dffgvhbbjk/2026-NUEDC/analysis_plots/summary_stats.png

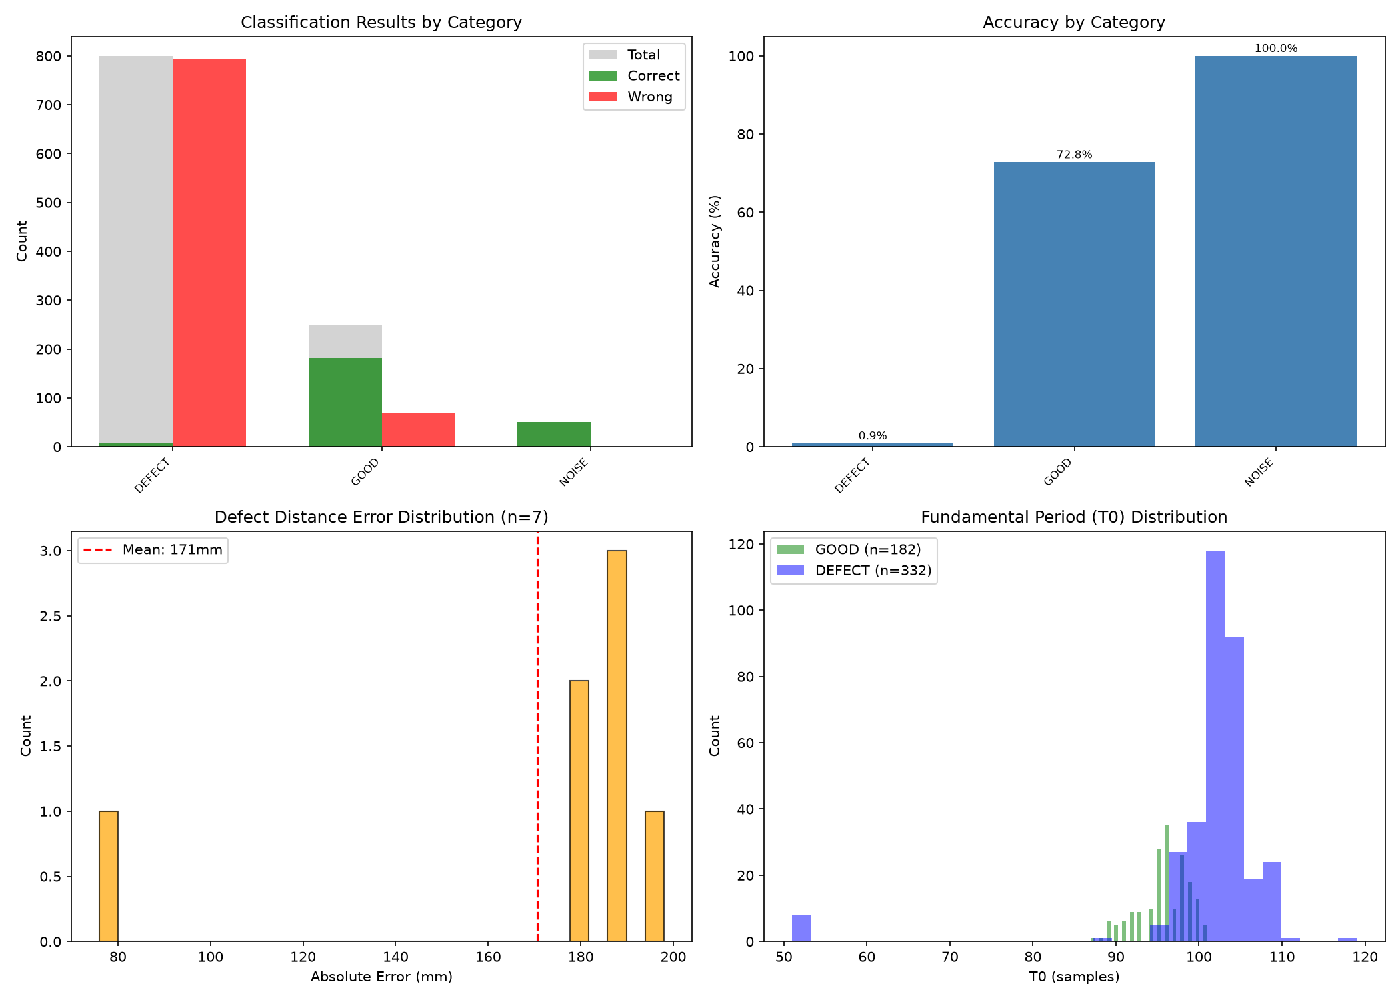
analysis_plots/summary_stats.png
