dffgvhbbjk/2026-NUEDC/analysis_plots/waveform_examples.png

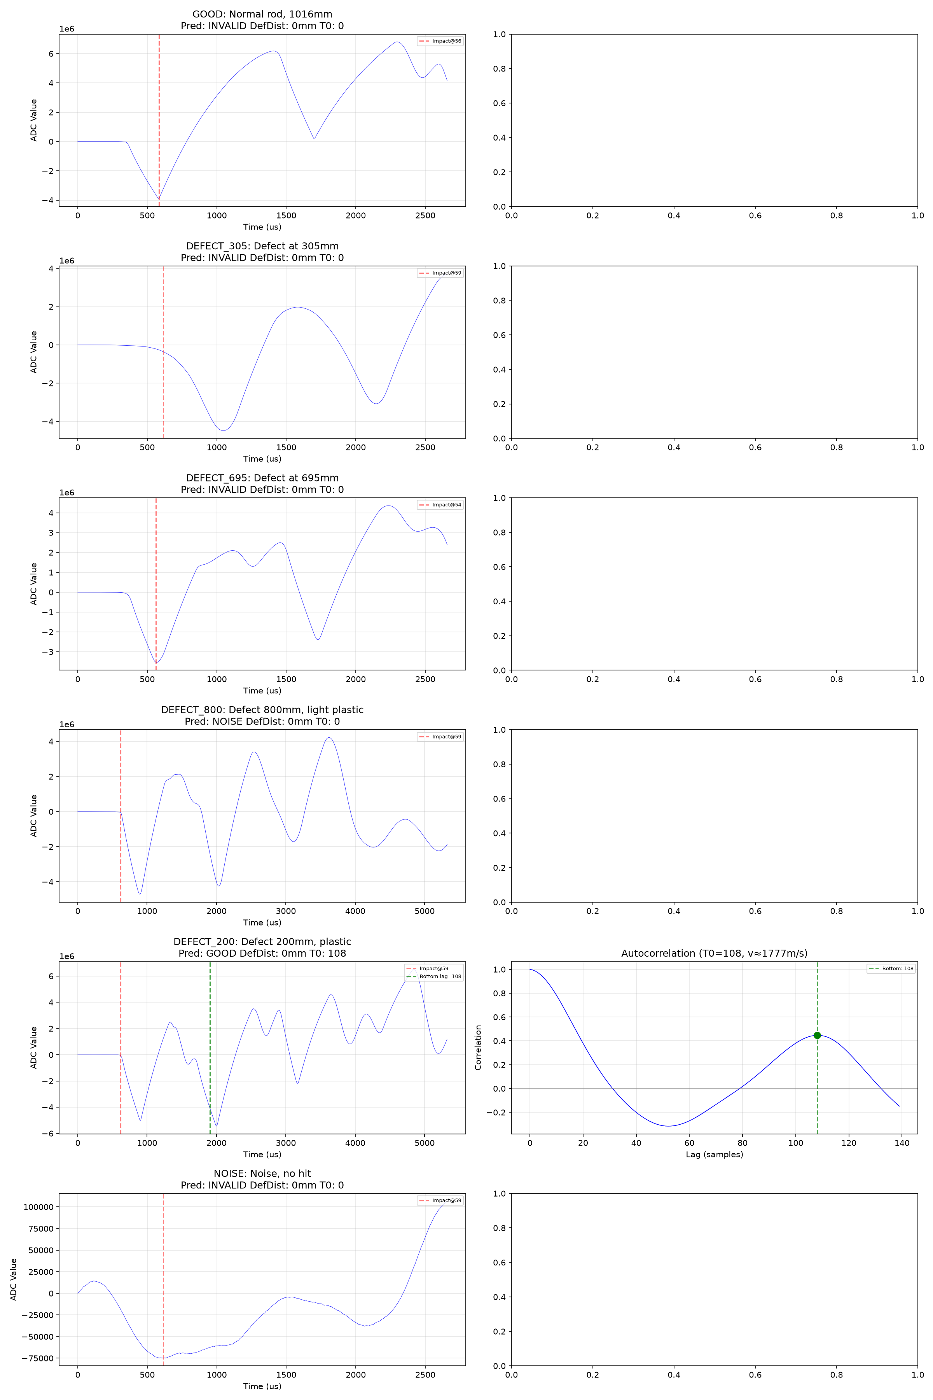
analysis_plots/waveform_examples.png
