dffgvhbbjk/2026-NUEDC/God1.0/ov5640_manual.txt

                           datasheet                         OV5640

                                 PRODUCT SPECIFICATION

1/4" color CMOS QSXGA (5 megapixel) image sensor
                                  with OmniBSITM technology

OV5640  color CMOS QSXGA (5 megapixel) image sensor with OmniBSITM technology

        00Copyright © 2011 OmniVision Technologies, Inc. All rights reserved.

                This document is provided "as is" with no warranties whatsoever, including any warranty of merchantability,
                non-infringement, fitness for any particular purpose, or any warranty otherwise arising out of any proposal, specification,
                or sample.
                OmniVision Technologies, Inc. and all its affiliates disclaim all liability, including liability for infringement of any proprietary
                rights, relating to the use of information in this document. No license, expressed or implied, by estoppel or otherwise, to
                any intellectual property rights is granted herein.
                The information contained in this document is considered proprietary to OmniVision Technologies, Inc. and all its
                affiliates. This information may be distributed to individuals or organizations authorized by OmniVision Technologies, Inc.
                to receive said information. Individuals and/or organizations are not allowed to re-distribute said information.

               Trademark Information

                OmniVision and the OmniVision logo are registered trademarks of OmniVision Technologies, Inc. OmniBSI is a
                trademark of OmniVision Technologies, Inc.
                All other trademarks used herein are the property of their respective owners.

        color CMOS QSXGA (5 megapixel) image sensor with OmniBSITM technology

        datasheet (CSP3)
        PRODUCT SPECIFICATION
        version 2.1
        july 2011

        To learn more about OmniVision Technologies, visit www.ovt.com.
        OmniVision Technologies is publicly traded on NASDAQ under the symbol OVTI.

                                                                                                                                   i

00applications                                                     ordering information

           cellular phones                                                 OV05640-A71A (color, lead-free)
           toys                                                            71-pin CSP3
           PC multimedia
           digital still cameras                                           support for LED and flash strobe mode
                                                                           support for horizontal and vertical sub-sampling,
00features                                                                 binning
                                                                           support for minimizing artifacts on binned image
           1.4 µm x 1.4 µm pixel with OmniBSI technology for               support for data compression output
           high performance (high sensitivity, low crosstalk, low          support for anti-shake
           noise, improved quantum efficiency)                             standard serial SCCB interface
           optical size of 1/4"                                            digital video port (DVP) parallel output interface and
           automatic image control functions: automatic                    dual lane MIPI output interface
           exposure control (AEC), automatic white balance                 embedded 1.5V regulator for core power
           (AWB), automatic band filter (ABF), automatic                   programmable I/O drive capability, I/O tri-state
           50/60 Hz luminance detection, and automatic black               configurability
           level calibration (ABLC)                                        support for black sun cancellation
           programmable controls for frame rate, AEC/AGC                   support for images sizes: 5 megapixel, and any
           16-zone size/position/weight control, mirror and flip,          arbitrary size scaling down from 5 megapixel
           cropping, windowing, and panning                                support for auto focus control (AFC) with embedded
           image quality controls: color saturation, hue, gamma,           AF VCM driver
           sharpness (edge enhancement), lens correction,                  embedded microcontroller
           defective pixel canceling, and noise canceling                  suitable for module size of 8.5 x 8.5 x <6mm with
           support for output formats: RAW RGB,                            both CSP and RW packaging
           RGB565/555/444, CCIR656, YUV422/420,
           YCbCr422, and compression
           support for video or snapshot operations
           support for internal and external frame
           synchronization for frame exposure mode

00key specifications (typical)                                     max S/N ratio: 36 dB (maximum)
                                                                   dynamic range: 68 dB @ 8x gain
           active array size: 2592 x 1944                          maximum image transfer rate:
           power supply:
                                                                      QSXGA (2592x1944): 15 fps
              core: 1.5V ± 5% (with embedded 1.5V regulator)          1080p: 30 fps
              analog: 2.6 ~ 3.0V (2.8V typical)                       1280x960: 45 fps
              I/O: 1.8V / 2.8V                                        720p: 60 fps
           power requirements:                                        VGA (640x480): 90 fps
              active: 140 mA                                          QVGA (320x240): 120 fps
              standby: 20 µA                                       sensitivity: 600 mV/Lux-sec
           temperature range:                                      shutter: rolling shutter / frame exposure
              operating: -30°C to 70°C junction temperature        maximum exposure interval: 1964 x tROW
              (see table 8-1)                                      pixel size: 1.4 µm x 1.4 µm
              stable image: 0°C to 50°C junction temperature       dark current: 8 mV/s @ 60°C junction temperature
              (see table 8-1)                                      image area: 3673.6 µm x 2738.4 µm
           output formats: 8-/10-bit RGB RAW output                package dimensions: 5985 µm x 5835 µm
           lens size: 1/4"
           lens chief ray angle: 24° (see figure 10-2)                            proprietary to OmniVision Technologies
           input clock frequency: 6~27 MHz

07.29.2011  PRODUCT SPECIFICATION

OV5640  color CMOS QSXGA (5 megapixel) image sensor with OmniBSITM technology

        proprietary to OmniVision Technologies  PRODUCT SPECIFICATION          version 2.1

                                                                                                        iii

00table of contents                                              1-1
                                                                 2-1
            1 signal descriptions                                2-1
            2 system level description                           2-1
                                                                 2-4
                2.1 overview                                     2-4
                2.2 architecture                                 2-6
                2.3 format and frame rate                        2-7
                2.4 I/O control                                  2-9
                2.5 system clock control                         2-9
                2.6 SCCB interface                              2-10
                2.7 power up sequence                           2-12
                                                                2-12
                      2.7.1 power up with internal DVDD          3-1
                      2.7.2 power up with external DVDD source   3-1
                2.8 reset                                        3-2
                2.9 hardware and software standby                3-3
            3 block level description                            3-3
                3.1 pixel array structure                        4-1
                3.2 binning                                      4-1
                3.3 VCM driver                                   4-2
                      3.3.1 output current control mode          4-4
            4 image sensor core digital functions                4-5
                4.1 mirror and flip                              4-5
                4.2 image windowing                              4-5
                4.3 test pattern                                 4-5
                4.4 50/60Hz detection                            4-6
                      4.4.1 overview                            4-10
                4.5 AEC/AGC algorithms                          4-10
                      4.5.1 overview                            4-10
                      4.5.2 average-based algorithm             4-11
                4.6 AEC/AGC steps                               4-11
                      4.6.1 auto exposure control (AEC)         4-12
                      4.6.2 manual exposure control
                      4.6.3 auto gain control (AGC)
                      4.6.4 manual gain control
                4.7 black level calibration (BLC)

07.29.2011  PRODUCT SPECIFICATION                               proprietary to OmniVision Technologies

OV5640  color CMOS QSXGA (5 megapixel) image sensor with OmniBSITM technology

            4.8 light frequency selection                                             4-13
            4.9 digital gain                                                          4-13
            4.10 strobe flash and frame exposure                                      4-14
                                                                                      4-14
                  4.10.1 strobe flash control                                         4-16
                  4.10.2 frame exposure (FREX) mode                                   4-17
                  4.10.3 FREX strobe flash control                                    4-18
            4.11 one time programmable (OTP) memory
        5 image sensor processor digital functions                                     5-1
            5.1 ISP general controls                                                   5-1
            5.2 lens correction (LENC)                                                 5-4
            5.3 auto white balance (AWB)                                               5-6
            5.4 raw gamma                                                              5-8
            5.5 defect pixel cancellation (DPC)                                        5-9
            5.6 color interpolation (CIP)                                             5-10
            5.7 color matrix (CMX)                                                    5-11
            5.8 UV average                                                            5-12
            5.9 scaling                                                               5-12
            5.10 UV adjust                                                            5-13
                  5.10.1 manual mode                                                  5-13
                  5.10.2 auto mode                                                    5-13
            5.11 special digital effects (SDE)                                        5-14
            5.12 ISP format                                                           5-15
            5.13 draw window                                                          5-15
        6 image sensor output interface digital functions                              6-1
            6.1 compression engine                                                     6-1
                  6.1.1 compression mode 1 timing                                      6-1
                  6.1.2 compression mode 2 timing                                      6-1
                  6.1.3 compression mode 3 timing                                      6-2
                  6.1.4 compression mode 4 timing                                      6-2
                  6.1.5 compression mode 5 timing                                      6-3
                  6.1.6 compression mode 6 timing                                      6-3
                  6.1.7 compression mode control                                       6-4
            6.2 system control                                                         6-5
            6.3 microcontroller unit (MCU)                                             6-8
            6.4 frame control (FC)                                                     6-9
            6.5 format description                                                    6-10

        proprietary to OmniVision Technologies  PRODUCT SPECIFICATION          version 2.1

                                                                           v

    6.6 digital video port (DVP)                             6-15
          6.6.1 overview                                     6-15
          6.6.2 DVP timing                                   6-18
                                                             6-20
    6.7 mobile industry processor interface (MIPI)
7 register tables                                             7-1
                                                              7-1
    7.1 system and IO pad control [0x3000 ~ 0x3052]           7-7
    7.2 SCCB control [0x3100 ~ 0x3108]                        7-8
    7.3 SRB control [0x3200 ~ 0x3211]                         7-9
    7.4 AWB gain control [0x3400 ~ 0x3406]                   7-10
    7.5 AEC/AGC control [0x3500 ~ 0x350D]                    7-11
    7.6 VCM control [0x3600 ~ 0x3606]                        7-11
    7.7 timing control [0x3800 ~ 0x3821]                     7-13
    7.8 AEC/AGC power down domain control [0x3A00 ~ 0x3A25]  7-16
    7.9 strobe control [0x3B00 ~ 0x3B0C]                     7-18
    7.10 50/60Hz detector control [0x3C00 ~ 0x3C1E]          7-19
    7.11 OTP control [0x3D00 ~ 0x3D21]                       7-21
    7.12 MC control [0x3F00 ~ 0x3F0D]                        7-23
    7.13 BLC control [0x4000 ~ 0x4033]                       7-25
    7.14 frame control [0x4201 ~ 0x4202]                     7-26
    7.15 format control [0x4300 ~ 0x430D]                    7-31
    7.16 JPEG control [0x4400 ~ 0x4431]                      7-33
    7.17 VFIFO control [0x4600 ~ 0x460D]                     7-34
    7.18 DVP control [0x4709 ~ 0x4745]                       7-38
    7.19 MIPI control [0x4800 ~ 0x4837]                      7-41
    7.20 ISP frame control [0x4901 ~ 0x4902]                 7-41
    7.21 ISP top control [0x5000 ~ 0x5063]                   7-46
    7.22 AWB control [0x5180 ~ 0x51D0]                       7-48
    7.23 CIP control [0x5300 ~ 0x530F]                       7-49
    7.24 CMX control [0x5380 ~ 0x538B]                       7-50
    7.25 gamma control [0x5480 ~ 0x5490]                     7-51
    7.26 SDE control [0x5580 ~ 0x558C]                       7-53
    7.27 scale control [0x5600 ~ 0x5606]                     7-54
    7.28 AVG control [0x5680 ~ 0x56A2]                       7-56
    7.29 LENC control [0x5800 ~ 0x5849]                      7-61
    7.30 AFC control [0x6000 ~ 0x603F]

07.29.2011  PRODUCT SPECIFICATION  proprietary to OmniVision Technologies

OV5640  color CMOS QSXGA (5 megapixel) image sensor with OmniBSITM technology

        8 operating specifications                                              8-1
            8.1 absolute maximum ratings                                        8-1
            8.2 functional temperature                                          8-1
            8.3 DC characteristics                                              8-2
            8.4 AC characteristics                                              8-4
                                                                                9-1
        9 mechanical specifications                                             9-1
            9.1 physical specifications                                         9-2
            9.2 IR reflow specifications                                       10-1
                                                                               10-1
        10 optical specifications                                              10-2
            10.1 sensor array center
            10.2 lens chief ray angle (CRA)

        proprietary to OmniVision Technologies  PRODUCT SPECIFICATION          version 2.1

                                                                                                   vii

00list of figures

figure 1-1   pin diagram                                                                      1-4
figure 2-1   OV5640 block diagram                                                             2-2
figure 2-2   reference design schematic                                                       2-3
figure 2-3   PLL diagram                                                                      2-6
figure 2-4   power up timing with internal DVDD                                              2-10
figure 2-5   power up timing with external DVDD source                                       2-11
figure 3-1   sensor array region color filter layout                                          3-1
figure 3-2   example of 2x2 binning                                                           3-2
figure 3-3   VCM block diagram                                                                3-3
figure 3-4   1/4 to 3/4 scale settling time (directly jump mode, VDD = 3.0V)                  3-6
figure 3-5   sink current vs. code (VDD = 3.0V, reg 0x30A5 = 0x05, VCM resistance = 23ohms)   3-6
figure 4-1   mirror and flip samples                                                          4-1
figure 4-2   image windowing                                                                  4-2
figure 4-3   image windowing configuration                                                    4-3
figure 4-4   test pattern                                                                     4-4
figure 4-5   desired convergence                                                              4-6
figure 4-6   average-based window definition                                                  4-8
figure 4-7   xenon flash mode                                                                4-14
figure 4-8   LED 1 & 2 mode - one pulse output                                               4-15
figure 4-9   LED 1 & 2 mode - multiple pulse output                                          4-15
figure 4-10  LED 3 mode                                                                      4-16
figure 4-11  FREX modes                                                                      4-16
figure 5-1   UV adjust graph                                                                 5-13
figure 6-1   compression mode 1 timing                                                        6-1
figure 6-2   compression mode 2 timing                                                        6-1
figure 6-3   compression mode 3 timing                                                        6-2
figure 6-4   compression mode 4 timing                                                        6-2
figure 6-5   compression mode 5 timing                                                        6-3
figure 6-6   compression mode 6 timing                                                        6-3
figure 6-7   DVP timing diagram                                                              6-18
figure 8-1   SCCB interface timing                                                            8-5
figure 9-1   package specifications                                                           9-1

07.29.2011         PRODUCT SPECIFICATION  proprietary to OmniVision Technologies

OV5640  color CMOS QSXGA (5 megapixel) image sensor with OmniBSITM technology

        figure 9-2   IR reflow ramp rate requirements                           9-2
        figure 10-1  sensor array center                                       10-1
        figure 10-2  chief ray angle (CRA)                                     10-2

        proprietary to OmniVision Technologies         PRODUCT SPECIFICATION   version 2.1

00list of tables                                                                                                         ix

         table 1-1 signal descriptions                                     1-1
         table 2-1 format and frame rate                                   2-4
         table 2-2 driving capability and direction control for I/O pads   2-4
         table 2-3 PLL configurations                                      2-6
         table 2-4 group sharing registers                                 2-7
         table 2-5 group write registers                                   2-7
         table 3-1 binning-related registers                               3-2
         table 3-2 VCM driver control                                      3-4
         table 3-3 VCM control registers                                   3-4
         table 3-4 single step mode                                        3-5
         table 3-5 multi-code step mode                                    3-5
         table 4-1 mirror and flip registers                               4-1
         table 4-2 image windowing registers                               4-3
         table 4-3 test pattern selection control                          4-4
         table 4-4 AEC/AGC algorithm functions                             4-5
         table 4-5 AEC functions                                           4-7
         table 4-6 timing control functions                                4-8
         table 4-7 BLC control functions                                  4-12
         table 4-8 light frequency registers                              4-13
         table 4-9 flashlight modes                                       4-14
         table 4-10 FREX strobe control functions                         4-17
         table 4-11 OTP control functions                                 4-18
         table 5-1 ISP general control registers                           5-1
         table 5-2 LENC control registers                                  5-4
         table 5-3 AWB control registers                                   5-6
         table 5-4 raw gamma control registers                             5-8
         table 5-5 DPC control registers                                   5-9
         table 5-6 CIP control registers                                  5-10
         table 5-7 CMX control registers                                  5-11
         table 5-8 UV average register                                    5-12
         table 5-9 UV average register                                    5-12
         table 5-10 SDE control registers                                 5-14

07.29.2011  PRODUCT SPECIFICATION                                         proprietary to OmniVision Technologies

OV5640  color CMOS QSXGA (5 megapixel) image sensor with OmniBSITM technology

        table 5-11 ISP format control registers                                5-15
        table 5-12 draw window registers                                       5-15
        table 6-1 compression control registers
        table 6-2 system control registers                                      6-4
        table 6-3 MCU control registers                                         6-5
        table 6-4 FC control registers                                          6-8
        table 6-5 format control registers                                      6-9
        table 6-6 DVP control registers                                        6-10
        table 6-7 DVP timing specifications                                    6-15
        table 6-8 MIPI transmitter registers                                   6-18
        table 7-1 system and IO pad control registers                          6-20
        table 7-2 SCCB control registers                                        7-1
        table 7-3 SRB control registers                                         7-7
        table 7-4 AWB gain control registers                                    7-8
        table 7-5 AEC/AGC control registers                                     7-9
        table 7-6 VCM control registers                                        7-10
        table 7-7 timing control registers                                     7-11
        table 7-8 AEC/AGC power down domain control registers                  7-11
        table 7-9 strobe registers                                             7-13
        table 7-10 5060Hz detector registers                                   7-16
        table 7-11 OTP control functions                                       7-18
        table 7-12 MC registers                                                7-19
        table 7-13 BLC registers                                               7-21
        table 7-14 frame control registers                                     7-23
        table 7-15 format control registers                                    7-25
        table 7-16 JPEG control registers                                      7-26
        table 7-17 VFIFO registers                                             7-31
        table 7-18 DVP control registers                                       7-33
        table 7-19 MIPI transmitter registers                                  7-34
        table 7-20 ISP frame control registers                                 7-38
        table 7-21 ISP top control registers                                   7-41
        table 7-22 AWB registers                                               7-41
        table 7-23 CIP control registers                                       7-46
        table 7-24 CMX control registers                                       7-48
        table 7-25 gamma control registers                                     7-49
                                                                               7-50

        proprietary to OmniVision Technologies  PRODUCT SPECIFICATION          version 2.1

table 7-26 SDE control registers                                                                       xi
table 7-27 scale registers
table 7-28 AVG registers                                7-51
table 7-29 LENC control registers                       7-53
table 7-30 AFC control registers                        7-54
table 8-1 absolute maximum ratings                      7-56
table 8-2 functional temperature                        7-61
table 8-3 DC characteristics (-30°C < TJ < 70°C)
table 8-4 AC characteristics (TA = 25°C, VDD-A = 2.8V)   8-1
table 8-5 timing characteristics                         8-1
table 8-6 SCCB interface timing specifications           8-2
table 9-1 package dimensions                             8-4
table 9-2 reflow conditions                              8-4
table 10-1 CRA versus image height plot                  8-5
                                                         9-1
                                                         9-2
                                                        10-2

07.29.2011  PRODUCT SPECIFICATION                       proprietary to OmniVision Technologies

OV5640  color CMOS QSXGA (5 megapixel) image sensor with OmniBSITM technology

        proprietary to OmniVision Technologies  PRODUCT SPECIFICATION          version 2.1

                                                                                                                          1-1

1 signal descriptions

    table 1-1 lists the signal descriptions and their corresponding pin numbers for the OV5640 image sensor. The package
    information is shown in section 9.

table 1-1   signal descriptions (sheet 1 of 3)

  pin       signal name  pin        description
  number                 type
            VCMSINK                 analog I/O
   A2       AVDD         I/O        power for analog circuit
   A3       AGND         power      ground for analog circuit
   A4       DGND         ground     ground for digital circuit
   A5       NC           ground     no connect
   A6       NC           -          no connect
   A7       NC           -          no connect
   A8       DVDD         -          power for digital circuit
   A9       AGND         power      ground for analog circuit
   A10      NC           ground     no connect
   A11      DGND         -          ground for digital circuit
   B1       VCMSINK      ground     analog I/O
   B2       VCMGND       I/O        analog I/O
   B3       VCMGND       I/O        analog I/O
   B4       DVDD         I/O        power for digital circuit
   B5       NC           power      no connect
   B6       NC           -          no connect
   B7       NC           -          no connect
   B8       DGND         -          ground for digital circuit
   B9       AVDD         ground     power for analog circuit
   B10      VN           power      internal analog reference
   B11      DVDD         reference  power for digital circuit
   C1       DGND         power      ground for digital circuit
   C2       NC           ground     no connect
   C3       VH           -          internal analog reference
   C10                   reference

07.29.2011  PRODUCT SPECIFICATION               proprietary to OmniVision Technologies

OV5640  color CMOS QSXGA (5 megapixel) image sensor with OmniBSITM technology

        table 1-1  signal descriptions (sheet 2 of 3)

          pin      signal name  pin             description
          number                type
                   AVDD                         power for analog circuit
           C11     PWDN         power           power down (active high with internal pull-down resistor)
           D1      DVDD         input           power for digital circuit
           D2      NC           power           no connect
           D10     AGND         -               ground for analog circuit
           D11     STROBE       ground          strobe output
           E1      RESETB       I/O             reset (active low with internal pull-up resistor)
           E2      NC           input           no connect
           E10     NC           -               no connect
           E11     GPIO0        -               GPIO port 0
           F1      FREX         I/O             frame exposure / mechanical shutter
           F2      NC           I/O             no connect
           F10     SGND         -               ground for sensor circuit
           F11     GPIO1        ground          GPIO port 1
           G1      DOGND        I/O             ground for I/O circuit
           G2      SIOC         ground          SCCB input clock
           G10     SIOD         input           SCCB data
           G11     VSYNC        I/O             DVP VSYNC output
           H1      HREF         I/O             DVP HREF output
           H2      D3           I/O             DVP data output port 3
           H10     XVCLK        I/O             system input clock
           H11     PCLK         input           DVP PCLK output
           I1      DGND         I/O             ground for digital circuit
           I2      D6/MCN       ground          DVP data output port 6/ MIPI TX clock lane negative output
           I8      D7/MCP       I/O             DVP data output port 7/ MIPI TX clock lane positive output
           I9      PVDD         I/O             power for PLL circuit
           I10     DVDD         power           power for digital circuit
           I11     DVDD         power           power for digital circuit
           J1      DOVDD        power           power for I/O circuit
           J2      DOVDD        power           power for I/O circuit
           J3                   power

        proprietary to OmniVision Technologies  PRODUCT SPECIFICATION          version 2.1

                                                                                                     1-3

table 1-1   signal descriptions (sheet 3 of 3)
  pin
  number    signal name  pin        description
                         type
   J4       DOGND                   ground for I/O circuit
   J5       D2           ground     DVP data output port 2
   J6       NC           I/O        no connect
   J7       EVDD         -          power for MIPI TX circuit
                         reference  DVP data output port 8/ MIPI TX second data lane negative
   J9       D8/MDN1                 output
                         I/O        DVP data output port 9/ MIPI TX second data lane positive
   J10      D9/MDP1                 output
                         I/O        ground for I/O circuit
   J11      DOGND                   power for digital circuit
   K1       DVDD         ground     power for I/O circuit
   K2       DOVDD        power      power for I/O circuit
   K3       DOVDD        power      DVP data output port 1/ GPIO port 3
   K4       D1/GPIO3     power      DVP data output port 0/ GPIO port 2
   K5       D0/GPIO2     I/O        DVP data output port 4/ MIPI TX first data lane negative output
   K6       D4/MDN0      I/O        DVP data output port 5/ MIPI TX first data lane positive output
   K7       D5/MDP0      I/O        ground for MIPI TX circuit
   K8       EGND         I/O        ground for MIPI TX circuit
   K11      EGND         ground
                         ground

07.29.2011  PRODUCT SPECIFICATION               proprietary to OmniVision Technologies

OV5640  color CMOS QSXGA (5 megapixel) image sensor with OmniBSITM technology

        figure 1-1 pin diagram

                                A2 A3 A4 A5 A6 A7 A8 A9 A10 A11

                                VCMSINK AVDD AGND DGND NC  NC                            NC DVDD AGND NC

        B1 B2 B3 B4 B5 B6 B7 B8 B9 B10 B11

        DGND VCMSINK VCMGND VCMGND DVDD NC                 NC                            NC DGND AVDD VN

         C1 C2 C3                                                                                  C10 C11
        DVDD DGND NC                                                                               VH AVDD

         D1                      D2                                                                D10 D11
        PWDN                    DVDD                                                               NC AGND

          E1 E2                                                                                    E10 E11
        STROBE RESETB
                                                                                                   NC        NC

         F1                      F2             OV5640                                             F10 F11
        GPIO0                   FREX                                                               NC SGND

         G1 G2                                                                                     G10       G11
        GPIO1 DOGND                                                                                SIOC      SIOD

          H1                     H2                                                                H10 H11
        VSYNC                   HREF                                                               D3 XVCLK

         I1                       I2                                                     I8    I9  I10        I11
        PCLK                    DGND                                                                         DVDD
                                                                                         D6/MCN D7/MCP PVDD

         J1 J2 J3 J4 J5                         J6 J7                                            J9 J10 J11
        DVDD DOVDD DOVDD DOGND D2               NC EVDD                                        D8/MDN1 D9/MDP1 DOGND

         K1                       K2              K3 K4 K5 K6 K7                          K8                  K11
        DVDD                    DOVDD           DOVDD D1/GPIO3 D0/GPIO4 D4/MDN0 D5/MDP0  EGND                EGND

                                                                                                             5640 CSP DS 1 1

        proprietary to OmniVision Technologies  PRODUCT SPECIFICATION                                                         version 2.1

                                                                                                                                                                                                      2-1

2 system level description

2.1 overview

    The OV5640 (color) image sensor is a low voltage, high-performance, 1/4-inch 5 megapixel CMOS image sensor that
    provides the full functionality of a single chip 5 megapixel (2592x1944) camera using OmniBSITM technology in a small
    footprint package. It provides full-frame, sub-sampled, windowed or arbitrarily scaled 8-bit/10-bit images in various
    formats via the control of the Serial Camera Control Bus (SCCB) interface.
    The OV5640 has an image array capable of operating at up to 15 frames per second (fps) in 5 megapixel resolution with
    complete user control over image quality, formatting and output data transfer. All required image processing functions,
    including exposure control, gamma, white balance, color saturation, hue control, defective pixel canceling, noise
    canceling, etc., are programmable through the SCCB interface or embedded microcontroller. The OV5640 also includes
    a compression engine for increased processing power. In addition, OmniVision image sensors use proprietary sensor
    technology to improve image quality by reducing or eliminating common lighting/electrical sources of image
    contamination, such as fixed pattern noise, smearing, etc., to produce a clean, fully stable, color image.
    The OV5640 has an embedded microcontroller, which can be combined with an internal autofocus engine and
    programmable general purpose I/O modules (GPIO) for external autofocus control. It also provides an anti-shake
    function with an internal anti-shake engine. For identification and storage purposes, the OV5640 also includes a one-time
    programmable (OTP) memory.
    The OV5640 supports both a digital video parallel port and a serial MIPI port.

2.2 architecture

    The OV5640 sensor core generates streaming pixel data at a constant frame rate, indicated by HREF and VSYNC.
    figure 2-1 shows the functional block diagram of the OV5640 image sensor.
    The timing generator outputs signals to access the rows of the image array, precharging and sampling the rows of the
    array in series. In the time between pre-charging and sampling a row, the charge in the pixels decreases with the time
    exposed to the incident light. This is known as exposure time.
    The exposure time is controlled by adjusting the time interval between precharging and sampling. After the data of the
    pixels in the row has been sampled, it is processed through analog circuitry to correct the offset and multiply the data
    with corresponding gain. Following analog processing is the ADC which outputs 10-bit data for each pixel in the array.

07.29.2011  PRODUCT SPECIFICATION  proprietary to OmniVision Technologies

OV5640  color CMOS QSXGA (5 megapixel) image sensor with OmniBSITM technology

        figure 2-1 OV5640 block diagram

              image sensor core                 OV5640                                            image output
                                                                                                    interface
           column                                                    image sensor
        sample/hold                                                    processor

        row selectimage AMP                     10-bit                                                                      D[9:0]
                                                                         ISParrayADC
                                                                                                                            MCP/N
                                                                               compression                                  MDP/N[1:0]
                                                                                  engine

                                                                                        formatter
                                                                                                       FIFO

                                                                                                                  MIPI DVP

           50/60 Hz      gain
        auto detection  control

                                                                                         control register bank
        PLL timing generator MIPI SCCB micro and system control logic interface interface controller VCM

        XVCLK                                                                                                               5640_DS_2_1
                PWDN
                       RESETB
                             FREX
                                   GPIO[3:0]
                                          PCLK
                                                HREF
                                                       VSYNC
                                                             STROBE

                                                                                      SIOC
                                                                                            SIOD

        proprietary to OmniVision Technologies          PRODUCT SPECIFICATION                                               version 2.1

                                                                                                                                                                                                                                                                                                                2-3

figure 2-2 reference design schematic

                                               DOVDD                 EVDD                                                                          DVDD

                                               C1 1F-0603                                                                                                       C2 1F-0603
                                                                                                                 C9 0.1F-0603

                                                           D1                                                                                                                                           10-0603 RESETB                                                                            10-0603 PWDN
                                                                     D0
                                                                          D2
                                                                               D4/MDN0
                                                                                    D5/MDP0
                                                                                         EVDD
                                                                                                    D6/MCN
                                                                                                         D7/MCP

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
                                                                                                                               NC C3                                                                                 GPIO1 25                                                        24 D0
                                                                                                                                    NC J6                                                                                                                                            26 GPIO0
                                    A6 NC                                                                                               NC F10                                                                                     27                                                28 VCMSINK
                                    K1 DVDD                                                                                             NC E10                                                                       STROBE 29R2                                                     30 FREX      R1
                                    J1 DVDD                                                                                         DGND B9
R4                                   I2 DGND                                                                                   D8/MDN1 J9          D8/MDN1                                                                         31  J1CON32A                                      32
                                     I1 PCLK                                                                                   D9/MDP1 J10         D9/MDP1
                            HREF    H2 HREF                      U1                                                                 EGND K11                                                      PVDD     PGND                                                                                   0-0603
                            VSYNC   H1 VSYNC                                                                                        PVDD I10            PVDD                 C8 0.1F-0603
                                    G2 DOGND               OV5640                                                                 DOGND J11
                            GPIO1   G1 GPIO1               CSP BSI                                                                  DVDD I11                D3               0-0603
                            GPIO0   F1 GPIO0                                                                                            D3 H10           XCLK
                            FREX    F2 FREX                                                                                        XVCLK H11             SIOC                                                                                                                                     XCLK R3
                            STROBE  E1 STROBE                                                                                        SIOC G10            SIOD
                            RESETB  E2 RESETB                                                                                        SIOD G11
                            PWDN    D1 PWDN                                                                                         SGND F11                R5
                                    D2 DVDD                                                                                         AGND D11
                                    C1 DVDD                                                                                         AVDD C11                                                                                      Do not assemble R1 and R2.
                                    B8 NC                                                                                               NC E11
                                    B7 NC
                                         B6 NC                                                                                                                                                                                                                                              EVDD
                                              C2 DGND                                                                                                                                                                                                                                0-0603
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
          AVDD                                                                                                                                                                                                              AGND

                                                                                                                                                                                                        PGND is system ground (power ground - GND).
                                                                                                                                                                                                        AGND and DGND are sensor analog and digital grnd.
                                                                                                                                                                                                        Connect different ground plants to a single point.

                                               VDD 2.8V                     DVDD 1.5V  DOVDD
                                                                 3.3H-1206
                            L2               3.3H-1206 L1
                                                           FB-0805
                            L3               3.3H-1206

             C10 0.1F-0603                     U2                                                                                          D9 R6   0-0603                    D9/MDP1 6                                  AGND      1
                       AGND C11 10F/6V-EIA-AXC6206P152PR 1.5V                                                                              D8 R7   0-0603                    D8/MDN1 5
                                                                                                                                           D7 R8   0-0603                    D7/MCP 4
                                 C14 1F-06032 VINOUT 3 L4                                                                                  D6 R9   0-0603                    D6/MCN 3                                   VCMGND 2
                                                                                                  C15 0.1F-06031 GND                       D5 R10  0-0603                    D5/MDP0 2
                                                                                                             DGND C16 10F/6V-EIA-A         D4 R11  0-0603                    D4/MDN0 1                                  DGND      3
                                                                                                                       C12 0.1F-0603
                                                                                                                                 DGND C13 10F/6V-EIA-A

                                                                                                                                                                                                                J2 HEADER6X1
                                                                                                                                                                                                                                                                       J3 HEADER3X1

                                                                                                                                                                                                                                                                                     5640_CSP_DS_2_2

07.29.2011                                               PRODUCT SPECIFICATION                                                                                               proprietary to OmniVision Technologies

OV5640  color CMOS QSXGA (5 megapixel) image sensor with OmniBSITM technology

        2.3 format and frame rate

        table 2-1  format and frame rate

        format     resolution    frame  scaling           DVP (PCLK, MHz)          MIPI (total bit rate, Mbps)
                                 rate   method           Raw YUV222              Raw10 Raw8 YUV422
        5 Mp       2592x1944     (fps)
        SXGA       1280x960             no scaling       84       84 (7.5 fps)   840        672  1344
        1080p      1920x1080     15
        720p                            2x2 binning      84       84 (22.5 fps)  840        672  1344
                                 45
        VGA                             cropping         84       84 (15 fps     840        672  1344
                                 30
        QVGA                            cropping +
                   1280x720 60          2x2 binning      84       84 (30 fps)    840        672  1344

                   640x480       90     2x2 binning +    42       84             420        336  672
                                        2x2 skip
                   320x240       120                     21       42             210        168  336
                                        2x2 binning +
                                        4x4 skip

        2.4 I/O control

            The OV5640 I/O pad direction and driving capability can be easily adjusted. table 2-2 lists the driving capability and
            direction control registers of the I/O pads.

        table 2-2  driving capability and direction control for I/O pads (sheet 1 of 2)

        function                     register      default value  R/W          description

        output drive capability      0x302C        0x02           RW             Bit[7:6]:  output drive capability
        control                                                                             00: 1x
                                                                                            01: 2x
                                                                                            10: 3x
                                                                                            11: 4x

                                                                               input/output control for the D[9:0] pins
                                                                                  0: input
                                                                                  1: output

        D[9:0] I/O control           0x3017[3:0],  0x00           RW D9 share with MD2P pin for MIPI
                                     0x3018[7:2]                               D8 share with MD2N pin for MIPI
                                                                               D7 share with MCP pin for MIPI
                                                                               D6 share with MCN pin for MIPI
                                                                               D5 share with MD1P pin for MIPI
                                                                               D4 share with MD1N pin for MIPI

        proprietary to OmniVision Technologies           PRODUCT SPECIFICATION                   version 2.1

                                                                                                2-5

table 2-2   driving capability and direction control for I/O pads (sheet 2 of 2)

function              register      default value  R/W  description

D[9:0] output select  0x301D[3:0],  0x00           RW   output selection for the D[9:0] pins
D[9:0] output value   0x301E[7:2]   0x00           RW      0: normal data path
D[9:0] input value    0x301A[3:0],  -              R       1: register-controlled value
VSYNC I/O control     0x301B[7:2]   0x00           RW
                      0x3051[3:0],                      D[9:0] output value
VSYNC output select   0x3052[7:2]   0x00           RW
VSYNC output value    0x3017        0x00           RW   D[9:0] input value
VSYNC input value                   -              R
HREF I/O control      0x301D        0x00           RW   Bit[6]:  input/output control for
                                                                 the VSYNC pin
HREF output select    0x301A        0x00           RW   Bit[6]:  0: input
HREF output value     0x3051        0x00           RW            1: output
HREF input value      0x3017        -              R    Bit[6]:
PCLK I/O control                    0x00           RW   Bit[6]:  output selection for the
                      0x301D                            Bit[5]:  VSYNC pin
PCLK output select                  0x00           RW            0: normal data path
PCLK output value     0x301A        0x00           RW   Bit[5]:  1: register-controlled
PCLK input value      0x3051        -              R
                      0x3017                            Bit[5]:         value
                                                        Bit[5]:
                      0x301D                            Bit[4]:  VSYNC output value

                      0x301A                            Bit[4]:  VSYNC input value
                      0x3051
                                                        Bit[4]:  input/output control for
                                                        Bit[4]:  the HREF pin
                                                                 0: input
                                                                 1: output

                                                                 output selection for the
                                                                 HREF pin
                                                                 0: normal data path
                                                                 1: register-controlled

                                                                        value

                                                                 HREF output value

                                                                 HREF input value

                                                                 input/output control for
                                                                 the PCLK pin
                                                                 0: input
                                                                 1: output

                                                                 output selection for the
                                                                 PCLK pin
                                                                 0: normal data path
                                                                 1: register-controlled

                                                                        value

                                                                 PCLK output value

                                                                 PCLK input value

07.29.2011            PRODUCT SPECIFICATION             proprietary to OmniVision Technologies

OV5640  color CMOS QSXGA (5 megapixel) image sensor with OmniBSITM technology

        2.5 system clock control

        The OV5640 PLL allows for an input clock frequency ranging from 6~27 MHz and has a maximum VCO frequency of
        1000 MHz.

        figure 2-3 PLL diagram

                                                                                                       PLL1

                                                        CLK_PAD                         pre-divider    (4~27 MHz)    multiplier (4~252)   (500~1000 MHz)  SYS divider0              MIPI divider
                                                        XVCLK                            PRE_DIV0                        DIV_CNT7B                            SDIV0                   MIPI_DIV
                                                                                        (3037[3:0])                       (3036[7:0])                                               (3035[3:0])
                                                                    (6~27 MHz)      1/1/2/3/4/1.5/6/                                                       (3035[7:4])               (0:16; 1~F)
                                                                                  2.5/8/1/1/1/1/1/1/1              3037[7] ? 3036[7:1]*2                   (0:16; 1~F)               3035[3:0]
                                                                                                                          : 3036[6:0]                       3035[7:4]
                                                                                                                                                                                             MIPISCLK

                                                                                                                                                           PLL R divider            MIPI_PHY               MIPI_CLK
                                                                                                                                                              PLL_RDIV                   /2
                                                                                                                                                              (3037[4])
                                                                                                                                                                  1/2               SCLK divider           SCLK
                                                                                                                                                                                      SCLK_DIV
                                                                                                                                                             BIT divider             (3108[1:0])
                                                                                                                                                               BIT_DIV                 1/2/4/8

                                                                                                                                                             (3034[3:0])
                                                                                                                                                          (0x8: 2; 0xA: 2.5,

                                                                                                                                                              others: 1)

                                                                                                                                                          PCLK divider              SCLK2x divider         SCLK2x
                                                                                                                                                            PCLK_DIV                  SCLK2x_DIV
                                                                                                                                                           (3108[5:4])                 (3108[3:2])
                                                                                                                                                             1/2/4/8                    1/2/4/8

                                                                                                                                                            P divider         PCLK        scale divider    DIV_PCLK
                                                                                                                                                              P_DIV                        SCALE_DIV
                                                                                                       PLL2                                                                                (3824[4:0])
                                                                                                                                                          mipi2lane ?                   (460c[1] | JPG)?
                                                                                                       (6~27 MHz)                                          r3035[3:0]:              INT(3824[4:0]/2):Auto
                                                                                                                                                          2*r3035[3:0]

                                                        (6~27 MHz)                pre-divider                      multiplier                             R_SELD5 divider                              PLLADCLK
                                                                                  PRE_DIV_SP                        R_DIV_SP                                  DIV12_SP                            (190~230 MHz)
                                                                                  (303d[5:4])                       (303d[2])                                (303d[1:0])
                                                                                  1/1.5/2//3                                                                  1/1/2/2.5
                                                                                                                       x 1/2
        note 1 input clock (XVCLK) range is 6~27 MHz
                                                                                                                   multiplier
        note 2 clock after predivider for PLL1 is 4~27 MHz, for PLL2 is 6~27 MHz                                   DIV_CNT5B
                                                                                                                   (303b[4:0])
        note 3 PLL1 output clock range 500~1000 MHz                                                                 303b[4:0]                             SP divider
                                                                                                                                                           SDIV_SP
        note 4 PLLADCLK output clock range 190~230 MHz                                                                                                    (303c[3:0])
                                                                                                                                                           (0:1; 1~F)
        note 5 PCLK >=1*SCLK if Raw or JPEG, PCLK >=2*SCLK if YUV                                                                         (160~320 MHz)   303c[3:0]

        note 6 MIPSCLK = (4 or 5)*PCLK if 2lane; = (8 or 10) *PCLK if 1lane

        note 7 changing register 0x3108 (gray blks) is not recommended without OmniVision approval

        note 8 to run full size and full speed, adclk~200 MHz, sclk~84 MHz

        note 9 exposure unit line_period = HTS/(sclk), where HTS=380C/380D

        note 10 frame time is line_period * VTS, where VTS=380E/380F

        note 11 MIPI global timing unit (0x4837) should be set based on PCLK                                                                                                                               5640_DS_2_3

        table 2-3      PLL configurations

        configuration  register                         register                  register             register                 register register                             register            register
                       0x3034                           0x3035                    0x3036               0x3037                   0x3108a 0x303B                                0x303C              0x303D

        default        0x1A                             0x11                      0x69                 0x13                     0x16                      0x19                0x11                0x30
        DVP sampleb    0x1A                             0x11                      0x69                 0x13                     0x01                      0x19                0x11                0x30

        MIPI 8-bit     0x18                             0x11                      0x54                 0x13                     0x01                      0x19                0x11                0x30

        a. register 0x3108 shall be kept at 0x01 for all settings due to the relation constraints of the different internal clocks
        b. sample settings are for 24MHz MCLK, sensor output of 5 Mpixel at 15 fps, DVP sample is for 10-bit/8-bit, MIPI sam-

              ple is for 8-bit setting

        proprietary to OmniVision Technologies                                                         PRODUCT SPECIFICATION                                                                  version 2.1

                                                                                                                           2-7

2.6 SCCB interface

    The Serial Camera Control Bus (SCCB) interface controls the image sensor operation. Refer to the OmniVision
    Technologies Serial Camera Control Bus (SCCB) Specification for detailed usage of the serial control port.
    Group write is supported in order to update a group of registers in the same frame. These registers are guaranteed to
    be written prior to the internal latch at the frame boundary.
    The OV5640 supports up to four groups. These groups share 1 KB RAM and the size of each group is programmable by
    adjusting the start address. The group hold start addresses range from 0x40 to 0x7F, where the unit is 16 bytes.

table 2-4   group sharing registers
  address
            register name            default                R/W  description
   0x3200                            value
   0x3201                                                   RW   Start Address for Group0
   0x3202   GROUP ADDR0              0x40                   RW   {group_addr0[7:0], 4'h0}
   0x3203                                                   RW
            GROUP ADDR1              0x4A                   RW   Start Address for Group1
                                                                 {group_addr1[7:0], 4'h0}
            GROUP ADDR2              0x54
                                                                 Start Address for Group2
            GROUP ADDR3              0x5E                        {group_addr2[7:0], 4'h0}

                                                                 Start Address for Group3
                                                                 {group_addr3[7:0], 4'h0}

The group write function is controlled by register 0x3212.

table 2-5   group write registers    default                R/W  description
  address   register name            value
                                                            W    SRM Group Access
0x3212      SRM GROUP ACCESS         -                      R       Bit[7]: Group launch enable
                                                                    Bit[6]: Test mode access group
0x3213      SRM GROUP STATUS         -                              Bit[5]: Group launch
                                                                    Bit[4]: Group hold end
                                                                    Bit[3:0]: Group ID
                                                                                 00xx: Group ID
                                                                                 01xx: Reserved
                                                                                 1xxx: Reserved

                                                                 SRM Group Status
                                                                    Bit[7]: Store default
                                                                    Bit[6]: Restore
                                                                    Bit[5]: Group hold
                                                                    Bit[4]: Group launch
                                                                    Bit[3]: Group write
                                                                    Bit[2:0]: Group select

07.29.2011  PRODUCT SPECIFICATION                                proprietary to OmniVision Technologies

OV5640  color CMOS QSXGA (5 megapixel) image sensor with OmniBSITM technology

        The SCCB will enter group write mode after writing to register 0x3212 with a valid group ID. The subsequent registers
        will be held to the buffer specified by the group_id instead of writing to the registers. Make sure the number of registers
        does not exceed the capacity of the group. Setting group_hold_end to 1 will exit the group write mode. After that, setting
        both group_launch and group_launch_en to 1 will write the buffered values to the real registers. Multiple groups of
        registers can be prepared before writing to the real registers but be sure the correct group_id is specified when the group
        write is launched.

        The following is an example demonstrating the group write operation:

        78 3212 00  Enable group0
        78 3600 00  Write registers to be held in group0
        78 3601 01
        78 3212 10  End group0
        78 3212 01  Enable group1
        78 3602 02  Write registers to be held in group1
        78 3603 03
        78 3212 11  End group1

        ......................... Other direct register access

        78 3212 02  Enable group2
        78 3604 04  Write registers to be held in group2
        78 3605 05
        78 3212 12  End group2

        78 3212 A0 Launch group0

        ......................... Other direct register access

        78 3212 03  Enable group3
        78 3606 06  Write registers to be held in group3
        78 3607 07
        78 3212 13  End group3

        78 3212 A1  Launch group1
        78 3212 A2  Launch group2
        78 3212 A3  Launch group3

        proprietary to OmniVision Technologies                  PRODUCT SPECIFICATION  version 2.1

                                                                                                                                                                                                      2-9

2.7 power up sequence

    Based on the system power configuration (1.8V or 2.8V for I/O power, using external DVDD or internal DVDD, requiring
    access to the I2C during power up period or not), the power up sequence will differ. If 1.8V is used for I/O power, using
    the internal DVDD is preferred. If 2.8V is used for I/O power, due to a high voltage drop at the internal DVDD regulator,
    there is a potential heat issue. Hence, for a 2.8V power system, OmniVision recommends using an external DVDD
    source. Due to the higher power down current when using an external DVDD source, OmniVision strongly recommends
    cutting off all powers, including the external DVDD, when the sensor is not in use in the case of 2.8V I/O and external
    DVDD.

   2.7.1 power up with internal DVDD

    For powering up with the internal DVDD and I2C access during the power ON period, the following conditions must occur:
          1. when DOVDD and AVDD are turned ON, make sure DOVDD becomes stable before AVDD becomes stable
          2. PWDN is active high with an asynchronized design (does not need clock)
          3. PWDN pin tied to digital ground if it is not controlled.
          4. if PWDN pin is controlled as below, for PWDN to go low, power must first become stable
                 (AVDD to PWDN  5 ms)
          5. RESETB is active low with an asynchronized design
          6. master clock XVCLK should provide at least 1 ms before host accesses the sensor's registers
          7. host can access I2C bus (if shared) during entire period. 20ms after RESETB goes high, host can access the
                 sensor's registers to initialize sensor

07.29.2011  PRODUCT SPECIFICATION  proprietary to OmniVision Technologies

OV5640  color CMOS QSXGA (5 megapixel) image sensor with OmniBSITM technology

        figure 2-4 power up timing with internal DVDD                              power off

                                                                         power on          t5
                                                      t0                           t6

                   DOVDD

        AVDD  t2                                                                                >=0ms
        PWDN          t3                                                                       t1

        RESETB t4

         XVCLK
           SCCB

        note  t0  0ms, delay from DOVDD stable to AVDD stable, it is recommended to power up AVDD shortly
              after DOVDD has been powered up

              t1  0ms, delay from XVCLK off to AVDD off
              t2  5ms, delay from AVDD stable to sensor power up stable, PWDN can be pulled low after this point,
              XVCLK can be turned on after power on

              t3  1ms, delay from sensor power up stable to RESETB pull up                             5640_DS_2_4
              t4  20ms, delay from RESETB pull high to SCCB initialization
              t5  0ms, delay from AVDD off to DOVDD off
              t6  0ms, delay from RESETB pull low to AVDD off

        2.7.2 power up with external DVDD source

        For powering up with an external DVDD source and I2C access during the power ON period, the following conditions
        must occur:

              1. when DOVDD and AVDD are turned ON, make sure DOVDD becomes stable before AVDD becomes stable
              2. when AVDD and DVDD are turned ON, make sure AVDD becomes stable before DVDD becomes stable
              3. PWDN is active high with an asynchronized design (does not need clock), PWDN pin tied to digital ground if it

                     is not controlled
              4. if PWDN pin is controlled as below, for PWDN to go low, power must first become stable

                     (DVDD to PWDN  5 ms)
              5. all powers are cut off when the camera is not in use (power down mode is not recommended)
              6. RESETB is active low with an asynchronized design
              7. master clock XVCLK should provide at least 1 ms before host accesses the sensor's registers
              8. host can access I2C bus (if shared) during entire period. 20ms after RESETB goes high, host can access the

                     sensor's registers to initialize sensor

        proprietary to OmniVision Technologies  PRODUCT SPECIFICATION                                      version 2.1

                                                                                                                       2-11

figure 2-5 power up timing with external DVDD source                                                    cut off power
                                                                                             t6
                DOVDD first, then AVDD, followed by DVDD, and rising time is less than 5 ms
                                      t0                                                      t7

    DOVDD                                                                                              t5
                                            t1

       AVDD
                                                    t2

       DVDD t3
                        power on period

      PWDN

    RESETB t4

     XVCLK
       SCCB

note t0  0 ms: delay from DOVDD stable to AVDD stable, it is recommended to power up AVDD shortly after DOVDD
       has been powered up

t1  0 ms: delay from AVDD stable to DVDD stable                                              5640_DS_2_5
t2  5 ms: delay from DVDD stable to sensor power up stable
t3  1ms, delay from sensor power up stable to RESETB pull up
t4  20ms, delay from RESETB pull high to SCCB initialization
t5  0ms, delay from AVDD off to DOVDD off
t6  0ms, delay from RESETB pull low to DVDD off
t7  0ms, delay from XVCLK off to DVDD off

07.29.2011  PRODUCT SPECIFICATION                             proprietary to OmniVision Technologies

OV5640  color CMOS QSXGA (5 megapixel) image sensor with OmniBSITM technology

        2.8 reset

            The OV5640 sensor includes a RESETB pin that forces a complete hardware reset when it is pulled low (GND). The
            OV5640 clears all registers and resets them to their default values when a hardware reset occurs. A reset can also be
            initiated through the SCCB interface by setting register 0x3008[7] to high.

            Manually applying a hard reset upon power up is required even though on-chip reset is included. The hard reset is active
            low with an asynchronized design. The reset pulse width should be greater than or equal to 1 ms.

        2.9 hardware and software standby

            Two suspend modes are available for the OV5640:

            · hardware standby
            · SCCB software standby
            To initiate hardware standby mode, the PWDN pin must be tied to high (while in MIPI mode, set register 0x300E[4:3] to
            2'b11 before the PWDN pin is set to high). When this occurs, the OV5640 internal device clock is halted and all internal
            counters are reset and registers are maintained.

            Executing a software standby through the SCCB interface suspends internal circuit activity but does not halt the device
            clock. All register content is maintained in standby mode.

        proprietary to OmniVision Technologies  PRODUCT SPECIFICATION          version 2.1

                                                                                                                             3-1

3 block level description

3.1 pixel array structure

The OV5640 sensor has an image array of 2624 columns by 1964 rows (5,153,536 pixels). figure 3-1 shows a
cross-section of the image sensor array.

The color filters are arranged in a Bayer pattern. The primary color BG/GR array is arranged in line-alternating fashion.
Of the 5,153,536 pixels, 5,038,848 (2592x1944) are active pixels and can be output. The other pixels are used for black
level calibration and interpolation.

The sensor array design is based on a field integration readout system with line-by-line transfer and an electronic shutter
with a synchronous pixel readout scheme.

figure 3-1  sensor array region color filter layout

                                                        columns

                            0
                               1
                                  2
                                     3
                                       ...
                                            15
                                                  16
                                                     17
                                                        18
                                                            19
                                                              ...
                                                                  2607
                                                                         2608
                                                                            2609
                                                                               2610
                                                                                  2611
                                                                                     ...
                                                                                         2623

                  0                                                                             black
                  1                                                                              line
                  2                                                                            dummy
                  3                                                                              line
                  ...                                                                          active
                                                                                                 line
                  7                                                                            dummy
                                                                                                 line
            rows   8 B Gb B Gb B Gb         B Gb B Gb B Gb       B Gb B Gb B Gb
                   9 Gr R Gr R Gr R         Gr R Gr R Gr R       Gr R Gr R Gr R
                  10 B Gb B Gb B Gb         B Gb B Gb B Gb       B Gb B Gb B Gb
                  11 Gr R Gr R Gr R         Gr R Gr R Gr R       Gr R Gr R Gr R
                  12 B Gb B Gb B Gb         B Gb B Gb B Gb       B Gb B Gb B Gb
                  13 Gr R Gr R Gr R         Gr R Gr R Gr R       Gr R Gr R Gr R

                     14     B Gb B Gb B Gb  B Gb B Gb B Gb       B Gb B Gb B Gb
                     15     Gr R Gr R Gr R  Gr R Gr R Gr R       Gr R Gr R Gr R
                     16     B Gb B Gb B Gb  B Gb B Gb B Gb       B Gb B Gb B Gb
                     17     Gr R Gr R Gr R  Gr R Gr R Gr R       Gr R Gr R Gr R
                            B Gb B Gb B Gb  B Gb B Gb B Gb       B Gb B Gb B Gb
                       ...  Gr R Gr R Gr R  Gr R Gr R Gr R       Gr R Gr R Gr R

                  1957                      B Gb B Gb B Gb       B Gb B Gb B Gb
                                            Gr R Gr R Gr R       Gr R Gr R Gr R
                  1958      B Gb B Gb B Gb  B Gb B Gb B Gb       B Gb B Gb B Gb
                  1959      Gr R Gr R Gr R  Gr R Gr R Gr R       Gr R Gr R Gr R
                  1960      B Gb B Gb B Gb  B Gb B Gb B Gb       B Gb B Gb B Gb
                  1961      Gr R Gr R Gr R  Gr R Gr R Gr R       Gr R Gr R Gr R
                  1962      B Gb B Gb B Gb
                  1963      Gr R Gr R Gr R

                            dummy           active               dummy
                            column          column               column

                                                                                               5640_DS_3_1

07.29.2011        PRODUCT SPECIFICATION                          proprietary to OmniVision Technologies

OV5640  color CMOS QSXGA (5 megapixel) image sensor with OmniBSITM technology

        3.2 binning

        Binning mode is usually used for subsampling. During subsampling, information is periodically dropped when data is
        output. When the binning function is ON, voltage levels of adjacent pixels are averaged before being sent to the ADC. If
        the binning function is OFF, the pixels, which are not output, are merely skipped. The OV5640 supports 2x2, 1x2, and
        2x1 binning.

        figure 3-2 illustrates 2x2 binning, where the voltage levels of four (2x2) adjacent same-color pixels are averaged before
        entering the ADC.

        In OV5640, vertical binning will automatically turn on when in vertical-subsampled formats.

        figure 3-2   example of 2x2 binning

                                       2x2 blue pixels are 2x2 green pixels are
                                      binned to 1 blue pixel binned to 1 green pixel

                                      BGBG               BGBG

                                      GRGR BG GRGR BG

                                      BGBG GR BGBG GR

                                      GRGR               GRGR

                                      BGBG               BGBG

                                      GRGR BG GRGR BG

                                      BGBG GR BGBG GR

                                      GRGR               GRGR

                      2x2 green pixels are                2x2 red pixels are
                     binned to 1 green pixel             binned to 1 red pixel

                                                                                             5640_DS_3_2

        table 3-1    binning-related registers

        address      register name              default  R/W   description
                                                value
        0x3821       TIMING TC REG21                     RW       Bit[0]: Horizontal binning enable
                                                0x00

        proprietary to OmniVision Technologies           PRODUCT SPECIFICATION                            version 2.1

                                                                                                                                  3-3

3.3 VCM driver

   figure 3-3 VCM block diagram

                                                                                    Vvcm

                                                         voice coil motor
                                                         RVCM

                                               current
                                               sinking
                                               pad
                                               RP1

                                                                   Vds

                             resistor
                           Rs = 3.3 

                                               VCM GND                                    5640_DS_3_3
                                               PAD
                                               RP2

The maximum SINK current can be estimated as:

· ISINK = (Vvcm - Vds) / (Rs + Rvcm + Rp1 + Rp2)
· Vds is the transistor headroom
· Rp1 and Rp2 are the resistance in the current path
· RVCM is the resistance of the voice coil motor.

The OV5640 VCM driver is a single 10-bit DAC with 100 mA output current sink capability. It is designed for linear control
of the VCM. The DAC is controlled via the SCCB interface with clock rates up to 400 Hz. The OV5640 VCM driver
provides three types of output current control modes that allow users to adjust transient response of the sinking current.

3.3.1 output current control mode

The OV5640 VCM driver uses 4 bits (S3, S2, S1, and S0) to control the output current response.

1. S[3:0] = X000:          Directly jump mode: code directly jumps to target code. Output current transient
2. S[3:0] = 0001 to 0111:  response time (see table 3-2.)
3. S[3:0] = 1001 to 1111:
                           Single step mode: code increases/decreases by a single step. Single step time
                           durations are 50µs, 100µs, 200µs, 400µs, 800µs, 1600µs, and 3200µs, which are
                           controlled by S2, S1, and S0 (see table 3-4.)

                           Multi-code steps mode: Code increases/decreases in multi-code steps. If the
                           target code and the current code have a difference larger than 128, the 64-code
                           step is applied first. When the difference in between target and current codes is no
                           more than 128 but larger than 16, the 16-code step is used. When the difference
                           is less than 16, it will directly jump to the target code. Single step time options are
                           50µs, 100µs, 200µs, 400µs, 800µs, 1600µs, and 3200µs, which are controlled by
                           S2, S1, and S0, (see table 3-5.)

07.29.2011  PRODUCT SPECIFICATION                                                         proprietary to OmniVision Technologies

OV5640  color CMOS QSXGA (5 megapixel) image sensor with OmniBSITM technology

        table 3-2    VCM driver control                       description
           function                         register

                                                              Bit[3:0]:    Current transient response control

        current transient response  0x3602                                 x000:   mode 0
        control
                                                                           0001~0111: mode 1

                                                                           1001~1111: mode 2

        10-bit DAC code             0x3603[5:0],              0x3603[5:0]: D[9:4]
        clock divider               0x3602[7:4]               0x3602[7:4]: D[3:0]

                                    0x3605[3:0],              divide external clock to obtain a 20 KHz clock for
                                    0x3606[7:0]               VCM control block
                                                              VCM control clock = external clock / Rdiv[11:0]

        table 3-3    VCM control registers
          address
                     register name              default  R/W  description
           0x3603                               value
                                                         RW
                     VCM[15:8]                  0x01     RW   Bit[7]: PD
                                                         RW   Bit[5:0]: D[9:4]
                                                         RW
        0x3602       VCM[7:0]                   0x50          Bit[7:4]:    D[3:0]
                                                         RW   Bit[3]:      S3
        0x3605       SLEW[11:8]                 0x46          Bit[2:0]:    S[2:0]
        0x3604       SLEW[7:0]                  0x05
                                                              Bit[3:0]: Rdiv[11:8]

                                                              Bit[7:0]: Rdiv[7:0]

                                                              Bit[2:0]:    VCM output current control
                                                                           000: 0.71 * Id
        0x3606       VCM CURRENT                0x00                       001: 0.77 * Id
                                                                           010: 0.83 * Id
                                                                           011: 0.91 * Id
                                                                           100: 1.00 * Id
                                                                           101: 1.11 * Id
                                                                           110: 1.25 * Id
                                                                           111: 1.43 * Id

        proprietary to OmniVision Technologies           PRODUCT SPECIFICATION                version 2.1

                                                                                                             3-5

table 3-4   single step mode

                                           single step      full scale transition

mode        S3  S2            S1       S0  transition time  time (1023 steps)

            0   0             0        1   50µs             51.15ms

            0   0             1        0   100µs            102.3ms

            0   0             1        1   200µs            204.6ms
                                                            409.2ms
single step 0 1 0 0 400µs                                   818.4ms
mode

            0   1             0        1   800µs

            0   1             1        0   1600µs           1.637s

            0   1             1        1   3200µs           3.274s

table 3-5   multi-code step mode

                                           single step      full scale transition

mode        S3  S2            S1       S0  transition time  time (22 steps)a

            1   0             0        1   50µs             1.1ms

            1   0             1        0   100µs            2.2ms

            1   0             1        1   200µs            4.4ms
                                                            8.8ms
single step 1 1 0 0 400µs                                   17.6ms
mode

            1   1             0        1   800µs

            1   1             1        0   1600µs           35.2ms

            1   1             1        1   3200µs           70.4ms

a. a full scale transition includes fourteen 64-code steps, seven 16-code steps and one directly jump step.

07.29.2011      PRODUCT SPECIFICATION            proprietary to OmniVision Technologies

OV5640  color CMOS QSXGA (5 megapixel) image sensor with OmniBSITM technology

        figure 3-4 1/4 to 3/4 scale settling time (directly jump mode, VDD = 3.0V)output current (mA)

                    1.00E-01
                    9.50E-02
                    9.00E-02
                    8.50E-02
                    8.00E-02
                    7.50E-02
                    7.00E-02
                    6.50E-02
                    6.00E-02
                    5.50E-02
                    5.00E-02

                             1.25E-03
                                                    1.27E-03
                                                                           1.29E-03
                                                                                                  1.31E-03
                                                                                                                         1.33E-03
                                                                                                                                                1.35E-03
                                                                                                                                                                       1.37E-03

                                                1/4 to 3/4 scale settling time (VDD = 3.0V)  5640_DS_3_4

        IOUT (mA)figure 3-5 sink current vs. code (VDD = 3.0V, reg 0x30A5 = 0x05, VCM resistance = 23ohms)

                         100
                           90
                           80
                           70
                           60
                           50
                           40
                           30
                           20
                           10
                             0

                             0
                                     64
                                              128
                                                      192
                                                               256
                                                                        320
                                                                                384
                                                                                         448
                                                                                                  512
                                                                                                          576
                                                                                                                   640
                                                                                                                            704
                                                                                                                                    768
                                                                                                                                             832
                                                                                                                                                      896
                                                                                                                                                              960
                                                                                                                                                                       1024

                                                CODE                                         5640_DS_3_5

        proprietary to OmniVision Technologies  PRODUCT SPECIFICATION                        version 2.1

                                                                                                                           4-1

4 image sensor core digital functions

4.1 mirror and flip

The OV5640 provides Mirror and Flip readout modes, which respectively reverse the sensor data readout order
horizontally and vertically (see figure 4-1). In flip, the OV5640 does not need additional settings because the ISP block
will auto-detect whether the pixel is in the red line or blue line and make the necessary adjustments.

figure 4-1 mirror and flip samples              F

F                            FF
                           mirrored image       flipped image  mirrored and flipped
original image                                                          image

                                                                               5640_DS_4_1

table 4-1   mirror and flip registers
  address
            register name              default  R/W  description
   0x3820                              value
   0x3821                                       RW   Timing control
            TIMING TC REG20            0x40     RW      Bit[2]: ISP vflip
                                                        Bit[1]: Sensor vflip
            TIMING TC REG21            0x00
                                                     Timing Control
                                                        Bit[2]: ISP mirror
                                                        Bit[1]: Sensor mirror

07.29.2011           PRODUCT SPECIFICATION           proprietary to OmniVision Technologies

OV5640  color CMOS QSXGA (5 megapixel) image sensor with OmniBSITM technology

        4.2 image windowing

            The OV5640 uses registers 0x3800 ~ 0x3814 for image windowing. figure 4-2 illustrates how the registers define the
            windowing size. Physical pixel size is the total pixel array size we have in the sensor. The ISP input size is the total pixel
            data read from pixel array. Typically, the larger ISP input size is, the less maximum frame rate can be reached. The data
            output size is the image output size of OV5640. This size is windowed from ISP input size and is defined by x_offset and
            y_offset as figure 4-2 shows.

        figure 4-2  image windowing

                     (0, 0)

                            Y_ADDR_ST
                            {0x3802, 0x3803}

                                      Y_OFFSET
                                      {0x3812, 0x3813}
                    X_ADDR_ST
                       {0x3800, 0x3801}
                              X_OFFSET
                                  {0x3810, 0x3811}
                                                                                                                Y_OUTPUT_SIZE
                                                                                                                   {0x380A 0x380B}
                                                                                                                             Y_ADDR_END
                                                                                                                                {0x3806, 0x3807}

                                                        data output size

                                                X_OUTPUT_SIZE     ISP input size
                                                {0x3808, 0x3809}

                                                  X_ADDR_END              physical pixel size
                                                {0x3804, 0x3805}

                                                                  (X_ADDR_MAX, Y_ADDR_MAX)

                                                                                  5640_DS_4_2

        proprietary to OmniVision Technologies          PRODUCT SPECIFICATION                                                                     version 2.1

                                                                                                                                                                                                 4-3

figure 4-3 shows the windowing configuration when scaling function is enabled. The pre-scaling image size is the ISP
input size subtracted by two times of offsets for both horizontal and vertical.

figure 4-3 image windowing configuration

          (0, 0)
                 Y_ADDR_ST
                 {0x3802, 0x3803}
                           Y_OFFSET
                           {0x3812, 0x3813}
X_ADDR_ST
   {0x3800, 0x3801}
          X_OFFSET
              {0x3810, 0x3811}
                                                                                          X_OFFSET
                                                                                             {0x3810, 0x3811}
                                                                                                       Y_ADDR_END
                                                                                                          {0x3806, 0x3807}
                                                                                                                                                                                    Y_OUTPUT_SIZE
                                                                                                                                                                                       {0x380A, 0x380B}
                                                                            data output size
            Y_OFFSET          pre-scaling size                                (after scaling)
            {0x3812, 0x3813}               ISP input size
                                                            X_OUTPUT_SIZE
              X_ADDR_END               physical pixel size  {0x3808, 0x3809}
            {0x3804, 0x3805}
                                                                                                                          5640 DS 4 3
                              (X_ADDR_MAX, Y_ADDR_MAX)

table 4-2   image windowing registers (sheet 1 of 2)

  address   register name     default  R/W  description
                              value
  0x3800    TIMING HS                  RW      Bit[3:0]: X address start high byte[11:8] high byte
  0x3801    TIMING HS         0x00     RW      Bit[7:0]: X address start low byte[7:0] low byte
  0x3802    TIMING VS         0x00     RW      Bit[2:0]: Y address start high byte[10:8] high byte
  0x3803    TIMING VS         0x00     RW      Bit[7:0]: Y address start low byte[7:0] low byte
  0x3804    TIMING HW         0x00     RW      Bit[3:0]: X address end high byte[11:8] high byte
  0x3805    TIMING HW         0x0A     RW      Bit[7:0]: X address end low byte[7:0] low byte
  0x3806    TIMING VH         0x3F     RW      Bit[2:0]: Y address end high byte[10:8] high byte
  0x3807    TIMING VH         0x07     RW      Bit[7:0]: Y address end low byte[7:0] low byte
  0x3808    TIMING DVPHO      0x9F     RW      Bit[3:0]: DVP output horizontal width[11:8] high byte
  0x3809    TIMING DVPHO      0x0A     RW      Bit[7:0]: DVP output horizontal width[7:0] low byte
  0x380A    TIMING DVPVO      0x20     RW      Bit[2:0]: DVP output vertical height[10:8] high byte
  0x380B    TIMING DVPVO      0x07     RW      Bit[7:0]: DVP output vertical height[7:0] low byte
                              0x98

07.29.2011  PRODUCT SPECIFICATION                           proprietary to OmniVision Technologies

OV5640  color CMOS QSXGA (5 megapixel) image sensor with OmniBSITM technology

        table 4-2  image windowing registers (sheet 2 of 2)

          address  register name                default  R/W  description
                                                value
          0x380C   TIMING HTS                            RW      Bit[3:0]: Total horizontal size[11:8] high byte
          0x380D   TIMING HTS                   0x0B     RW      Bit[7:0]: Total horizontal size[7:0] low byte
          0x380E   TIMING VTS                   0x1C     RW      Bit[7:0]: Total vertical size[15:8] high byte
          0x380F   TIMING VTS                   0x07     RW      Bit[7:0]: Total vertical size[7:0] low byte
          0x3810   TIMING HOFFSET               0xB0     RW      Bit[3:0]: ISP horizontal offset[11:8] high byte
          0x3811   TIMING_HOFFSET               0x00     RW      Bit[7:0]: ISP horizontal offset[7:0] low byte
          0x3812   TIMING VOFFSET               0x10     RW      Bit[2:0]: ISP vertical offset[10:8] high byte
          0x3813   TIMING VOFFSET               0x00     RW      Bit[7:0]: ISP vertical offset[7:0] low byte
                                                0x04

        4.3 test pattern

            For testing purposes, the OV5640 offers one type of test pattern, color bar.

           figure 4-4 test pattern

                                                         color bar

        table 4-3  test pattern selection control
          address
                                                default

                   register name                value    R/W  description

        0x503D PRE ISP TEST 0x00 RW                           Bit[7]:                     Color bar enable
                          SETTING 1                           Bit[3:2]:                   0: Test disable
                                                                                          1: Color bar enable
                                                                                          Color bar style
                                                                                          00: Standard eight color bar
                                                                                          01: Gradual change at vertical mode 1
                                                                                          10: Gradual change at horizontal
                                                                                          11: Gradual change at vertical mode 2

        proprietary to OmniVision Technologies                PRODUCT SPECIFICATION       version 2.1

                                                                                                                                    4-5

4.4 50/60Hz detection

   4.4.1 overview

    When the integration time is not an integer multiple of the period of light intensity, the image will flicker. The function of
    the detector is to detect whether the sensor is under a 50 Hz or 60 Hz light source so that the basic step of integration
    time can be determined. Contact your local OmniVision FAE for auto detection settings.

4.5 AEC/AGC algorithms

   4.5.1 overview

    The Auto Exposure Control (AEC) and Auto Gain Control (AGC) allows the image sensor to adjust the image brightness
    to a desired range by setting the proper exposure time and gain applied to the image. Besides automatic control,
    exposure time and gain can be set manually from external control. The related registers are listed in table 4-4.

table 4-4   AEC/AGC algorithm functions
  address
            register name     default    R/W  description
  0x3500                      value
                                         RW   Exposure Output
            AEC PK EXPOSURE   0x00       RW      Bit[3:0]: Exposure [19:16]

0x3501      AEC PK EXPOSURE   0x02       RW   Exposure Output
                                                 Bit[7:0]: Exposure [15:8]
0x3502      AEC PK EXPOSURE   0x00       RW
                                              Exposure Output
0x3503      AEC PK MANUAL     0x00       RW      Bit[7:0]: Exposure [7:0]
                                         RW                   Lower four bits are a fraction of a
0x350A      AEC PK REAL GAIN  0x00       RW                   line; they should be 0 since
0x350B      AEC PK REAL GAIN  0x10       RW                   OV5640 does not support
0x350C      AEC PK VTS        0x00                            fraction line exposure
0x350D      AEC PK VTS        0x00
                                              AEC Manual Mode Control
                                                 Bit[1]: AGC manual
                                                              0: Auto enable
                                                              1: Manual enable
                                                 Bit[0]: AEC manual
                                                              0: Auto enable
                                                              1: Manual enable

                                              Real Gain
                                                 Bit[1:0]: Real gain[9:8]

                                              Real Gain
                                                 Bit[7:0]: Real gain[7:0]

                                              AEC VTS Output
                                                 Bit[7:0]: VTS[15:8] high bits

                                              AEC VTS Output
                                                 Bit[7:0]: VTS[7:0] low bits

07.29.2011  PRODUCT SPECIFICATION             proprietary to OmniVision Technologies

OV5640  color CMOS QSXGA (5 megapixel) image sensor with OmniBSITM technology

        4.5.2 average-based algorithm

        The average-based AEC controls image luminance using registers (0x3A0F), (0x3A10), (0x3A1B), and (0x3A1E). In
        average-based mode, the value of register (0x3A0F) indicates the high threshold value, and the value of register
        (0x3A10) indicates the low threshold value. The value of register (0x3A1B) indicates the high threshold value for image
        change from stable state to unstable state and the value of register (0x3A1E) indicates the low threshold value for image
        change from stable state to unstable state. When the target image luminance average value AVG READOUT (0x56A1)
        is within the range specified by registers (0x3A1B) and (0x3A1E), the AEC keeps the image exposure and gain. When
        register AVG READOUT (0x56A1) is greater than the value in register (0x3A1B), the AEC will decrease the image
        exposure and gain until it falls into the range of {0x3A10, 0x3A0F}. When register AVG READOUT (0x56A1) is less than
        the value in register (0x3A1E), the AEC will increase the image exposure and gain until it falls into the range of {0x3A10,
        0x3A0F}. Accordingly, the value in register (0x3A0F) should be greater than the value in register (0x3A10). The gap
        between the values of registers (0x3A1B) and (0x3A1E) controls the image stability.

        The AEC function supports both manual and auto speed selections in order to bring the image exposure into the range
        set by the values in registers (0x3A0F) and (0x3A10). For manual mode, the speed supports both normal and fast speed
        selection. AEC set to normal mode will allow for the slowest step increment or decrement in the image exposure to
        maintain the specified range. AEC set to fast mode will provide for an approximate ten-step increment or decrement in
        the image exposure to maintain the specified range. For auto mode, the speed step will automatically be adjusted
        according to the difference between the target and present values. The auto ratio of steps can be set by register bits AVG
        READOUT (0x56A1); thus, the AEC speed can be adjusted automatically by the image average value or controlled
        manually.

        Register (0x3A11) and register (0x3A1F) controls the fast AEC range in manual speed selection made. If the target image
        AVG READOUT (0x56A1) is greater than (0x3A11), AEC will decrease by half. If register AVG READOUT (0x56A1) is
        less than (0x3A1F), AEC will double.

        As shown in desired convergence, the AEC/AGC convergence uses two regions, the inner stable operating region and
        the outer control zone, which defines the convergence step size of fast and slow conditions.

        figure 4-5 desired convergence

                                                                         desired convergence

        control zone                            stable operating region

                                                                                              5640_DS_4_5

        proprietary to OmniVision Technologies  PRODUCT SPECIFICATION                         version 2.1

                                                                                                                            4-7

As for auto mode, the AEC will automatically calculate the steps needed based on the difference between target and
current values. So, the outer control zone is meaningless for this mode.

table 4-5   AEC functions

address     register name  default  R/W  description
                           value
0x3A0F      AEC CTRL0F              RW   Stable Range High Limit (enter)
                           0x78     RW      Bit[7:0]: WPT
0x3A10      AEC CTRL10     0x68     RW
                           0xD0     RW   Stable Range Low Limit (enter)
0x3A11      AEC CTRL11     0x78     RW      Bit[7:0]: BPT
                           0x68     RW
0x3A1B AEC CTRL1B          0x40          Step Manual Mode, Fast Zone High Limit
                                            Bit[7:0]: vpt_high
0x3A1E AEC CTRL1E
                                         Stable Range High Limit (go out)
0x3A1F      AEC CTRL1F                      Bit[7:0]: WPT2

                                         Stable Range Low Limit (go out)
                                            Bit[7:0]: BPT2

                                         Step Manual Mode, Fast Zone Low Limit
                                            Bit[7:0]: vpt_low

For the average-based AEC/AGC algorithm, the measured window is horizontally and vertically adjustable and divided
by sixteen (4x4) zones (see figure 4-6). Each zone (or block) is 1/16th of the image and has a 4-bit weight in calculating
the average luminance (YAVG). The 4-bit weight could be n/16 where n is from 0 to 15. The final YAVG is the weighted
average of the sixteen zones.

     4.5.2.1 average luminance (YAVG)
     Auto exposure time calculation is based on a frame brightness average value. By properly setting x_start, x_end,
     y_start, and y_end as shown in figure 4-6, a 4x4 grid average window is defined. It will automatically divide each
     zone into 4x4 zones. The average value is the weighted average of the 16 sections. table 4-6 lists the corresponding
     registers.

07.29.2011  PRODUCT SPECIFICATION        proprietary to OmniVision Technologies

OV5640  color CMOS QSXGA (5 megapixel) image sensor with OmniBSITM technology

        figure 4-6  average-based window definition

                                                         sensor array size X

                    start                                HW                                        X
                                                                                             Y

                                          VH    1234          average
                                                5678          window
                    sensor array                9 10 11 12    size
                            size Y              13 14 15 16

                                                                                             end

                                                                                5640_DS_4_6

        table 4-6   timing control functions (sheet 1 of 2)

          address   register name               default  R/W  description
                                                value
          0x3810    TIMING HOFFSET                       RW   Bit[3:0]: ISP horizontal offset[11:8] high byte
          0x3811    TIMING_HOFFSET              0x00     RW
          0x3812    TIMING VOFFSET              0x04     RW   Bit[7:0]: ISP Horizontal offset[7:0] low byte
          0x3813    TIMING VOFFSET              0x11     RW
          0x3808    TIMING DVPHO                0x11     RW   Bit[3:0]: ISP vertical offset[11:8] high byte
          0x3809    TIMING DVPHO                0x07     RW
          0x380A    TIMING DVPVO                         RW   Bit[7:0]: ISP vertical offset[7:0] low byte
          0x380B    TIMING DVPVO                0x98     RW
          0x501D    ISP MISC                             RW   Bit[3:0]: DVP output horizontal width[11:8] high
                                                0x0B                      byte
          0x5680    X START                     0x1C     RW
                                                0x00          Bit[7:0]: DVP output horizontal width[7:0] low
          0x5681    X START                              RW               byte
                                                0x00
                                                              Bit[3:0]: DVP output vertical height[11:8] high
                                                0x00                      byte

                                                              Bit[7:0]: DVP output vertical height[7:0] low byte

                                                              Bit[4]: Average size manual enable

                                                              Bit[3:0]:       x start[11:8]
                                                                              Horizontal start position for average
                                                                              window high byte, valid when
                                                                              0x501D[4]=1

                                                              Bit[7:0]:       x start[7:0]
                                                                              Horizontal start position for average
                                                                              window low byte, valid when
                                                                              0x501D[4]=1

        proprietary to OmniVision Technologies           PRODUCT SPECIFICATION                        version 2.1

                                                                                                        4-9

table 4-6   timing control functions (sheet 2 of 2)
  address
            register name  default  R/W  description
  0x5682                   value
            Y START                 RW               Bit[2:0]:  y start[10:8]
  0x5683                   0x00                                 Vertical start position for average
            Y START                 RW                          window low byte, valid when
  0x5684                   0x00                                 0x501D[4]=1
            X WINDOW                RW
  0x5685                   0x10                      Bit[7:0]:  y start[7:0]
            X WINDOW                RW                          Vertical start position for average
  0x5686                   0xA0                                 window low byte, valid when
            Y WINDOW                RW                          0x501D[4]=1
  0x5687                   0x0C
  0x5688    Y WINDOW                RW               Bit[3:0]:  Window X [11:8]
  0x5689    WEIGHT00       0x78     RW                          Horizontal end position for average
  0x568A    WEIGHT01       0x11     RW                          window high byte, valid when
  0x568B    WEIGHT02       0x11     RW                          0x501D[4]=1
  0x568C    WEIGHT03       0x11     RW
  0x568D    WEIGHT04       0x11     RW               Bit[7:0]:  Window X [7:0]
  0x568E    WEIGHT05       0x11     RW                          Horizontal end position for average
  0x568F    WEIGHT06       0x11     RW                          window low byte, valid when
            WEIGHT07       0x11     RW                          0x501D[4]=1.
                           0x11
                                                     Bit[2:0]:  Window Y [10:8]
                                                                Vertical end position for average
                                                                window high byte, valid when
                                                                0x501D[4]=1

                                                     Bit[7:0]:  Window Y [7:0]
                                                                Vertical end position for average
                                                                window low byte, valid when
                                                                0x501D[4]=1

                                                     Bit[7:4]: Window 01 weight
                                                     Bit[3:0]: Window 00 weight

                                                     Bit[7:4]: Window 03 weight
                                                     Bit[3:0]: Window 02 weight

                                                     Bit[7:4]: Window 11 weight
                                                     Bit[3:0]: Window 10 weight

                                                     Bit[7:4]: Window 13 weight
                                                     Bit[3:0]: Window 12 weight

                                                     Bit[7:4]: Window 21 weight
                                                     Bit[3:0]: Window 20 weight

                                                     Bit[7:4]: Window 23 weight
                                                     Bit[3:0]: Window 22 weight

                                                     Bit[7:4]: Window 31 weight
                                                     Bit[3:0]: Window 30 weight

                                                     Bit[7:4]: Window 33 weight
                                                     Bit[3:0]: Window 32 weight

07.29.2011  PRODUCT SPECIFICATION                               proprietary to OmniVision Technologies

OV5640  color CMOS QSXGA (5 megapixel) image sensor with OmniBSITM technology

        4.6 AEC/AGC steps

            The AEC and AGC work together to obtain adequate exposure/gain based on the current environmental illumination. In
            order to achieve the best SNR, extending the exposure time is always preferred rather than raising the gain when the
            current illumination is getting brighter. Vice versa, under dark conditions, the action to decrease the gain is always taken
            prior to shortening the exposure time.

           4.6.1 auto exposure control (AEC)

            The function of the AEC is to calculate the integration time of the next frame and send the information to the timing control
            block. Based on the statistics of previous frames, the AEC is able to determine whether the integration time should
            increase, decrease, fast increase, fast decrease, or remain the same.

            To avoid image flickering under a periodic light source, the integration time can be adjusted in steps of integer multiples
            of the period of the light source. This new AEC step system is called the banding filter, suggesting that the exposure time
            is not continuous but falls in some steps.

                  4.6.1.1 banding mode ON with AEC
                  In Banding ON mode, the exposure time will fall in steps of integer multiples of the period of light intensity. This
                  design is to reject image flickering when the light source is not steady but periodical.

                  For a given light flickering frequency, the band step can be expressed in units of row period.

                  Band Step = 'period of light intensity' × 'frame rate' × 'rows per frame'.

                  The band steps for 50Hz and 60Hz light sources can be set in registers {0x3A08[1:0], 0x3A09[7:0]} and
                  {0x3A0A[1:0], 0x3A0B[7:0]}, respectively.

                  When auto-banding is ON, if the next integration time is less than the minimum band step, banding will automatically
                  turn OFF. It will turn ON again when the next integration time becomes larger than the minimum band. If auto banding
                  is disabled, the minimum integration time is one band step. Auto banding can be set in register bit 0x3A00[5].

                  4.6.1.2 banding mode OFF with AEC
                  When banding mode is OFF, integration time increases/decreases as normal. It is not necessarily multiples of band
                  steps.

                  4.6.1.3 night mode
                  The OV5640 supports long integration time such as 1 frame, 2 frames, 3 frames, 4 frames, 5 frames, 6 frames,
                  7 frames, and 8 frames in dark conditions.This is achieved by slowing down the original frame rate and waiting for
                  exposure. Night mode ceiling can be set in register bits {0x3A02[7:0], 0x3A03[7:0], 0x3A14[7:0], 0x3A15[7:0]}. Night
                  mode can be disabled by setting register bit 0x3A00[2] to 0. Also, when in night mode, the increase and decrease
                  step can be based on band or frames, depending on register 0x3A05[6]. The minimum increase/decrease step can
                  be one band. The step can be based both on bands and frames.

           4.6.2 manual exposure control

            To manually change exposure value, you must first set both 0x3503[0], where 0x3503[0] enables manual exposure
            control. In auto exposure mode, the extra exposure values (larger than 1 frame) in registers 0x350C/0x350D
            automatically change. In manual exposure mode, these registers will not automatically change. The manually set

        proprietary to OmniVision Technologies  PRODUCT SPECIFICATION          version 2.1

                                                                                                                             4-11

exposure in registers 0x3500~0x3502 must be less than the maximum exposure value in {0x380E, 0x380F} +
{0x350C,0x350D}. The exposure value in registers 0x3500~0x3502 is in units of line*16 - the low 4 bits (0x3502[3:0]) is
the fraction of line, the maximum value in {0x380E + 0x380F} + {0x350C, 0x350D} is in unit of line. If the manually set
exposure value is less than one pre-defined frame period (e.g., 1/15 second in 15fps), there is no need to change
0x380E/0x380F. If the exposure value needs to be set beyond the pre-defined frame period; in other words, if the frame
period needs to be extended to extend exposure time, then the maximum frame value in 0x380E/0x380F needs to be
set first, then the exposure can be set in registers 0x3500~0x3502 accordingly.

4.6.3 auto gain control (AGC)

Unlike prolonging integration time, increasing gain will amplify both signal and noise. Thus, AGC usually starts after AEC
is full. However, in cases where adjacent AEC step changes are too large (>1/16), AGC steps should be inserted in
between; otherwise, the integration time will keep switching between two adjacent steps and the image flickers.

      4.6.3.1 integration time between 1~16 rows
      When integration time is less than 16 rows, the changes between adjacent AEC steps are larger than 1/16, which
      may possibly make the image oscillate between two AEC levels; thus, some AGC steps are added in between.

      4.6.3.2 gain insertion between AEC banding steps
      When banding mode is ON, the integration time changes in step of the period of light intensity. For the first 16 band
      steps, since the exposure time change between adjacent steps is larger than 1/16, AGC steps are inserted to ensure
      image stability.

      4.6.3.3 gain insertion between night mode steps
      Between night mode steps (e.g., integration time = 1 frame and 2 frames), AGC steps are inserted to ensure no
      adjacent step change is larger than 1/16.

      4.6.3.4 when AEC reaches maximum
      When AEC reaches its maximum while the image is still too dark, the gain starts to increase until the new frame
      average falls into the stable range or AGC reaches its maximum. The AGC ceiling can be set in {0x3A18[9:8],
      0x3A19[7:0]}.

4.6.4 manual gain control

To manually change gain, first set register bit 0x3503[1] to enable manual control, then change the values in
0x350A/0x350B for the manual gain. The OV5640 has a maximum of 64x gain.

07.29.2011  PRODUCT SPECIFICATION  proprietary to OmniVision Technologies

OV5640  color CMOS QSXGA (5 megapixel) image sensor with OmniBSITM technology

        4.7 black level calibration (BLC)

            The pixel array contains several optically shielded (black) lines. These lines are used as reference for black level
            calibration. There are three main functions of the BLC:

            · Combining two ADC data paths into one data path
            · Adjusting all normal pixel values based on the values of the black levels
            · Applying multiplication to all pixel values based on digital gain
            Black level adjustments can be made with registers 0x4000 through 0x4013.

        table 4-7  BLC control functions
          address
                   register name                default  R/W  description
          0x4000                                value
                                                         RW
                   BLC CTRL00                   0x89     RW   BLC Control 00
                                                                 Bit[0]: BLC enable
                                                         RW
                                                              Bit[7]:      Format change enable
                                                         RW                BLC update when format
        0x4002     BLC CTRL02                   0x45     RW                changes

        0x4003     BLC CTRL03                   0x08          Bit[7]:      BLC redo enable
                                                                           Write 1 into it will trigger a BLC
                                                              Bit[6]:      redo N frames begin, N is
                                                              Bit[5:0]:    0x4003[5:0]
                                                                           BLC freeze
                                                                           Manual frame number

                                                              Bit[1]:      BLC always update
                                                                           0: Normal freeze
        0x4005     BLC CTRL05                   0x18                       1: BLC always update
                                                0x10
        0x4009     BLACK LEVEL                                Bit[7:0]: BLC black level target at 10-bit
                                                                          range

        proprietary to OmniVision Technologies           PRODUCT SPECIFICATION       version 2.1

                                                                                                                            4-13

4.8 light frequency selection

    The OV5640 can detect the light flickering frequency. When this function is enabled, the sensor can detect the light
    frequency and select the corresponding banding filter value. To remove banding, the banding filter should be turned on
    and the banding filter value should be set to the appropriate value.

table 4-8   light frequency registers
  address
            register name  default     R/W  description
  0x3C01                   value
  0x3C00                               RW
  0x3C0C                               RW   Bit[7]:      Band manual enable
                                       R                 0: Auto
            5060HZ_CTRL1   0x00                          1: Manual

                                            Bit[2]:      Band value manual setting
                                                         0: 60 Hz light
            5060HZ_CTRL2   0x00                          1: 50 Hz light

                                            Bit[0]:      Band50/60
                                                         0: 60 Hz light
            5060HZ_CTRLC   -                             1: 50 Hz light

4.9 digital gain

    The OV5640 supports 1/2/4 digital gain. Normally, the gain is controlled automatically by the automatic gain control
    (AGC) block.

07.29.2011  PRODUCT SPECIFICATION           proprietary to OmniVision Technologies

OV5640  color CMOS QSXGA (5 megapixel) image sensor with OmniBSITM technology

        4.10 strobe flash and frame exposure

           4.10.1 strobe flash control

            The strobe signal is programmable. It supports both LED and Xenon modes. The polarity of the pulse can be changed.
            The strobe signal is enabled (turned high/low depending on the pulse's polarity) by requesting the signal via the SCCB
            interface. Flash modules are triggered by the rising edge by default or by the falling edge if the signal polarity is changed.
            It supports the following flashlight modes (see table 4-9).

        table 4-9   flashlight modes                       AEC / AGC              AWB
           mode                     output
                                                           no                     no
            xenon                     one-pulse            no                     no
            LED 1                     pulse                no                     yes
            LED 2                     pulse                yes                    yes
            LED 3                     continuous

        4.10.1.1 xenon flash control
        After a strobe request is submitted, the strobe pulse will be activated at the beginning of the third frame (see
        figure 4-7). The third frame will be correctly exposed. The pulse width can be changed in Xenon mode between 1H
        and 4H, depending on register 0x3B00[3:2], where H is one row period.

        figure 4-7  xenon flash mode

                      vertical
                     blanking

                    exposure
                          time

                    data
                     out

                     strobe
                    request

                    strobe           request here          zoomed
                     pulse
                                                   strobe
                          correctly                 pulse
                          exposed
                          frame                                       1H          5640_DS_4_7

        proprietary to OmniVision Technologies             PRODUCT SPECIFICATION               version 2.1

                                                                                                                             4-15

4.10.1.2 LED 1 & 2 mode
Two frames after the strobe request is submitted, the third frame is correctly exposed. The strobe pulse will be
activated only one time if the strobe end request is set correctly (see figure 4-8). If end request is not sent, the strobe
signal is activated intermittently until the strobe end request is set (see figure 4-9). The number of skipped frames
is programmable using registers {0x3A1C, 0x3A1D}.

figure 4-8 LED 1 & 2 mode - one pulse output

                                            frame in  is skipped

             vertical
            blanking

            exposure
                  time

            data
             out

             strobe           start end               the number of skipped frames
            request           request here            is programmable

             strobe                                                                 5640_DS_4_8
               pulse

                   correctly
                   exposed
                   frame

figure 4-9 LED 1 & 2 mode - multiple pulse output

                                            frame in  is skipped

             vertical
            blanking

            exposure
                  time

            data
             out

             strobe           start
            request           request here

             strobe                                   the number of skipped frames  5640_DS_4_9
               pulse                                  is programmable

                   correctly
                   exposed
                   frame

07.29.2011              PRODUCT SPECIFICATION                     proprietary to OmniVision Technologies

OV5640  color CMOS QSXGA (5 megapixel) image sensor with OmniBSITM technology

             4.10.1.3 LED 3 mode
             In LED 3 mode, the strobe signal stays active until the strobe end request is sent (see figure 4-10).

        figure 4-10 LED 3 mode

                                    vertical
                                   blanking

        exposure
              time

        data
         out

         strobe                 start                                   end
        request                 request here                 request here

         strobe                                                                5640_DS_4_10
          signal

             correctly
             exposed
             frame

        4.10.2 frame exposure (FREX) mode

        In FREX mode, whole frame pixels start integration at the same time, rather than integrating row by row. After the
        user-defined exposure time (registers {0x3B04, 0x3B05}), the shutter closes, preventing further integration and the
        image begins to read out. After the readout finishes, the shutter opens again and the sensor resumes normal mode,
        waiting for the next FREX request.

        The OV5640 supports two modes of FREX (see figure 4-11):

        · mode 1 - frame exposure and shutter control requests come from the external system via the FREX pin. The sensor
              will send a strobe output signal to control the flash light.

        · mode 2 - frame exposure request comes from the external system via the I2C register 0x3B08[0]. The sensor will
              output two signals, shutter control signal through the FREX pin and strobe signal through the STROBE pin.

        figure 4-11 FREX modes

                                                     mode 1  FREX
                                                     sensor  STROBE

                                                     mode 2

                                                             FREX

                                                I2C  sensor

                                                             STROBE

                                                             5640_DS_4_11

        proprietary to OmniVision Technologies       PRODUCT SPECIFICATION                                          version 2.1

                                                                                                                            4-17

In mode 1, the FREX pin is configured as an input while it is configured as an output in mode 2. In both mode 1 and mode
2, the strobe output is irrelevant with the rolling strobe function. When in rolling shutter mode, the strobe function and
this FREX/shutter control function do not work at the same time.

4.10.3 FREX strobe flash control

See table 4-10 for FREX strobe control functions.

table 4-10 FREX strobe control functions (sheet 1 of 2)

address register name              default  R/W  description
                                   value
                                            RW
0x3B00      STROBE CTRL            0x00          Strobe Control
                                            RW      Bit[7]: Strobe request ON/OFF
                                            RW                   0: OFF/BLC
                                            RW                   1: ON
                                            RW      Bit[6]: Strobe pulse reverse
                                            RW      Bit[3:2]: width_in_xenon
                                            RW      Bit[1:0]: Strobe mode
                                            RW                   00: Xenon
                                            RW                   01: LED 1
                                            RW                   10: LED 2
                                                                 11: LED 3

0x3B01      FREX EXPOSURE 02       0x00          Bit[7:0]: FREX exposure time[23:16]
0x3B02      FREX SHUTTER DELAY 01  0x08
0x3B03      FREX SHUTTER DELAY 00  0x00          Bit[4:0]: Shutter delay time[12:8]
0x3B04      FREX EXPOSURE 01       0x04
0x3B05      FREX EXPOSURE 00       0x00          Bit[7:0]: Shutter delay time[7:0]
                                                             Unit: 64x sclk cycle
0x3B06
                                                 Bit[7:0]: FREX exposure time [15:8]

                                                 Bit[7:0]: FREX exposure time [7:0]
                                                             Unit: Tline

            FREX CTRL 07           0x04          Bit[7:4]: FREX frame delay
                                                 Bit[3:0]: Strobe width[3:0]

                                                 Bit[1:0]:    FREX mode selection
                                                              00: FREX strobe mode0
0x3B07      FREX MODE              0x08                       01: FREX strobe mode1
                                                              1x: Rolling strobe
                                   0x00
0x3B08      FREX REQUEST           0x02          FREX Request
0x3B09      FREX HREF DELAY
                                                 FREX HREF Delay

07.29.2011  PRODUCT SPECIFICATION                        proprietary to OmniVision Technologies

OV5640  color CMOS QSXGA (5 megapixel) image sensor with OmniBSITM technology

        table 4-10 FREX strobe control functions (sheet 2 of 2)

        address register name                   default  R/W  description
                                                value
                                                         RW   Bit[2:0]:    FREX precharge length
                                                0x04                       000: 1/16 Tline
        0x3B0A FREX RST LENGTH                           RW                001: 1/8 Tline
                                                0x00     RW                010: 1/4 Tline
                                                0x3D                       011: 1/2 Tline
                                                                           100: 1 Tline
                                                                           101: 2 Tline
                                                                           110: 4 Tline
                                                                           111: 8 Tline

        0x3B0B  STROBE WIDTH                                  Bit[7:0]: Strobe width[19:12]
        0x3B0C  STROBE WIDTH
                                                              Bit[7:0]: Strobe width[11:4]

        4.11 one time programmable (OTP) memory

            The OV5640 supports a maximum of 256 bits of one-time programmable (OTP) memory to store chip identification and
            manufacturing information.

        table 4-11 OTP control functions (sheet 1 of 2)

        address register name                   default       description
                                                value R/W

        0x3D20  OTP PROGRAM CTRLa               0x00     RW   Bit[7]:      OTP program busy
                                                              Bit[1]:      OTP program speed
                                                                           0: Fast
                                                              Bit[0]:      1: Slow
                                                                           OTP program enable

        0x3D21  OTP READ CTRLa                  0x00     RW   Bit[7]:      OTP read busy
                                                              Bit[1]:      OTP read speed
                                                                           0: Fast
                                                              Bit[0]:      1: Slow
                                                                           OTP read enable

        0x3D00  OTP DATA00b                     0x00     RW   OTP Dump/Load Data00
        0x3D01  OTP DATA01b
        0x3D02  OTP DATA02b                     0x00     RW   OTP Dump/Load Data01
        0x3D03  OTP DATA03b
        0x3D04  OTP DATA04b                     0x00     RW   OTP Dump/Load Data02
        0x3D05  OTP DATA05
        0x3D06  OTP DATA06                      0x00     RW   OTP Dump/Load Data03

                                                0x00     RW   OTP Dump/Load Data04

                                                0x00     RW   OTP Dump/Load Data05

                                                0x00     RW   OTP Dump/Load Data06

        proprietary to OmniVision Technologies           PRODUCT SPECIFICATION                 version 2.1

                                                                                                                 4-19

table 4-11 OTP control functions (sheet 2 of 2)

address register name   default
                        value R/W description

0x3D07      OTP DATA07  0x00       RW            OTP Dump/Load Data07

0x3D08      OTP DATA08  0x00       RW            OTP Dump/Load Data08

0x3D09      OTP DATA09  0x00       RW            OTP Dump/Load Data09

0x3D0A OTP DATA0A       0x00       RW            OTP Dump/Load Data0a

0x3D0B OTP DATA0B       0x00       RW            OTP Dump/Load Data0b

0x3D0C OTP DATA0C       0x00       RW            OTP Dump/Load Data0c

0x3D0D OTP DATA0D       0x00       RW            OTP Dump/Load Data0d

0x3D0E OTP DATA0E       0x00       RW            OTP Dump/Load Data0e

0x3D0F OTP DATA0F       0x00       RW            OTP Dump/Load Data0f

0x3D10      OTP DATA10  0x00       RW            OTP Dump/Load Data10

0x3D11      OTP DATA11  0x00       RW            OTP Dump/Load Data11

0x3D12      OTP DATA12  0x00       RW            OTP Dump/Load Data12

0x3D13      OTP DATA13  0x00       RW            OTP Dump/Load Data13

0x3D14      OTP DATA14  0x00       RW            OTP Dump/Load Data14

0x3D15      OTP DATA15  0x00       RW            OTP Dump/Load Data15

0x3D16      OTP DATA16  0x00       RW            OTP Dump/Load Data16

0x3D17      OTP DATA17  0x00       RW            OTP Dump/Load Data17

0x3D18      OTP DATA18  0x00       RW            OTP Dump/Load Data18

0x3D19      OTP DATA19  0x00       RW            OTP Dump/Load Data19

0x3D1A OTP DATA1A       0x00       RW            OTP Dump/Load Data1a

0x3D1B OTP DATA1B       0x00       RW            OTP Dump/Load Data1b

0x3D1C OTP DATA1C       0x00       RW            OTP Dump/Load Data1c

0x3D1F OTP DATA1D       0x00       RW            OTP Dump/Load Data1d

0x3D1E OTP DATA1E       0x00       RW            OTP Dump/Load Data1e

0x3D1F OTP DATA1F       0x00       RW            OTP Dump/Load Data1f

a. AVDD must be 2.1V ± 5% when writing/programming OTP, otherwise there will be reliability issues. There is no
      such limitation when reading OTP under normal operating conditions.

b. 0x3D00~0x3D04 are reserved for omnivision internal use only

07.29.2011  PRODUCT SPECIFICATION                proprietary to OmniVision Technologies

OV5640  color CMOS QSXGA (5 megapixel) image sensor with OmniBSITM technology

        proprietary to OmniVision Technologies  PRODUCT SPECIFICATION          version 2.1

                                                                                                                        5-1

5 image sensor processor digital functions

5.1 ISP general controls

    The ISP module provides lens correction, gamma, de-noise, sharpen, auto focus, etc. These functions are enabled by
    registers 0x5000 ~ 0x5005.

table 5-1   ISP general control registers (sheet 1 of 3)
  address
            register name   default  R/W  description
   0x5000                   value
            ISP CONTROL 00           RW   ISP Control 00
   0x5001                   0x06             Bit[7]: LENC correction enable
            ISP CONTROL 01           RW                   0: Disable
                            0x01                          1: Enable
                                             Bit[5]: RAW gamma enable
                                                          0: Disable
                                                          1: Enable
                                             Bit[2]: Black pixel cancellation enable
                                                          0: Disable
                                                          1: Enable
                                             Bit[1]: White pixel cancellation enable
                                                          0: Disable
                                                          1: Enable
                                             Bit[0]: Color interpolation (CIP) enable
                                                          0: Disable
                                                          1: Enable

                                          ISP Control 01
                                             Bit[7]: Special Digital Effects (SDE)
                                                          enable
                                                          0: Disable
                                                          1: Enable
                                             Bit[5]: Scaling enable
                                                          0: Disable
                                                          1: Enable
                                             Bit[2]: UV average enable
                                                          0: Disable
                                                          1: Enable
                                             Bit[1]: Color matrix enable
                                                          0: Disable
                                                          1: Enable
                                             Bit[0]: Auto white balance (AWB)
                                                          enable
                                                          0: Disable
                                                          1: Enable

07.29.2011  PRODUCT SPECIFICATION                         proprietary to OmniVision Technologies

OV5640  color CMOS QSXGA (5 megapixel) image sensor with OmniBSITM technology

        table 5-1  ISP general control registers (sheet 2 of 3)
          address
                   register name                default  R/W  description
           0x5003                               value
                   ISP CONTROL 03                        RW   ISP Control 03
           0x5005                               0x08             Bit[2]: Bin enable
           0x501E  ISP CONTROL 05                        RW                   0: Disable
                   ISP MISC                     0x36     RW                   1: Enable
                                                                 Bit[1]: Draw window for AFC enable
                                                0x00                          0: Disable
                                                                              1: Enable
                                                                 Bit[0]: Solarize enable
                                                                              0: Disable
                                                                              1: Enable

                                                              ISP Control 05
                                                                 Bit[6]: AWB bias manual enable
                                                                              0: Disable
                                                                              1: Enable
                                                                 Bit[5]: AWB bias on enable
                                                                              0: Disable
                                                                              1: Enable
                                                                 Bit[4]: AWB bias plus enable
                                                                              0: Disable
                                                                              1: Enable
                                                                 Bit[2]: LENC bias on enable
                                                                              0: Disable
                                                                              1: Enable
                                                                 Bit[1]: GMA bias on enable
                                                                              0: Disable
                                                                              1: Enable
                                                                 Bit[0]: LENC bias manual enable
                                                                              0: Disable
                                                                              1: Enable

                                                                 Bit[6]: Scale ratio manual enable

        proprietary to OmniVision Technologies           PRODUCT SPECIFICATION  version 2.1

                                                                                                  5-3

table 5-1   ISP general control registers (sheet 3 of 3)
  address
            register name  default  R/W  description
   0x5020                  value
            DITHER CTRL 0           RW   RGB Dither Control
                           0x00             Bit[6]: Dither register control selection
                                                         enable
                                                         0: From register control
                                                         1: From system control
                                            Bit[5:4]: R channel register control when
                                                         0x501E[6] = 0
                                                         00: Not allowed
                                                         01: RGB444
                                                         10: RGB565/555
                                                         11: Not allowed
                                            Bit[3:2]: G channel register control when
                                                         0x501E[6] = 0
                                                         00: Not allowed
                                                         01: RGB444
                                                         10: RGB565/555
                                                         11: Not allowed
                                            Bit[1:0]: B channel register control when
                                                         0x501E[6] = 0
                                                         00: Not allowed
                                                         01: RGB444
                                                         10: RGB565/555
                                                         11: Not allowed

07.29.2011  PRODUCT SPECIFICATION                         proprietary to OmniVision Technologies

OV5640  color CMOS QSXGA (5 megapixel) image sensor with OmniBSITM technology

        5.2 lens correction (LENC)

            The main purpose of the LENC is to compensate for lens imperfection. According to the area where each pixel is located,
            the module calculates a gain for the pixel, correcting each pixel with its gain calculated to compensate for the light
            distribution due to lens curvature. The LENC correcting curve automatic calculation according sensor gain is also added
            so that the LENC can adapt with the sensor gain. Also, the LENC supports the subsample function in both horizontal and
            vertical directions. Contact your local OmniVision FAE for lens correction settings (registers 0x5800~0x5849).

        table 5-2  LENC control registers (sheet 1 of 2)
          address
                   register name                default  R/W  description
           0x5000                               value
           0x583E  ISP CONTROL 00                        RW   Bit[7]:      LENC correction enable
           0x583F  MAX GAIN                     0x06     R/W               0: Disable
           0x5840  MIN GAIN                     0x40     R/W               1: Enable
                   MIN Q                        0x20     R/W
           0x5841                               0x18          Bit[7:0]: Maximum gain
                   LENC CTRL59                           R/W
           0x5842                               0x0D          Bit[7:0]: Minimum gain
                   BR HSCALE                             RW
           0x5843                               0x01          Bit[6:0]: Minimum Q
                   BR HSCAL                              RW
           0x5844                               0x2B          Bit[3]:      Add BLC enable
                   BR VSCALE                             RW                0: Disable BLC add back function
                                                0x01          Bit[2]:      1: Enable BLC add back function
                                                                           BLC enable
                                                              Bit[1]:      0: Disable BLC function
                                                              Bit[0]:      1: Enable BLC function
                                                                           Gain manual enable
                                                                           Auto Q enable
                                                                           0: Used constant Q (0x40)
                                                                           1: Used calculated Q

                                                              Bit[2:0]:    br h scale[10:8]
                                                                           Reciprocal of horizontal step for BR
                                                                           channel. BR channel in whole image
                                                                           is divided into 5x5 blocks. The step
                                                                           is used to point to the border of the
                                                                           adjacent block

                                                              Bit[7:0]:    br h scale[7:0]
                                                                           Reciprocal of horizontal step for BR
                                                                           channel. BR channel in whole image
                                                                           is divided into 5x5 blocks. The step
                                                                           is used to point to the border of the
                                                                           adjacent block

                                                              Bit[2:0]:    br v scale[10:8]
                                                                           Reciprocal of vertical step for BR
                                                                           channel. BR channel in whole image
                                                                           is divided into 5x5 blocks. The step
                                                                           is used to point to the border of the
                                                                           adjacent block

        proprietary to OmniVision Technologies           PRODUCT SPECIFICATION                     version 2.1

                                                                                                       5-5

table 5-2   LENC control registers (sheet 2 of 2)
  address
            register name  default  R/W            description
   0x5845                  value
   0x5846   BR VSCALE               RW             Bit[7:0]:    br v scale[7:0]
   0x5847   G HSCALE       0x8D     RW                          Reciprocal of vertical step for BR
   0x5848   G HSCAL                 RW                          channel. BR channel in whole image
   0x5849   G VSCALE       0x01     RW                          is divided into 5x5 blocks. The step
            G VSCALE                RW                          is used to point to the border of the
                           0x8F                                 adjacent block

                           0x01                    Bit[2:0]:    g h scale[10:8]
                                                                Reciprocal of horizontal step for G
                           0x09                                 channel. G channel in whole image
                                                                is divided into 6x6 blocks. The step
                                                                is used to point to the border of the
                                                                adjacent block

                                                   Bit[7:0]:    g h scale[7:0]
                                                                Reciprocal of horizontal step for G
                                                                channel. G channel in whole image
                                                                is divided into 6x6 blocks. The step
                                                                is used to point to the border of the
                                                                adjacent block

                                                   Bit[2:0]:    g v scale[10:8]
                                                                Reciprocal of vertical step for G
                                                                channel. G channel in whole image
                                                                is divided into 6x6 blocks. The step
                                                                is used to point to the border of the
                                                                adjacent block

                                                   Bit[7:0]:    g v scale[7:0]
                                                                Reciprocal of vertical step for G
                                                                channel. G channel in whole image
                                                                is divided into 6x6 blocks. The step
                                                                is used to point to the border of the
                                                                adjacent block

07.29.2011  PRODUCT SPECIFICATION                  proprietary to OmniVision Technologies

OV5640  color CMOS QSXGA (5 megapixel) image sensor with OmniBSITM technology

        5.3 auto white balance (AWB)

            The main function of Auto White Balance (AWB) is the process of removing unrealistic color casts so that objects which
            appear white in person are rendered white in the image or video. Thus, the AWB makes sure that the white color is
            always a white color in different color temperatures. It supports manual white balance and auto white balance. For auto
            white balance, simple AWB and advanced AWB methods are supplied. Advance AWB takes into account the color
            temperature of a light source. For advanced AWB settings, contact your local OmniVision FAE.

        table 5-3  AWB control registers (sheet 1 of 2)
          address
                   register name                default  R/W  description
          0x5001                                value
                   ISP CONTROL 01                        RW   Bit[0]:      Auto white balance enable
          0x5181   AWB CONTROL 01               0x01     RW                0: Disable
                   AWB CONTROL 02               0x58     RW                1: Enable
          0x5182   AWB CONTROL 03               0x11     RW
                                                              Bit[7:6]:    Step local
          0x5183   AWB CONTROL 04               0x90     RW   Bit[5:4]:    Step fast
                   AWB CONTROL 05                        RW   Bit[3]:      Slop 8x
          0x5184                                0x25          Bit[2]:      Slop 4x
                                                0x24          Bit[1]:      One zone
          0x5185                                              Bit[0]:      AVG all
          0x5186~
          0x5190                                              Bit[7:4]: Maximum local counter
          0x5191                                              Bit[3:0]: Maximum fast counter
          0x5192
          0x5193                                              Bit[7]:      AWB simple enable
                                                                           0: AWB advance
                                                              Bit[6]:      1: AWB simple
                                                                           YUV enable
                                                              Bit[5]:      1: Simple YUV enable
                                                              Bit[4]:      AWB preset
                                                              Bit[3:2]:    AWB simf
                                                                           AWB win

                                                              Bit[7:6]:    Counter area selection
                                                              Bit[5]:      G enable
                                                              Bit[4:2]:    Counter limit control
                                                              Bit[1:0]:    Counter threshold

                                                              Bit[7:4]:    Stable range unstable
                                                              Bit[3:0]:    Threshold for unstable to stable change
                                                                           Stable range stable
                                                                           Threshold for stable to un-stable change

                   AWB CONTROL                  -        -    Advanced AWB Control Registers

                   AWB CONTROL 17 0xFF                   RW   Bit[7:0]: AWB top limit
                                                              Bit[7:0]: AWB bottom limit
                   AWB CONTROL 18 0x00                   RW   Bit[7:0]: Red limit

                   AWB CONTROL 19 0xF0                   RW

        proprietary to OmniVision Technologies                PRODUCT SPECIFICATION                   version 2.1

                                                                                                     5-7

table 5-3   AWB control registers (sheet 2 of 2)
  address
            register name   default  R/W  description
  0x5194                    value
  0x5195    AWB CONTROL 20           RW           Bit[7:0]: Green limit
            AWB CONTROL 21  0xF0     RW
  0x5196                    0xF0                  Bit[7:0]: Blue limit
            AWB CONTROL 22           RW
  0x5197                    0x03                  Bit[5]:    AWB freeze
  0x519E    AWB CONTROL 23           RW           Bit[3:2]:  AWB simple selection
  0x519F    AWB CONTROL 30  0x02     RW                      00: AWB simple from after AWB gain
  0x51A0    AWB CURRENT     0x00                  Bit[1]:    01: AWB simple from after RAW GMA
  0x51A1    R GAIN                                Bit[0]:    10: AWB simple from after AWB gain
  0x51A2    AWB CURRENT                                      11: AWB simple from after RAW GMA
  0x51A3    R GAIN                                           Fast enable
  0x51A4    AWB CURRENT                                      AWB bias stat
  0x51A5    G GAIN
  0x51A6    AWB CURRENT                           Bit[7:0]: Local limit
  0x51A7    G GAIN
  0x51D0    AWB CURRENT                           Bit[3]:    Local limit select
            B GAIN                                Bit[2]:    Simple stable select
            AWB CURRENT
            B GAIN          -        R            Bit[3:0]: Current R setting[11:8]
            AWB AVERAGE B
            AWB AVERAGE B   -        R            Bit[7:0]: Current R setting[7:0]
            AWB AVERAGE B
                            -        R            Bit[3:0]: Current G setting[11:8]
            AWB CONTROL74
                            -        R            Bit[7:0]: Current G setting[7:0]

                            -        R            Bit[3:0]: Current B setting[11:8]

                            -        R            Bit[7:0]: Current B setting[7:0]

                            -        R            Bit[7:0]: Average r[9:2]

                            -        R            Bit[7:0]: Average g[9:2]

                            -        R            Bit[7:0]: Average b[9:2]

                                                          Bit[5]: R large
                            - R Bit[4]: G large

                                                          Bit[3]: B large
                                                          Bit[2:1]: Current type

07.29.2011  PRODUCT SPECIFICATION                            proprietary to OmniVision Technologies

OV5640  color CMOS QSXGA (5 megapixel) image sensor with OmniBSITM technology

        5.4 raw gamma

            The main purpose of the Gamma (GMA) function is to compensate for the non-linear characteristics of the sensor. GMA
            converts the pixel values according to the Gamma curve to compensate the sensor output under different light strengths.
            The non-linear gamma curve is approximately constructed with different linear functions. Raw gamma compensates the
            image in the RAW domain.

        table 5-4  raw gamma control registers

          address  register name                default  R/W  description
                                                value
           0x5000                                        RW
                                                              Bit[5]:      Raw gamma enable
           0x5001                                        RW                0: Disable GMA
                   ISP CONTROL 00               0x06                       1: Enable GMA
           0x5481                                        RW
           0x5482                                        RW   Bit[7]:      Special digital effect enable
           0x5483                                        RW                0: Disable
           0x5484  ISP CONTROL 01               0x01     RW                1: Enable
           0x5485                                        RW
           0x5486  GAMMA YST00                  0x26     RW   Bit[7:0]: Y yst 00
           0x5487  GAMMA YST01                  0x35     RW
           0x5488  GAMMA YST02                  0x48     RW   Bit[7:0]: Y yst 01
           0x5489  GAMMA YST03                  0x57     RW
           0x548A  GAMMA YST04                  0x63     RW   Bit[7:0]: Y yst 02
           0x548B  GAMMA YST05                  0x6E     RW
           0x548C  GAMMA YST06                  0x77     RW   Bit[7:0]: Y yst 03
           0x548D  GAMMA YST07                  0x80     RW
           0x548E  GAMMA YST08                  0x88     RW   Bit[7:0]: Y yst 04
           0x548F  GAMMA YST09                  0x96     RW
           0x5490  GAMMA YST0A                  0xA3     RW   Bit[7:0]: Y yst 05
                   GAMMA YST0B                  0xAF
                   GAMMA YST0C                  0xC5          Bit[7:0]: Y yst 06
                   GAMMA YST0D                  0xD7
                   GAMMA YST0E                  0xE8          Bit[7:0]: Y yst 07
                   GAMMA YST0F                  0x0F
                                                              Bit[7:0]: Y yst 08

                                                              Bit[7:0]: Y yst 09

                                                              Bit[7:0]: Y yst 0A

                                                              Bit[7:0]: Y yst 0B

                                                              Bit[7:0]: Y yst 0C

                                                              Bit[7:0]: Y yst 0D

                                                              Bit[7:0]: Y yst 0E

                                                              Bit[7:0]: Y yst 0F

        proprietary to OmniVision Technologies           PRODUCT SPECIFICATION               version 2.1

                                                                                                                              5-9

5.5 defect pixel cancellation (DPC)

    Due to processes and other reasons, pixel defects in the sensor array will occur. Thus, these bad or wounded pixels will
    generate wrong color values. The main purpose of Defect Pixel Cancellation (DPC) function is to remove the effect
    caused by these bad or wounded pixels. Also, some special functions are available for those pixels located at the image
    boundary. To remove the defect pixel effect correctly, the proper threshold should first be determined.

table 5-5   DPC control registers  default  R/W  description
   address  register name          value
                                            RW
0x5000      ISP CONTROL 00         0x06          Bit[2]:      Black pixel cancellation
                                                 Bit[1]:      enable
                                                              0: Disable
                                                              1: Enable
                                                              White pixel cancellation
                                                              enable
                                                              0: Disable
                                                              1: Enable

07.29.2011  PRODUCT SPECIFICATION                proprietary to OmniVision Technologies

OV5640  color CMOS QSXGA (5 megapixel) image sensor with OmniBSITM technology

        5.6 color interpolation (CIP)

            The CIP functions include de-noising of raw images, RAW to RGB interpolation, and edge enhancement. In sensor RAW
            format, each pixel will be either R, G or B. CIP will calculate the other two color values using the neighboring pixel of the
            same color. Thus, we can get the full RGB information for each pixel. For edge enhancement, the OV5640 provides both
            manual and auto modes.

        table 5-6    CIP control registers      default  R/W  description
                                                value
          address  register name                         RW   Bit[0]:      Color interpolation enable
                                                0x06                       0: Disable
           0x5000  ISP CONTROL 00                        RW                1: Enable
                                                0x48
           0x5301  CIP SHARPENMT                         RW   Color Interpolation Sharpen MT
                   THRESHOLD 2                  0x18     RW   Threshold 2
           0x5302                               0x0E     RW
           0x5303  CIP SHARPENMT OFFSET1        0x08     RW   CIP Sharpen MT Offset1
           0x5304                               0x48     RW   (Y edge mt manual setting when
           0x5305  CIP SHARPENMT OFFSET2        0x09     RW   0x5308[6]=1)
           0x5306  CIP DNS THRESHOLD 1          0x16     RW
           0x5307  CIP DNS THRESHOLD 2          0x25          CIP Sharpen MT Offset2
           0x5308                                        RW
                   CIP DNS OFFSET1              0x08     RW   CIP DNS Threshold 1
           0x5309                               0x48
           0x530A  CIP DNS OFFSET2                       RW   CIP DNS Threshold 2
                                                0x04     RW
           0x530B  CIP CTRL                     0x06     R    CIP DNS Offset1
           0x530C                               -        R    (DNS threshold manual setting when
           0x530D  CIP SHARPENTH                -        R    0x5308[4]=1)
           0x530E  THRESHOLD 1                  -
           0x530F  CIP SHARPENTH                              CIP DNS Offset2
                   THRESHOLD 2
                                                              Bit[6]:      CIP edge MT manual enable
                   CIP SHARPENTH OFFSET1                      Bit[4]:      CIP DNS manual enable
                                                              Bit[2:0]:    CIP threshold for BR sharpen
                   CIP SHARPENTH OFFSET2
                   CIP EDGE MT AUTO                           CIP Sharpen TH Threshold 1
                   CIP DNS THRESHOLD
                   AUTO                                       CIP Sharpen TH Threshold 2
                   CIP SHARPEN THRESHOLD
                   AUTO                                       CIP Sharpen TH Offset1
                                                              (Sharpen threshold manual setting when
                                                              0x5308[6]=1)
                                                              CIP Sharpen TH Offset2
                                                              CIP Edge MT Auto Read

                                                              CIP DNS Threshold Auto Read

                                                              CIP Sharpen Threshold Auto Read

        proprietary to OmniVision Technologies  PRODUCT SPECIFICATION                         version 2.1

                                                                                                                         5-11

5.7 color matrix (CMX)

The main purpose of the Color Matrix (CMX) function is to cancel out crosstalk and convert color space. Given the color
correction matrix, CCM, and RGB to YUV conversion matrix, RGB2YUV, the combined matrix is:

CMX =       cmx00  cmx01        cmx02  = RGB2YUV × CCM ×  1 -0.25 0.75
            cmx10  cmx11        cmx12                     1 -0.25 -0.25
            cmx20  cmx21        cmx22                     1 0.75 -0.25

            R               R0
where G        = CCM G0

            B               B0

The CMX is then normalized by 20x5394[3:0].

table 5-7          CMX control registers

  address      register name           default  R/W       description
                                       value
   0x5001                                       RW
                                                          Bit[1]:      Color matrix enable
   0x5380                                       RW                     0: Disable
   0x5381      ISP CONTROL 01          0x01     RW                     1: Enable
   0x5382                                       RW
   0x5383                                       RW        Bit[1]:      CMX precision switch
   0x5384                                       RW                     0: 1.7 mode
   0x5385      CMX CTRL                0x00     RW                     1: 2.6 mode
   0x5386                                       RW
   0x5387      CMX1                    0x20     RW        Bit[1]: CMX1 for Y
   0x5388      CMX2                    0x64     RW
   0x5389      CMX3                    0x08     RW        Bit[7:0]: CMX2 for Y
   0x538A      CMX4                    0x30     RW
               CMX5                    0x90               Bit[7:0]: CMX3 for Y
   0x538B      CMX6                    0xC0     RW
               CMX7                    0xA0               Bit[7:0]: CMX4 for U
               CMX8                    0x98
               CMX9                    0x08               Bit[7:0]: CMX5 for U

               CMXSIGN                 0x01               Bit[7:0]: CMX6 for U

                                                          Bit[7:0]: CMX7 for V

                                                          Bit[7:0]: CMX8 for V

                                                          Bit[7:0]: CMX9 for V

                                                          Cmxsign      CMX9 sign
                                                             Bit[0]:

               CMXSIGN                 0x98               Cmxsign      CMX8 sign
                                                             Bit[7]:   CMX7 sign
                                                             Bit[6]:   CMX6 sign
                                                             Bit[5]:   CMX5 sign
                                                             Bit[4]:   CMX4 sign
                                                             Bit[3]:   CMX3 sign
                                                             Bit[2]:   CMX2 sign
                                                             Bit[1]:   CMX1 sign
                                                             Bit[0]:

07.29.2011                      PRODUCT SPECIFICATION                 proprietary to OmniVision Technologies

OV5640  color CMOS QSXGA (5 megapixel) image sensor with OmniBSITM technology

        5.8 UV average

        The main function of the UV average is to average the U/V channel value using special filters.

        table 5-8    UV average register

        address      register name              default  R/W  description
                                                value
        0x5001       ISP CONTROL 01                      RW   Bit[2]:           UV average enable
                                                0x4F                            0: Disable
                                                                                1: Enable

        5.9 scaling

        The main purpose of the scaling function is to zoom out the image. According to the new width and new height of the
        new image, the module uses the values of several pixels to generate the values of one pixel. The values of some pixels
        are divided and used in two or more adjacent pixels. The scaling function supports up to 32x scale.

        table 5-9    UV average register

        address      register name              default  R/W  description
                                                value
        0x5001       ISP CONTROL 01                      RW   Bit[5]:           Scale enable
                                                0x01                            0: Disable
                                                         RW                     1: Enable
                                                0x00
        0x5601       SCALE CTRL 1                        RW   Bit[6:4]:         HDIV RW
                                                0x02     RW   Bit[2:0]:         DCW scale times
                                                0x00     RW                     000: DCW 1 time
                                                0x02     RW                     001: DCW 2 time
                                                0x00     RW                     010: DCW 4 time
                                                0x00                            100: DCW 8 time
                                                                                101: DCW 16 time
                                                                                Others: DCW 16 time
                                                                                VDIV RW
                                                                                DCW scale times
                                                                                000: DCW 1 time
                                                                                001: DCW 2 time
                                                                                010: DCW 4 time
                                                                                100: DCW 8 time
                                                                                101: DCW 16 time
                                                                                Others: DCW 16 time

        0x5602       SCALE CTRL 2                             XSC High Bits
        0x5603       SCALE CTRL 3
        0x5604       SCALE CTRL 4                             XSC Low Bits
        0x5605       SCALE CTRL 5
        0x5606       SCALE CTRL 6                             YSC High Bits

                                                              YSC Low Bits

                                                              Bit[3:0]: Voffset

        proprietary to OmniVision Technologies           PRODUCT SPECIFICATION                          version 2.1

                                                                                                                                    5-13

5.10 UV adjustUV adjust in

    The main function of the UV adjust is to adjust the U/V channel value according to sensor gain. It supports both manual
    and auto modes.
    The UV adjust function is integrated in SDE. The main function of the UV adjust is to adjust the U/V channel value
    according to sensor gain. It supports both manual and auto modes

   5.10.1 manual mode

    By setting SDE CTRL 0 [1] (0x5580) to 1 and SDE CTRL 8 0x5588[6] to 1, UV adjust is controlled only by register SAT
    U (0X5583[7:0] and SAT V (0x5584[7:0]] for U and V gains.

   5.10.2 auto mode

    When the UV adjust is set for auto mode(0x5580[1]=1 and 0x5588[6]=0), the UV adjust curve parameters (see
    figure 5-1) should be entered into the corresponding registers. The UV adjust parameters, UV adj th1, UV adj th2, and
    offset low, offset high should be entered into the registers to set the curve. To get these values, first set the values of UV
    adj th1, UV adj th2, offset low and offset high. Then, calculate the values of a and k as follows:
    k = (offset high - offset low) / (UV adj th2 - UV adj th1)
    a = offset high + (offset high - offset low)/(UV adj th2 - UV adj th1)
    Registers to be changed:
    · UV adj th1[8:0] = registers 0x5589[7:0]
    · UV adj th2[8:0] = registers {0x558A[0], 0x558B[7:0]}
    · offset high = register 0x5583[7:0] (when 0x5580[1]=1 and 0x5588[6]=0)
    · offset low = register 0x5584[7:0] (when 0x5580[1]=1 and 0x5588[6]=0)

   figure 5-1 UV adjust graph

                         offset_high

                                                                                                              y = a - kx

            offset_low

                          UV adj th1                       UV adj th2

                                                 AGC gain              5640_DS_5_1

07.29.2011                PRODUCT SPECIFICATION            proprietary to OmniVision Technologies

OV5640  color CMOS QSXGA (5 megapixel) image sensor with OmniBSITM technology

        5.11 special digital effects (SDE)

        The Special Digital Effects (SDE) functions include hue/saturation control, brightness, contrast, etc. SDE also supports
        negative, black/white, sepia, greenish, blueish, redish, solarize and other image effects.

        table 5-10 SDE control registers

        address  register name   default        R/W  description
                                 value
        0x5001   ISP CONTROL 01                 RW   Bit[7]:      Special digital effect enable
        0x5581   SDE CTRL1       0x01           RW                0: Disable
        0x5582   SDE CTRL2       0x80           RW                1: Enable
        0x5583   SDE CTRL3       0x00           RW
                                 0x40                Bit[7:0]: Hue cos coefficient
        0x5584   SDE CTRL4                      RW
        0x5585   SDE CTRL5       0x40           RW   Bit[7:0]: Hue sin coefficient
        0x5586   SDE CTRL6       0x00           RW
        0x5587   SDE CTRL7       0x20           RW   Bit[7:0]:    Saturation U when 0x5580[1]=1 and
                                 0x00                             0x5588[6]=1, max value for UV adjust when
        0x5588   SDE CTRL8                      RW                0x5580[1]=1 and 0x5588[6]=0; or fixed U
                                 0x01                             when 0x5580[3]=1
        0x5589   SDE CTRL9                      RW
        0x558A   SDE CTRL10      0x01           RW   Bit[7:0]:    Saturation V when 0x5580[1]=1 and
        0x558B   SDE CTRL11      0x01           RW                0x5588[6]=1, min value for UV adjust when
        0x558C   SDE CTRL12      0xFF           R                 0x5580[1]=1 and 0x5588[6]=0; or Vreg
                                 -                                when 0x5580[4]=1

                                                     Bit[7:0]: Yoffset for contrast when 0x5044[3]=1; or
                                                                 fixed Y when 0x5580[7]=1

                                                     Bit[7:0]: Y gain for contrast

                                                     Bit[7:0]: Y bright for contrast

                                                     Bit[6]:      UV adjust manual enable
                                                     Bit[5]:      Sign5 for hue V, cos
                                                     Bit[4]:      Sign4 for hue U, cos
                                                     Bit[3]:      Sign3 Y bright sign for contrast
                                                                  0: Keep Y bright sign
                                                     Bit[2]:      1: Negative Y bright sign
                                                                  Sign2
                                                     Bit[1]:      Y offset sign for contrast when 0x5044[3]=1
                                                     Bit[0]:      0: Keep Y offset sign
                                                                  1: Negative Y offset sign
                                                                  Sign1 for hue V, sin
                                                                  Sign0 for hue U, sin

                                                     Bit[7:0]: UV adjust threshold 1
                                                                 Valid when 0x5580[1]=1

                                                     Bit[0]:      UV adjust threshold 2[8]
                                                                  Valid when 0x5580[1]=1

                                                     Bit[7:0]: UV adjust threshold 2[7:0]
                                                                 Valid when 0x5580[1]=1

                                                     Bit[7:0]: UV adjust value read out

        proprietary to OmniVision Technologies       PRODUCT SPECIFICATION                       version 2.1

                                                                                                                           5-15

5.12 ISP format

table 5-11 ISP format control registers

address register name   default          description
                        value R/W
                                         Format MUX Control
0x501F      FORMAT MUX  0x00   RW           Bit[2:0]: Format selection
            CONTROL                                      000: ISP YUV422
                                                         001: ISP RGB
                                                         010: ISP dither
                                                         011: ISP RAW (DPC)
                                                         100: SNR RAW
                                                         101: ISP RAW (CIP)

5.13 draw window

    The draw window module is used to display a window on top of live video. It is usually used by autofocus to display a
    focus window.

table 5-12 draw window registers (sheet 1 of 2)

address register name          default           description
                               value R/W

                                                 Bit[1]:      Draw window for AFC enable
                                                              0: Disable
0x5003 ISP CONTROL 03          0x08      RW                   1: Enable

                                                 Bit[2:0]:    Format select
                                                              000: ISP YUV422
0x501F FORMAT MUX CONTROL      0x00      RW                   001: ISP RGB
                                                              010: ISP dither
                                                              011: ISP RAW (DPC)
                                                              100: SNR RAW
                                                              101: ISP RAW (CIP)

            DRAW WINDOW                          Bit[0]:      Draw window control
            CONTROL 00                                        0: No fixed Y
0x5027                         0x02      RW                   1: Fixed Y
0x5028      DRAW WINDOW LEFT
0x5029      POSITION CONTROL   0x04      RW      Bit[3:0]: Draw window left[11:8] high byte
0x502A
            DRAW WINDOW LEFT   0x90      RW      Bit[7:0]: Draw window left[7:0] low byte
            POSITION CONTROL
                               0x05      RW      Bit[3:0]: Draw window right[11:8] high byte
            DRAW WINDOW RIGHT
            POSITION CONTROL

07.29.2011       PRODUCT SPECIFICATION           proprietary to OmniVision Technologies

OV5640  color CMOS QSXGA (5 megapixel) image sensor with OmniBSITM technology

        table 5-12 draw window registers (sheet 2 of 2)

        address  register name                  default    description
                                                value R/W
        0x502B   DRAW WINDOW RIGHT                            Bit[7:0]: Draw window right[7:0] low byte
        0x502C   POSITION CONTROL               0x90  RW
        0x502D                                                Bit[2:0]: Draw window top[10:8] high byte
        0x502E   DRAW WINDOW TOP                0x03  RW
        0x502F   POSITION CONTROL                             Bit[7:0]: Draw window top[7:0] low byte
        0x5030                                  0x6C  RW      Bit[2:0]: Draw window bottom[10:8] high
                 DRAW WINDOW TOP
        0x5031   POSITION CONTROL               0x04  RW                   byte
                                                              Bit[7:0]: Draw window bottom[7:0] low byte
        0x5032   DRAW WINDOW BOTTOM             0x2C  RW
                 POSITION CONTROL                             Bit[3:0]: Draw window horizontal boundary
        0x5033                                  0x00  RW                   width[11:8] high byte
        0x5034   DRAW WINDOW BOTTOM
        0x5035   POSITION CONTROL               0x14  RW      Bit[7:0]: Draw window horizontal boundary
        0x5036                                                             width[7:0] low byte
                 DRAW WINDOW                    0x00  RW
                 HORIZONTAL BOUNDARY                          Bit[2:0]: Draw window vertical boundary
                 WIDTH CONTROL                  0x14  RW                   width[10:8] high byte

                 DRAW WINDOW                    0x80  RW      Bit[7:0]: Draw window vertical boundary
                 HORIZONTAL BOUNDARY                                       width[7:0] low byte
                 WIDTH CONTROL                  0x2A  RW
                                                              Bit[7:0]: Fixed Y for draw window
                 DRAW WINDOW VERTICAL           0x14  RW
                 BOUNDARY WIDTH                               Bit[7:0]: Fixed U for draw window
                 CONTROL
                                                              Bit[7:0]: Fixed V for draw window
                 DRAW WINDOW VERTICAL
                 BOUNDARY WIDTH
                 CONTROL

                 DRAW WINDOW Y
                 CONTROL

                 DRAW WINDOW U
                 CONTROL

                 DRAW WINDOW V
                 CONTROL

        proprietary to OmniVision Technologies        PRODUCT SPECIFICATION    version 2.1

                                                                                                                            6-1

6 image sensor output interface digital functions

6.1 compression engine

    The OV5640 compression is JPEG standard baseline compatible. It does not support EXIF, JIFF, or any extended JPEG
    feature. The OV5640 DVP output supports multiple compression modes, where each mode corresponds to different
    HREF timing. For the MIPI output, the data type is the generic type 0x30 and only supports compression mode 2 with no
    thumbnail and no fixed line number of each frame.

   6.1.1 compression mode 1 timing

    The whole frame has only one line. PCLK will be gated when there is no valid image data transmitted.

   figure 6-1 compression mode 1 timing

         HREF

PCLK

                                   5640_DS_6_1

6.1.2 compression mode 2 timing

Compression data is transmitted with programmable line width. PCLK is free running. The last line may contain dummy
data to match the width. By default, the line number varies from frame to frame. For DVP output, the user can set register
0x4600[5] (0x4600) to ensure every frame has a fixed line number (programmable). For MIPI, fixed line number is not
supported. In figure 6-2 below, each HREF corresponds to one long data packet. The rising edge of VSYNC
corresponds to the frame end short packet and the falling edge corresponds to the frame start short packet.

figure 6-2 compression mode 2 timing

      HREF

VSYNC

                                   5640_DS_6_2

07.29.2011  PRODUCT SPECIFICATION  proprietary to OmniVision Technologies

OV5640  color CMOS QSXGA (5 megapixel) image sensor with OmniBSITM technology

        6.1.3 compression mode 3 timing

        Compression data is transmitted with programmable width. The last line width maybe different from the other line (there
        is no dummy data). In each frame, the line number may be different.

        figure 6-3 compression mode 3 timing

              HREF

        VSYNC

                                                                                       5640_DS_6_3

        6.1.4 compression mode 4 timing

        The width and height are fixed in each frame. The first two bytes are valid data length in every line, followed by valid
        image data. Dummy data (0xFF) may be used as padding at each line end if the current valid image data is less than the
        line width.

        figure 6-4  compression mode 4 timing

           VSYNC                  VSYNC to HREF delay

        HREF

        PCLK        valid data                  valid data           dummy data
        D[9:2]        length

                    Len_h Len_l data data data              data FF  FF  FF        FF

                                                                                       5640_DS_6_4

        proprietary to OmniVision Technologies              PRODUCT SPECIFICATION      version 2.1

                                                                                                                                 6-3

6.1.5 compression mode 5 timing

The width and height are fixed in each frame. Every line begins with valid image data. Dummy data may be used as
padding at each line end if the current valid image data is less than the line width. The last two bytes of every line is valid
data length.

figure 6-5          compression mode 5 timing

   VSYNC                          VSYNC to HREF delay

HREF

PCLK                        valid data                       dummy data             valid data
D[9:2]                                                                                length
                    data data data data FF                   FF  FF
                                                                             FF Len_h Len_l

                                                                                                5640_DS_6_5

6.1.6 compression mode 6 timing

The width and height are fixed in each frame. Every line begins with valid image data. Dummy data may be used as
padding at each line end if the current valid image data less than the line width.

figure 6-6          compression mode 6 timing

            VSYNC                       VSYNC to HREF delay

            HREF

            PCLK             valid data                      FF  FF      FF  FF  FF
            D[9:2]
                    data data data data FF

                                                                 dummy data                     5640_DS_6_6

07.29.2011          PRODUCT SPECIFICATION                                    proprietary to OmniVision Technologies

OV5640  color CMOS QSXGA (5 megapixel) image sensor with OmniBSITM technology

        6.1.7 compression mode control

        table 6-1  compression control registers (sheet 1 of 2)
          address
                   register name                default  R/W  description
          0x3821                                value
                   COMPRESSION ENABLE                    RW      Bit[5]: JPEG enable
          0x4600                                0x00
                   VFIFO CTRL00                          RW      Bit[5]:    JPEG output fixed height enable
          0x4602                                0x80                        0: In JPEG mode2, JPEG
          0x4603   VFIFO HSIZE                           RW
          0x4604   VFIFO HSIZE                  0x04     RW                        height is different in each
          0x4605   VFIFO VSIZE                  0x00     RW                        frame
          0x460C   VFIFO HSIZE                  0x03     RW                 1: In JPEG mode2, JPEG
          0x460D   VFIFO CTRL0C                 0x00     RW                        height is fixed in each
                   VFIFO CTRL0D                 0x20     RW                        frame
          0x4713                                0x00
                   JPG MODE SELECT                       RW   JPEG Output Width High Byte
          0x471F                                0x02
          0x4723   DVP HREF CTRL                         RW   JPEG Output Width Low Byte
          0x4400   DVP CTRL23                   0x40     RW
                   JPEG CTRL00                  0x00     RW   JPEG Output Height High Byte
          0x4401                                0x81
                   JPEG CTRL01                           RW   JPEG Output Height Low Byte
                                                0x01
                                                                 Bit[7:4]: JPEG dummy data pad speed

                                                              JPEG PAD Dummy Data

                                                                 Bit[2:0]:  JPEG mode select
                                                                            001: JPEG mode 1
                                                                            010: JPEG mode 2
                                                                            011: JPEG mode 3
                                                                            100: JPEG mode 4
                                                                            101: JPEG mode 5
                                                                            110: JPEG mode 6

                                                              HREF Minimum Blanking in JPEG Mode23

                                                              DVP JPEG Mode456 Skip Line Number

                                                                 Bit[7]:    input_format
                                                                 Bit[6:0]:  0: YUV420
                                                                            1: YUV422
                                                                            JFIFO read speed control

                                                                 Bit[7:4]:  SFIFO output buffer speed
                                                                 Bit[3]:    control
                                                                            Read SRAM enable when
                                                                 Bit[2]:    blanking
                                                                 Bit[1:0]:  0: Disable
                                                                            1: Enable
                                                                            Read SRAM at first blanking
                                                                            0: Disable
                                                                            1: Enable
                                                                            SFIFO read speed control

        proprietary to OmniVision Technologies           PRODUCT SPECIFICATION                version 2.1

                                                                                                                              6-5

table 6-1   compression control registers (sheet 2 of 2)
  address
            register name   default  R/W             description
  0x4404                    value
  0x4417    JPEG CTRL04              RW                   Bit[7]:    jfifo_pwrdn
            JFIFO OVERFLOW  0x24     R                    Bit[6]:    SFIFO pwrdn
                                                          Bit[5]:    Header output enable
                            -                             Bit[4]:    Enable gated clock
                                                                     0: Disable gated clock
                                                          Bit[3]:    1: Enable gated clock
                                                          Bit[2:0]:  Substitute 0xFF to 0xFE in QT
                                                                     Quantization rounding
                                                                     Bias: set value = Bias/8

                                                          Bit[0]: JFIFO overflow indicator

6.2 system control

    System control registers include clock, reset control, and PLL configure. Individual modules can be reset or clock gated
    by setting the appropriate registers.

table 6-2   system control registers (sheet 1 of 3)
  address
                            default
   0x3000
            register name   value    R/W             description
   0x3001
            SYSTEM RESET00  0x30     RW              Reset for Individual Block
                                                     (0: enable block; 1: reset block)
            SYSTEM RESET01  0x08     RW
                                                        Bit[7]: Reset BIST
                                                        Bit[6]: Reset MCU program memory
                                                        Bit[5]: Reset MCU
                                                        Bit[4]: Reset OTP
                                                        Bit[3]: Reset STB
                                                        Bit[2]: Reset d5060
                                                        Bit[1]: Reset timing control
                                                        Bit[0]: Reset array control

                                                     Reset for Individual Block
                                                     (0: enable block; 1: reset block)

                                                        Bit[7]: Reset AWB registers
                                                        Bit[6]: Reset AFC
                                                        Bit[5]: Reset ISP
                                                        Bit[4]: Reset FC
                                                        Bit[3]: Reset S2P
                                                        Bit[2]: Reset BLC
                                                        Bit[1]: Reset AEC registers
                                                        Bit[0]: Reset AEC

07.29.2011  PRODUCT SPECIFICATION                         proprietary to OmniVision Technologies

OV5640  color CMOS QSXGA (5 megapixel) image sensor with OmniBSITM technology

        table 6-2  system control registers (sheet 2 of 3)
          address
                                                default
           0x3002
           0x3003  register name                value    R/W  description

           0x3004  SYSTEM RESET02               0x1C     RW   Reset for Individual Block
                                                              (0: enable block; 1: reset block)
           0x3005  SYSTEM RESET03               0x00     RW
           0x3006                                                Bit[7]: Reset VFIFO
                   CLOCK ENABLE00               0xCF     RW      Bit[5]: Reset format
                                                                 Bit[4]: Reset JFIFO
                   CLOCK ENABLE01               0xF7     RW      Bit[3]: Reset SFIFO
                                                                 Bit[2]: Reset JPG
                   CLOCK ENABLE02               0xE3     RW      Bit[1]: Reset format MUX
                                                                 Bit[0]: Reset average

                                                              Reset for Individual Block
                                                              (0: enable block; 1: reset block)

                                                                 Bit[5]: Reset digital gain compensation
                                                                 Bit[4]: Reset SYNC FIFO
                                                                 Bit[3]: Reset PSRAM
                                                                 Bit[2]: Reset ISP FC
                                                                 Bit[1]: Reset MIPI
                                                                 Bit[0]: Reset DVP

                                                              Clock Enable Control
                                                              (0: disable clock; 1: enable clock)

                                                                 Bit[7]: Enable BIST clock
                                                                 Bit[6]: Enable MCU program memory

                                                                              clock
                                                                 Bit[5]: Enable MCU clock
                                                                 Bit[4]: Enable OTP clock
                                                                 Bit[3]: Enable STROBE clock
                                                                 Bit[2]: Enable D5060 clock
                                                                 Bit[1]: Enable timing control clock
                                                                 Bit[0]: Enable array control clock

                                                              Clock Enable Control
                                                              (0: disable clock; 1: enable clock)

                                                                 Bit[7]: Enable AWB register clock
                                                                 Bit[6]: Enable AFC clock
                                                                 Bit[5]: Enable ISP clock
                                                                 Bit[4]: Enable FC clock
                                                                 Bit[3]: Enable S2P clock
                                                                 Bit[2]: Enable BLC clock
                                                                 Bit[1]: Enable AEC register clock
                                                                 Bit[0]: Enable AEC clock

                                                              Clock Enable Control
                                                              (0: disable clock; 1: enable clock)

                                                                 Bit[7]: Enable PSRAM clock
                                                                 Bit[6]: Enable FMT clock
                                                                 Bit[5]: Enable JPEG 2x clock
                                                                 Bit[3]: Enable JPEG clock
                                                                 Bit[1]: Enable format MUX clock
                                                                 Bit[0]: Enable average clock

        proprietary to OmniVision Technologies           PRODUCT SPECIFICATION  version 2.1

                                                                                                    6-7

table 6-2   system control registers (sheet 3 of 3)
  address
                             default
   0x3007
            register name    value    R/W            description
   0x3008
   0x3034   CLOCK ENABLE03   0xFF     RW             Clock Enable Control
   0x3035                                            (0: disable clock; 1: enable clock)
   0x3036
   0x3037                                               Bit[7]: Enable digital gain compensation
   0x3039                                                            clock

                                                        Bit[6]: Enable SYNC FIFO clock
                                                        Bit[5]: Enable ISPFC SCLK clock
                                                        Bit[4]: Enable MIPI PCLK clock
                                                        Bit[3]: Enable MIPI clock
                                                        Bit[2]: Enable DVP PCLK clock
                                                        Bit[1]: Enable VFIFO PCLK clock
                                                        Bit[0]: Enable VFIFO SCLK clock

            SYSTEM CTROL0    0x02     RW             System Control
            SC PLL CONTRL0                              Bit[7]: Software reset
                                                        Bit[6]: Software power down

                             0x1A     RW             Bit[6:4]:    PLL charge pump control
                                                     Bit[3:0]:    MIPI bit mode
                                                                  0x8: 8-bit mode
                                                                  0xA: 10-bit mode

            SC PLL CONTRL1   0x11     RW             Bit[7:4]:    System clock divider
                                                     Bit[3:0]:    Slow down all clocks
                                                                  Scale divider for MIPI
                                                                  MIPI PCLK/SERCLK can be
                                                                  slowed down

                                                     Bit[7:0]:    PLL multiplier (4~252)
                                                                  Can be any integer for 4~127 and
            SC PLL CONTRL2   0x69     RW                          only even integer for 128~252

            SC PLL CONTRL3   0x03     RW             Bit[4]:      PLL root divider
            SC PLL CONTRL 5                          Bit[3:0]:    0: Bypass
                                                                  1: Divided by 2
                                                                  PLL pre-divider
                                                                  1, 2, 3, 4, 6, 8

                             0x00     RW             Bit[7]: PLL bypass

07.29.2011  PRODUCT SPECIFICATION                    proprietary to OmniVision Technologies

OV5640  color CMOS QSXGA (5 megapixel) image sensor with OmniBSITM technology

        6.3 microcontroller unit (MCU)

            The MCU firmware can be downloaded by writing to registers starting from 0x8000. A total of 4 KB of program memory
            can be used for program storage. Before downloading the firmware, the user must enable the MCU clock by setting
            register 0x3000[5] to 1'b1. After downloading the firmware, set register 0x3000[5] to 1'b0 to enable the MCU. The MCU
            interrupts are triggered by several internal signals for firmware development.

        table 6-3  MCU control registers (sheet 1 of 2)
          address
                   register name                default    description
          0x3F00                                value R/W

          0x3F01   MC CTRL 00                   0x00  RW   Bit[0]:      MCU soft reset
                                                                        1: Reset MCU
          0x3F02
                   MC INTERRUPT                 0x00  RW   Mask0 for Interrupt
          0x3F03   MASK0                                   (0: disable interrupt bit; 1: enable interrupt bit)
          0x3F04
          0x3F05                                              Bit[7]: JFIFO over flow
          0x3F06                                              Bit[6]: JFIFO end of image
                                                              Bit[5]: ISP end of frame
                                                              Bit[4]: ISP start of frame
                                                              Bit[3]: AFC done
                                                              Bit[2]: AWB done
                                                              Bit[1]: VFIFO full
                                                              Bit[0]: VFIFO empty

                   MC INTERRUPT                 0x00  RW   Mask1 for Interrupt
                   MASK1                                   (0: disable interrupt bit; 1: enable interrupt bit)

                                                              Bit[7]: AEC done
                                                              Bit[6]: ISP average done
                                                              Bit[5]: AEC trigger
                                                              Bit[4]: JPG over size
                                                              Bit[3]: SRM operation start
                                                              Bit[2]: SRM operation done
                                                              Bit[1]: DVP frame counter change
                                                              Bit[0]: BLC start of frame

                   MC READ INTERRUPT 0x70 RW               Bit[7:0]: Set high byte for SCCB address that
                   ADDRESS                                             will trigger interrupt when read
                   MC READ INTERRUPT 0x00 RW
                   ADDRESS                                 Bit[7:0]: Set low byte for SCCB address that
                   MC WRITE INTERRUPT 0x70 RW                          will trigger interrupt when read
                   ADDRESS
                   MC WRITE INTERRUPT 0x04 RW              Bit[7:0]: Set high byte for SCCB address that
                   ADDRESS                                             will trigger interrupt when written

                                                           Bit[7:0]: Set low byte for SCCB address that
                                                                       will trigger interrupt when written

        proprietary to OmniVision Technologies        PRODUCT SPECIFICATION             version 2.1

                                                                                                   6-9

table 6-3   MCU control registers (sheet 2 of 2)
  address
            register name         default         description
  0x3F0C                          value R/W
                                                  Interrupt0 Status Indicator
  0x3F0D    MC INTERRUPT0         0x00     RW        Bit[5]: ISP EOF
            STATUS                                   Bit[4]: ISP SOF
                                                     Bit[2]: AWB done
            MC INTERRUPT1         0x00     RW        Bit[1]: VFIFO full
            STATUS                                   Bit[0]: VFIFO empty

                                                  Interrupt1 Status Indicator
                                                     Bit[7]: AEC done
                                                     Bit[6]: Average done
                                                     Bit[5]: AEC trigger
                                                     Bit[3]: MIPI turn around
                                                     Bit[2]: MIPI low power contention detect
                                                     Bit[0]: BLC SOF

6.4 frame control (FC)

    Frame control (FC) is used to mask some specified frame by setting the appropriate registers.

table 6-4   FC control registers

address register name             default  R/W    description
                                  value
0x4201      FRAME CONTROL 00               RW     Control Passed Frame Number
                                  0x00     RW     When both ON and OFF numbers are set to
0x4202      FRAME CONTROL 01                      0x00, frame control is in bypass mode
                                  0x00
                                                     Bit[3:0]: Frame ON number

                                                  Control Masked Frame Number
                                                  When both ON and OFF numbers are set to
                                                  0x00, frame control is in bypass mode

                                                     Bit[3:0]: Frame OFF number

07.29.2011  PRODUCT SPECIFICATION                 proprietary to OmniVision Technologies

OV5640  color CMOS QSXGA (5 megapixel) image sensor with OmniBSITM technology

        6.5 format description

        Format control converts the internal data format into the desired output format including YUV, RGB, or RAW.

        table 6-5  format control registers (sheet 1 of 5)

        address register name                   default  R/W  description
                                                value
                                                         RW   Format Control 00
                                                0xF8             Bit[7:4]: Output format of formatter module

                                                                           0x0: RAW          Output sequence
                                                                                  Bit[3:0]:  0x0: BGBG... / GRGR...
                                                                                             0x1: GBGB... / RGRG...
                                                                                             0x2: GRGR... / BGBG...
                                                                                             0x3: RGRG... / GBGB...
                                                                                             0x4~0xF: Not allowed

                                                                           0x1: Y8
                                                                                  Bit[3:0]: Does not matter

        0x4300     FORMAT CONTROL                                          0x2: YUV444/RGB888 (not available for
                   00                                                             full resolution)
                                                                                  Bit[3:0]: Output sequence
                                                                                              0x0: YUVYUV..., or
                                                                                                      GBRGBR...
                                                                                              0x1: YVUYVU..., or
                                                                                                      GRBGRB...
                                                                                              0x2: UYVUYV..., or
                                                                                                      BGRBGR...
                                                                                              0x3: VYUVYU..., or
                                                                                                      RGBRGB...
                                                                                              0x4: UVYUVY..., or
                                                                                                      BRGBRG...
                                                                                              0x5: VUYVUY..., or
                                                                                                      RBGRBG...
                                                                                              0x6~0xE: Not allowed
                                                                                              0xF: UYVUYV..., or
                                                                                                      BGRBGR...

                                                                           0x3: YUV422
                                                                                  Bit[3:0]: Output sequence
                                                                                              0x0: YUYV...
                                                                                              0x1: YVYU...
                                                                                              0x2: UYVY...
                                                                                              0x3: VYUY...
                                                                                              0x4~0xE: Not allowed
                                                                                              0xF: UYVY...

                                                                           0x4: YUV420
                                                                                  Bit[3:0]: Output sequence
                                                                                              0x0: YYYY... / YUYV...
                                                                                              0x1: YYYY... / YVYU...
                                                                                              0x2: YYYY... / UYVY...
                                                                                              0x3: YYYY... / VYUY...
                                                                                              0x4: YUYV... / YYYY...

        proprietary to OmniVision Technologies                PRODUCT SPECIFICATION                          version 2.1

                                                                                                      6-11

table 6-5   format control registers (sheet 2 of 5)

address register name  default  R/W  description
                       value
                                                                        0x5: YVYU... / YYYY...
                                                                        0x6: UYVY... / YYYY...
                                                                        0x7: VYUY... / YYYY...
                                                                        0x8~0xE: Not allowed
                                                                        0xF: YYYY... / UYVY...
                                                     0x5: YUV420 (for MIPI only)
                                                            Bit[3:0]: Output sequence
                                                                        0x0~0xD: Not allowed
                                                                        0xE: VYYVYY... /

                                                                                UYYUYY...
                                                                        0xF: UYYUYY... /

                                                                                VYYVYY...
                                                     0x6: RGB565

                                                            Bit[3:0]: Output sequence
                                                                        0x0: {b[4:0],g[5:3]},
                                                                                {g[2:0],r[4:0]}
                                                                        0x1: {r[4:0],g[5:3]},
                                                                                {g[2:0],b[4:0]}
                                                                        0x2: {g[4:0],r[5:3]},
                                                                                {r[2:0],b[4:0]}
                                                                        0x3: {b[4:0],r[5:3]},
                                                                                {r[2:0],g[4:0]}
                                                                        0x4: {g[4:0],b[5:3]},
                                                                                {b[2:0],r[4:0]}
                                                                        0x5: {r[4:0],b[5:3]},
                                                                                {b[2:0],g[4:0]}
                                                                        0x6~0xE: Not allowed
                                                                        0xF: {g[2:0],b[4:0]},
                                                                                {r[4:0],g[5:3]}

                                                     0x7: RGB555 format 1
                                                            Bit[3:0]: Output sequence
                                                                        0x0: {b[4:0],g[4:2]},
                                                                                {g[1:0],1'b0,r[4:0]}
                                                                        0x1: {r[4:0],g[4:2]},
                                                                                {g[1:0],1'b0,b[4:0]}
                                                                        0x2: {g[4:0],r[4:2]},
                                                                                {r[1:0],1'b0,b[4:0]}
                                                                        0x3: {b[4:0],r[4:2]},
                                                                                {r[1:0],1'b0,g[4:0]}
                                                                        0x4: {r[4:0],b[4:2]},
                                                                                {b[1:0],1'b0,g[4:0]}
                                                                        0x5: {g[4:0],b[4:2]},
                                                                                {b[1:0],1'b0,r[4:0]}
                                                                        0x6~0xE: Not allowed
                                                                        0xF: {g[1:0],1'b0,b[4:0]},
                                                                                {r[4:0],g[4:2]}

                                                     0x8: RGB555 format 2
                                                            Bit[3:0]: Output sequence
                                                                        0x0: {1'b0,b[4:0],g[4:3]},
                                                                                {g[2:0],r[4:0]}

07.29.2011  PRODUCT SPECIFICATION                    proprietary to OmniVision Technologies

OV5640  color CMOS QSXGA (5 megapixel) image sensor with OmniBSITM technology

        table 6-5  format control registers (sheet 3 of 5)

        address register name                   default  R/W  description
                                                value
                                                                                                 0x1: {1'b0,r[4:0],g[4:2]},
                                                                                                         {g[2:0],b[4:0]}

                                                                                                 0x2: {1'b0,g[4:0],r[4:2]},
                                                                                                         {r[2:0],b[4:0]}

                                                                                                 0x3: {1'b0,b[4:0],r[4:2]},
                                                                                                         {r[2:0],g[4:0]}

                                                                                                 0x4: {1'b0,r[4:0],b[4:2]},
                                                                                                         {b[2:0],g[4:0]}

                                                                                                 0x5: {1'b0,g[4:0],b[4:2]},
                                                                                                         {b[2:0],r[4:0]}

                                                                                                 0x6: {b[4:0],1'b0,g[4:3]},
                                                                                                         {g[2:0],r[4:0]}

                                                                                                 0x7: {r[4:0],1'b0,g[4:2]},
                                                                                                         {g[2:0],b[4:0]}

                                                                                                 0x8: {g[4:0],1'b0,r[4:2]},
                                                                                                         {r[2:0],b[4:0]}

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
                                                                                                 0xA: {r[3:0],1'b0,b[3:1]},
                                                                                                         {b[0],2'h0,g[3:0],1'b0}
                                                                                                 0xB: {g[3:0],1'b0,b[3:1]},
                                                                                                         {b[0],2'h0,r[3:0],1'b0}
                                                                                                 0xC~0xE: Not allowed

        proprietary to OmniVision Technologies                PRODUCT SPECIFICATION  version 2.1

                                                                                                          6-13

table 6-5   format control registers (sheet 4 of 5)

address register name  default  R/W  description
                       value
                                                                        0xF: {g[0],2'h2,b[3:0],1'b1},
                                                                                {r[3:0],1'b1,g[3:1]}

                                                     0xA: RGB444 format 2
                                                            Bit[3:0]: Output sequence
                                                                        0x0: {4'b0,b[3:0]},
                                                                                {g[3:0],r[3:0]}
                                                                        0x1: {4'b0,r[3:0]},
                                                                                {g[3:0],b[3:0]}
                                                                        0x2: {4'b0,b[3:0]},
                                                                                {r[3:0],g[3:0]}
                                                                        0x3: {4'b0,r[3:0]},
                                                                                {b[3:0],g[3:0]}
                                                                        0x4: {4'b0,g[3:0]},
                                                                                {b[3:0],r[3:0]}
                                                                        0x5: {4'b0,g[3:0]},
                                                                                {r[3:0],b[3:0]}
                                                                        0x6: {b[3:0],g[3:0],2'h0},
                                                                                {r[3:0],b[3:0],2'h0,g[3:
                                                                                0],r[3:0],2'h0}
                                                                        0x7: {r[3:0],g[3:0],2'h0},
                                                                                {b[3:0],r[3:0],2'h0,g[3:
                                                                                0],b[3:0],2'h0}
                                                                        0x8: {b[3:0],r[3:0],2'h0},
                                                                                {g[3:0],b[3:0],2'h0,r[3:
                                                                                0],g[3:0],2'h0}
                                                                        0x9: {r[3:0],b[3:0],2'h0},
                                                                                {g[3:0],r[3:0],2'h0,b[3:
                                                                                0],g[3:0],2'h0}
                                                                        0xA: {g[3:0],b[3:0],2'h0},
                                                                                {r[3:0],g[3:0],2'h0,b[3:
                                                                                0],r[3:0],2'h0}
                                                                        0xB: {g[3:0],r[3:0],2'h0},
                                                                                {b[3:0],g[3:0],2'h0,r[3:
                                                                                0],b[3:0],2'h0}
                                                                        0xC~0xF: Not allowed

                                                     0xB~0xE: Not allowed
                                                     0xF: Bypass formatter module (not

                                                            recommended)
                                                            Bit[3:0]: Output format

                                                                        0x8: Raw
                                                                        0x9: YUV422
                                                                        0xA: YUV444
                                                                        0xE: VYYVYY.../UYYUYY
                                                                        0xF: UYYUYY.../VYYVYY

07.29.2011  PRODUCT SPECIFICATION                    proprietary to OmniVision Technologies

OV5640  color CMOS QSXGA (5 megapixel) image sensor with OmniBSITM technology

        table 6-5  format control registers (sheet 5 of 5)

        address register name                   default  R/W  description
                                                value
        0x4301     FORMAT CONTROL                        RW   Format Control 01
                   01                           0x00             Bit[1:0]: YUV422 UV control
                                                         RW                   00: U/V generated from average
        0x4302     YMAX VALUE                   0x03     RW                   01: U/V generated from first pixel
        0x4303     YMAX VALUE                   0xFF     RW                   10: Not valid
        0x4304     YMIN VALUE                   0x00     RW                   11: U/V generated from second pixel
        0x4305     YMIN VALUE                   0x00     RW
        0x4306     UMAX VALUE                   0x03     RW      Bit[1:0]: Y max clip value[9:8]
        0x4307     UMAX VALUE                   0xFF     RW
        0x4308     UMIN VALUE                   0x00     RW      Bit[7:0]: Y max clip value[7:0]
        0x4309     UMIN VALUE                   0x00     RW
        0x430A     VMAX VALUE                   0x03     RW      Bit[1:0]: Y min clip value[9:8]
        0x430B     VMAX VALUE                   0xFF     RW
        0x430C     VMIN VALUE                   0x00     RW      Bit[7:0]: Y min clip value[7:0]
        0x430D     VMIN VALUE                   0x00
                                                                 Bit[1:0]: U max clip value[9:8]

                                                                 Bit[7:0]: U max clip value[7:0]

                                                                 Bit[1:0]: U min clip value[9:8]

                                                                 Bit[7:0]: U min clip value[7:0]

                                                                 Bit[1:0]: V max clip value[9:8]

                                                                 Bit[7:0]: V max clip value[7:0]

                                                                 Bit[1:0]: V min clip value[9:8]

                                                                 Bit[7:0]: V min clip value[7:0]

        proprietary to OmniVision Technologies                PRODUCT SPECIFICATION  version 2.1

                                                                                                                                6-15

6.6 digital video port (DVP)

   6.6.1 overview

    The Digital Video Port (DVP) provides 10-bit parallel data output in all formats supported and extended features including
    compression mode, HSYNC mode, CCIR656 mode, and test pattern output. The DVP is also used to receive the video
    data from an external camera, which will be sent out through the OV5640 MIPI interface.

table 6-6   DVP control registers (sheet 1 of 3)
  address
                              default
   0x4709
   0x470A   register name     value               R/W  description
   0x470B
   0x4711   DVP VYSNC WIDTH0  0x02                RW   VSYNC Width Line Unit
   0x4712
            DVP VYSNC WIDTH1  0x00                RW   Bit[7:0]: VSYNC width PCLK
   0x4713                                                          unit[15:8]

   0x4715   DVP VYSNC WIDTH2  0x01                RW   Bit[7:0]: VSYNC width PCLK unit[7:0]
   0x4719
   0x471B   PAD LEFT CTRL     0x00                RW   HSYNC Mode Left Padding Pixel Counter
                                                       Add padding data at start of a line

            PAD RIGHT CTRL    0x00                RW   HSYNC Mode Right Padding Pixel
                                                       Counter
                                                       Add padding data at end of a line

                                                       Bit[2:0]:    JPEG mode select
                                                                    001: JPEG mode 1
            JPG MODE SELECT   0x02                RW                010: JPEG mode 2
                                                                    011: JPEG mode 3
                                                                    100: JPEG mode 4
                                                                    101: JPEG mode 5
                                                                    110: JPEG mode 6

                                                       Bit[3:0]:    CCIR656 dummy line
                                                                    number
            656 DUMMY LINE    0x00                RW                Control dummy line number
                                                                    at beginning of the frame
            CCIR656 CTRL
            HSYNC CTRL00      0x00                RW   Bit[1:0]: CCIR656 EAV/SAV option

                              0x02                RW   Bit[0]: HSYNC mode enable

07.29.2011  PRODUCT SPECIFICATION                      proprietary to OmniVision Technologies

OV5640  color CMOS QSXGA (5 megapixel) image sensor with OmniBSITM technology

        table 6-6  DVP control registers (sheet 2 of 3)
          address
                                                default
           0x471D
                   register name                value    R/W  description
           0x471F
           0x4721                                             Bit[1:0]:         vsync_mode
           0x4722                                                               00: VSYNC positive edge
           0x4723  DVP VSYNC CTRL               0x01     RW
                                                                                       trigger by end of field,
           0x4730                                                                      negative edge trigger by
                                                                                       start of frame
           0x4731                                                               01: VSYNC positive edge
           0x4732                                                                      trigger by end of frame,
           0x4733                                                                      the width define by
           0x4734                                                                      register
                                                                                10: VSYNC positive edge
                                                                                       trigger by start of field,
                                                                                       the width define by
                                                                                       register

                   DVP HREF CTRL                0x40     RW   HREF Minimum Blanking in JPEG
                                                              Mode23

                   VERTICAL START               0x00     RW   Bit[3:0]: Vertical start delay between
                   OFFSET                                                 video output and video input

                   VERTICAL END OFFSET          0x00     RW   Bit[3:0]: Vertical end delay between
                                                                          video output and video input

                   DVP CTRL23                   0x00     RW   DVP JPEG Mode456 Skip Line Number

                   CCIR656 CTRL00               0x00     RW   Bit[7]:           SYNC code selection
                                                                                0: Automatically generate
                                                              Bit[6]:
                                                              Bit[5]:                  SYNC code
                                                              Bit[4:3]:         1: SYNC code from

                                                              Bit[1]:                  register setting
                                                              Bit[0]:                  0x4732~4735
                                                                                f value in CCIR656 SYNC
                                                                                code when fixed f value
                                                                                Fixed f value
                                                                                Blank toggle data options
                                                                                00: Toggle data is
                                                                                       1'h040/1'h200
                                                                                01: Use register setting
                                                                                       0x4736~0x4738
                                                                                10: Blanking data always
                                                                                       keep 0
                                                                                Clip data disable
                                                                                CCIR656 mode enable

                   CCIR656 CTRL01               0x00     RW   Bit[0]:           Blanking toggle data order
                                                                                option
                   CCIR656 FS
                   CCIR656 FE                   0x01     RW   CCIR656 Sync Code Frame Start
                   CCIR656 LS
                                                0x0F     RW   CCIR656 Sync Code Frame End

                                                0x00     RW   CCIR6656 Sync Code Line Start

        proprietary to OmniVision Technologies           PRODUCT SPECIFICATION               version 2.1

                                                                                                6-17

table 6-6   DVP control registers (sheet 3 of 3)
  address
                             default
   0x4735
   0x4736   register name    value                R/W  description
   0x4737
   0x4738   CCIR656 LE       0x00                 RW   CCIR656 Sync Code line End

   0x4740   CCIR656 CTRL6    0x00                 RW   Bit[3:2]: Toggle data0[9:8]
                                                       Bit[1:0]: Toggle data1[9:8]
   0x4741
            CCIR656 CTRL7    0x00                 RW   Bit[7:0]: Toggle data0[7:0]
   0x4745   CCIR656 CTRL8
                             0x00                 RW   Bit[7:0]: Toggle data1[7:0]

            POLARITY CTRL00  0x20                 RW   Bit[5]:      PCLK polarity
                                                                    0: Active low
                                                       Bit[3]:      1: Active high
                                                       Bit[2]:      Gate PCLK under VSYNC
                                                       Bit[1]:      Gate PCLK under HREF
                                                                    HREF polarity
                                                       Bit[0]:      0: Active low
                                                                    1: Active high
                                                                    VSYNC polarity
                                                                    0: Active low
                                                                    1: Active high

            TEST PATTERN     0x00                 RW   Bit[2]:      Test pattern enable
                                                       Bit[1]:      Test pattern select
                                                                    0: Output test pattern 0
                                                       Bit[0]:      1: Output test pattern 1
                                                                    Test pattern 8-bit/10-bit
                                                                    0: 10-bit test pattern
                                                                    1: 8-bit test pattern

            DATA ORDER       0x00                 RW   Bit[2:1]:    DVP order option for debug
                                                       Bit[0]:      00: D[9:0]
                                                                    10: {D[7:0], D[9:8]}
                                                                    x1: {D[1:0], D[9:2]}
                                                                    Output data order
                                                                    0: Normal output
                                                                    1: Reverse output data bit

                                                                           order

07.29.2011  PRODUCT SPECIFICATION                      proprietary to OmniVision Technologies

OV5640                  color CMOS QSXGA (5 megapixel) image sensor with OmniBSITM technology

                        6.6.2 DVP timing

                        figure 6-7 DVP timing diagram

                        VSYNC                                                         (1)
                                                                  (4)
                                     (2)                (3)                                    (5)

                                                                       (7)                                                                   5640_DS_6_7

                        HREF

                                                                  (6)

                                                             (8)       (9)

                        HSYNC

                        D[9:0]            invalid data

                        table 6-7    DVP timing specifications (sheet 1 of 2)

note                    mode                                           timing

Timing values shown in  5 megapixel                                    (1) 5596992 tp
table 6-7 may vary      2592x1944                                      (2) 5688 tp
depending upon                                                         (3) 48276 tp
register settings.      1080p                                          (4) 2844 tp
                        1920x1080                                      (5) 14544 tp
                                                                       (6) 2592 tp
                        UXGA                                           (7) 252 tp
                        1600x1200                                      (8) 0 tp
                                                                       (9) 252 tp

                                                                       (1) 5596992 tp
                                                                       (2) 5688 tp
                                                                       (3) 2506164 tp
                                                                       (4) 2844 tp
                                                                       (5) 14544 tp
                                                                       (6) 1920 tp
                                                                       (7) 924 tp
                                                                       (8) 0 tp
                                                                       (9) 924 tp

                                                                       (1) 5596992 tp
                                                                       (2) 5688 tp
                                                                       (3) 2165204 tp
                                                                       (4) 2844 tp
                                                                       (5) 14544 tp
                                                                       (6) 1600 tp
                                                                       (7) 1244 tp
                                                                       (8) 0 tp
                                                                       (9) 1244 tp

                        proprietary to OmniVision Technologies         PRODUCT SPECIFICATION   version 2.1

                                                                                                           6-19

table 6-7     DVP timing specifications (sheet 2 of 2)
   mode
                                               timing
    720p
    1280x720                                       (1) 5596992 tp
                                                   (2) 5688 tp
    XGA                                            (3) 3530644 tp
    1024x768                                       (4) 2844 tp
                                                   (5) 14544 tp
    VGA                                            (6) 1280 tp
    640x480                                        (7) 1564 tp
                                                   (8) 0 tp
                                                   (9) 1564 tp

                                                   (1) 5596992 tp
                                                   (2) 5688tp
                                                   (3) 2825588 tp
                                                   (4) 2844 tp
                                                   (5) 583344tp
                                                   (6) 024 tp
                                                   (7) 1820 tp
                                                   (8) 0 tp
                                                   (9) 1820 tp

                                                   (1) 5596992 tp
                                                   (2) 5688 tp
                                                   (3) 4213844 tp
                                                   (4) 2844 tp
                                                   (5) 14544 tp
                                                   (6) 640 tp
                                                   (7) 2204 tp
                                                   (8) 0 tp
                                                   (9) 2204 tp

07.29.2011    PRODUCT SPECIFICATION                                proprietary to OmniVision Technologies

OV5640  color CMOS QSXGA (5 megapixel) image sensor with OmniBSITM technology

        6.7 mobile industry processor interface (MIPI)

            The OV5640 provides one clock lane and two data lanes for the communications link between sensor (transmitter) and
            receiver inside a mobile device. It follows MIPI specifications D-PHY 0.89 and above and CSI2-V1, and supports all
            mandatory MIPI features. Most of the optional features (e.g., LP transfer mode) are not supported unless otherwise
            specified in this specification. For any further questions, contact your local OmniVision FAE for more details.

        table 6-8  MIPI transmitter registers (sheet 1 of 3)

        address register name  default          R/W  description
                               value
        0x4800 MIPI CTRL 00                     RW   MIPI Control 00
        0x4801 MIPI CTRL 01    0x04             RW      Bit[5]: Clock lane gate enable
        0x4805 MIPI CTRL 05                     RW                   0: Clock lane is free running
                               0x04                                  1: Gate clock lane when no packet to
                               0x10                                         transmit
                                                        Bit[4]: Line sync enable
                                                                     0: Do not send line short packet for each
                                                                            line
                                                                     1: Send line short packet for each line
                                                        Bit[3]: Lane select
                                                                     0: Use lane1 as default data lane
                                                                     1: Use lane2 as default data lane
                                                        Bit[2]: Idle status
                                                                     0: MIPI bus will be LP00 when no packet to
                                                                            transmit
                                                                     1: MIPI bus will be LP11 when no packet to
                                                                            transmit

                                                     MIPI Control 01
                                                        Bit[4]: PH bit order for ECC
                                                                     0: {DI[7:0],WC[7:0],WC[15:8]}
                                                                     1: {DI[0:7],WC[0:7],WC[8:15]}
                                                        Bit[3]: PH byte order for ECC
                                                                     0: {DI,WC_l,WC_h}
                                                                     1: {DI,WC_h,WC_l}
                                                        Bit[2]: PH byte order2 for ECC
                                                                     0: {DI,WC}
                                                                     1: {WC,DI}

                                                     Bit[7]:      MIPI lane1 disable
                                                     Bit[6]:      1: Disable MIPI data lane1
                                                     Bit[5]:      Lane1 will be LP00
                                                                  MIPI lane1 disable
                                                                  1: Disable MIPI data lane1
                                                                  Lane1 will be LP00
                                                                  LPX Global timing select
                                                                  0: Auto calculate t_lpx_o in pclk2x domain,

                                                                         unit clk2x
                                                                  1: Use lp_p_min[7:0]

        proprietary to OmniVision Technologies       PRODUCT SPECIFICATION                          version 2.1

                                                                                                           6-21

table 6-8   MIPI transmitter registers (sheet 2 of 3)

address register name       default  R/W      description
                            value
0x480A      MIPI DATA                RW       Bit[2]:      Bit order reverse
            ORDER           0x00              Bit[1:0]:    Bit position adjust
                                     RW                    01: {data[7:0],data[9:8]}
                            0x00     RW                    10: {data[1:0],data[9:2]}
                            0x96     RW
0x4818 MIN HS ZERO H        0x00     RW       High Byte of Minimum Value of hs_zero
                            0x3C              Unit ns

0x4819      MIN HS ZERO L                     Low Byte of Minimum Value of hs_zero
0x481A                                        hs_zero_real = hs_zero_min_o + Tui*ui_hs_zero_min_o
0x481B      MIN MIPI HS
0x481C      TRAIL H                           High Byte of Minimum Value of hs_trail
0x481D                                        Unit ns
0x481E      MIN MIPI HS
0x481F      TRAIL L                           Low Byte of Minimum Value of hs_trail
                                              hs_trail_real = hs_trail_min_o + Tui*ui_hs_trail_min_o
            MIN MIPI CLK
            ZERO H          0x01     RW High Byte of Minimum Value of clk_zero

            MIN MIPI CLK    0x86     RW Low Byte of Minimum Value of clk_zero
            ZERO L          0x00                clk_zero_real = clk_zero_min_o + Tui*ui_clk_zero_min_o
                            0x3C
            MIN MIPI CLK    0x00     RW High Byte of Minimum Value of clk_prepare
            PREPARE H       0x56                Unit ns
                            0x00
            MIN MIPI CLK    0x3C                Low Byte of Minimum Value of clk_prepare
            PREPARE L       0x00     RW clk_prepare_real = clk_prepare_min_o +
                            0x32
0x4820 MIN CLK POST H       0x00                Tui*ui_clk_prepare_min_o
                            0x32
0x4821 MIN CLK POST L                RW High Byte of Minimum Value of clk_post
                                                Unit ns
0x4822 MIN CLK TRAIL H
                                     RW Low Byte of Minimum Value of clk_post
0x4823 MIN CLK TRAIL L                          clk_post_real = clk_post_min_o + Tui*ui_clk_post_min_o

0x4824 MIN LPX PCLK H                RW High Byte of Minimum Value of clk_trail
                                                Unit ns
0x4825      MIN LPX PCLK L
0x4826                               RW Low Byte of Minimum Value of clk_trail
0x4827      MIN HS                              clk_trail_real = clk_trail_min_o + Tui*ui_clk_trail_min_o
            PREPARE H
                                     RW High Byte of Minimum Value of lpx_p
            MIN HS                              Unit ns
            PREPARE L
                                     RW Low Byte of Minimum Value of lpx_p
                                                lpx_p_real = lpx_p_min_o + Tui*ui_lpx_p_min_o

                                     RW High Byte of Minimum Value of hs_prepare
                                                Unit ns

                                                Low Byte of Minimum Value of hs_prepare
                                     RW hs_prepare_real = hs_prepare_min_o +

                                                Tui*ui_hs_prepare_min_o

07.29.2011             PRODUCT SPECIFICATION               proprietary to OmniVision Technologies

OV5640  color CMOS QSXGA (5 megapixel) image sensor with OmniBSITM technology

        table 6-8  MIPI transmitter registers (sheet 3 of 3)

        address    register name     default    R/W  description
                                     value
        0x4828     MIN HS EXIT H                RW   High Byte of Minimum Value of hs_exit
        0x4829                       0x00       RW   Unit ns
        0x482A     MIN HS EXIT L     0x64       RW
        0x482B                       0x05       RW   Low Byte of Minimum Value of hs_exit
        0x482C     MIN HS ZERO/UI    0x04       RW   hs_exit_real = hs_exit_min_o + Tui*ui_hs_exit_min_o
        0x482D                       0x00       RW
        0x482E     MIN HS TRAIL/UI   0x00       RW   Minimum UI Value of hs_zero
        0x482F                       0x34       RW   Unit UI
        0x4830     MIN CLK ZERO/UI   0x00       RW
        0x4831     MIN CLK           0x00       RW   Minimum UI Value of hs_trail
        0x4832     PREPARE/UI        0x04       RW   Unit UI
        0x4837     MIN CLK POST/UI   0x00       RW
                                     0x10            Minimum UI Value of clk_zero
                   MIN CLK TRAIL/UI                  Unit UI

                   MIN LPX PCLK/UI                   Minimum UI Value of clk_prepare
                   MIN HS                            Unit UI
                   PREPARE/UI
                   MIN HS EXIT/UI                    Minimum UI Value of clk_post
                   PCLK PERIOD                       Unit UI

                                                     Minimum UI Value of clk_trail
                                                     Unit UI

                                                     Minimum UI Value of lpx_p(pclk2x domain)
                                                     Unit UI

                                                     Minimum UI Value of hs_prepare
                                                     Unit UI

                                                     Minimum UI Value of hs_exit
                                                     Unit UI

                                                     Period of pixel clock, pclk_div=1, and 1-bit decimal

        proprietary to OmniVision Technologies       PRODUCT SPECIFICATION     version 2.1

                                                                                                                          7-1

7 register tables

    The following tables provide descriptions of the device control registers contained in the OV5640. For all registers
    enable/disable bits, ENABLE = 1 and DISABLE = 0.

7.1 system and IO pad control [0x3000 ~ 0x3052]

table 7-1   system and IO pad control registers (sheet 1 of 7)
  address
            register name   default  R/W  description
  0x3000                    value
            SYSTEM RESET00           RW   Reset for Individual Block
  0x3001    SYSTEM RESET01  0x30     RW   (0: enable block; 1: reset block)
            SYSTEM RESET02           RW
  0x3002                    0x08             Bit[7]: Reset BIST
                                             Bit[6]: Reset MCU program memory
                            0x1C             Bit[5]: Reset MCU
                                             Bit[4]: Reset OTP
                                             Bit[3]: Reset STB
                                             Bit[2]: Reset d5060
                                             Bit[1]: Reset timing control
                                             Bit[0]: Reset array control

                                          Reset for Individual Block
                                          (0: enable block; 1: reset block)

                                             Bit[7]: Reset AWB registers
                                             Bit[6]: Reset AFC
                                             Bit[5]: Reset ISP
                                             Bit[4]: Reset FC
                                             Bit[3]: Reset S2P
                                             Bit[2]: Reset BLC
                                             Bit[1]: Reset AEC registers
                                             Bit[0]: Reset AEC

                                          Reset for Individual Block
                                          (0: enable block; 1: reset block)

                                             Bit[7]: Reset VFIFO
                                             Bit[6]: Debug mode
                                             Bit[5]: Reset format
                                             Bit[4]: Reset JFIFO
                                             Bit[3]: Reset SFIFO
                                             Bit[2]: Reset JPG
                                             Bit[1]: Reset format MUX
                                             Bit[0]: Reset average

07.29.2011  PRODUCT SPECIFICATION         proprietary to OmniVision Technologies

OV5640  color CMOS QSXGA (5 megapixel) image sensor with OmniBSITM technology

        table 7-1  system and IO pad control registers (sheet 2 of 7)
          address
                   register name                default  R/W  description
          0x3003                                value
                   SYSTEM RESET03                        RW   Reset for Individual Block
          0x3004   CLOCK ENABLE00               0x00     RW   (0: enable block; 1: reset block)
                   CLOCK ENABLE01                        RW
          0x3005   CLOCK ENABLE02               0xCF     RW      Bit[7:6]: Debug mode
                                                                 Bit[5]: Reset digital gain compensation
          0x3006                                0xF7             Bit[4]: Reset SYNC FIFO
                                                                 Bit[3]: Reset PSRAM
                                                0xE3             Bit[2]: Reset ISP FC
                                                                 Bit[1]: Reset MIPI
                                                                 Bit[0]: Reset DVP

                                                              Clock Enable Control
                                                              (0: disable clock; 1: enable clock)

                                                                 Bit[7]: Enable BIST clock
                                                                 Bit[6]: Enable MCU program memory

                                                                              clock
                                                                 Bit[5]: Enable MCU clock
                                                                 Bit[4]: Enable OTP clock
                                                                 Bit[3]: Enable STROBE clock
                                                                 Bit[2]: Enable D5060 clock
                                                                 Bit[1]: Enable timing control clock
                                                                 Bit[0]: Enable array control clock

                                                              Clock Enable Control
                                                              (0: disable clock; 1: enable clock)

                                                                 Bit[7]: Enable AWB register clock
                                                                 Bit[6]: Enable AFC clock
                                                                 Bit[5]: Enable ISP clock
                                                                 Bit[4]: Enable FC clock
                                                                 Bit[3]: Enable S2P clock
                                                                 Bit[2]: Enable BLC clock
                                                                 Bit[1]: Enable AEC register clock
                                                                 Bit[0]: Enable AEC clock

                                                              Clock Enable Control
                                                              (0: disable clock; 1: enable clock)

                                                                 Bit[7]: Enable PSRAM clock
                                                                 Bit[6]: Enable FMT clock
                                                                 Bit[5]: Enable JPEG 2x clock
                                                                 Bit[3]: Enable JPEG clock
                                                                 Bit[2]: Debug mode
                                                                 Bit[1]: Enable format MUX clock
                                                                 Bit[0]: Enable average clock

        proprietary to OmniVision Technologies           PRODUCT SPECIFICATION  version 2.1

                                                                                                    7-3

table 7-1   system and IO pad control registers (sheet 3 of 7)
  address
            register name         default  R/W  description
  0x3007                          value
            CLOCK ENABLE03                 RW   Clock Enable Control
  0x3008                          0xFF          (0: disable clock; 1: enable clock)
  0x3009    SYSTEM CTRL0                   RW
  0x300A    DEBUG MODE            0x02     -       Bit[7]: Enable digital gain
  0x300B    CHIP ID HIGH BYTE     -        R                    compensation clock
  0x300C~   CHIP ID LOW BYTE      0x56     R
  0x300D                          0x40             Bit[6]: Enable SYNC FIFO clock
                                                   Bit[5]: Enable ISPFC SCLK clock
  0x300E                                           Bit[4]: Enable MIPI PCLK clock
                                                   Bit[3]: Enable MIPI clock
  0x300F~                                          Bit[2]: Enable DVP PCLK clock
  0x3015                                           Bit[1]: Enable VFIFO PCLK clock
  0x3016                                           Bit[0]: Enable VFIFO SCLK clock

                                                System Control
                                                   Bit[7]: Software reset
                                                   Bit[6]: Software power down
                                                   Bit[5:0]: Debug mode

                                                Debug Mode

                                                Chip ID High Byte

                                                Chip ID Low Byte

            DEBUG MODE            -        -    Debug Mode

            MIPI CONTROL 00       0x58                  MIPI Control 00
                                                           Bit[7:5]: mipi_lane_mode
                                                                        001: One lane mode
                                                                        010: Two lane mode
                                                                        Others: Debug mode
                                                           Bit[4]: MIPI TX PHY power down
                                                                        0: Debug mode

                                           RW 1: Power down PHY HS TX
                                                           Bit[3]: MIPI RX PHY power down
                                                                        0: Debug mode
                                                                        1: Power down PHY LP RX
                                                                               module
                                                           Bit[2]: mipi_en
                                                                        0: DVP enable
                                                                        1: MIPI enable
                                                           Bit[1:0]: Debug mode

            DEBUG MODE            -        -    Debug Mode

            PAD OUTPUT ENABLE 00  0x00                  Input/Output Control (0: input; 1: output)
                                           RW Bit[7:2]: Debug mode

                                                           Bit[1]: Strobe output enable
                                                           Bit[0]: SIOD output enable

07.29.2011  PRODUCT SPECIFICATION               proprietary to OmniVision Technologies

OV5640  color CMOS QSXGA (5 megapixel) image sensor with OmniBSITM technology

        table 7-1  system and IO pad control registers (sheet 4 of 7)
          address
                   register name                default  R/W  description
          0x3017                                value
          0x3018   PAD OUTPUT ENABLE 01                  RW   Input/Output Control (0: input; 1: output)
                   PAD OUTPUT ENABLE 02         0x00     RW      Bit[7]: FREX output enable
          0x3019                                0x00             Bit[6]: VSYNC output enable
                   PAD OUTPUT VALUE 00                   RW      Bit[5]: HREF output enable
          0x301A                                0x00             Bit[4]: PCLK output enable
          0x301B   PAD OUTPUT VALUE 01                   RW      Bit[3:0]: D[9:6] output enable
          0x301C   PAD OUTPUT VALUE 02          0x00     RW
          0x301D   PAD SELECT 00                0x00     RW   Input/Output Control (0: input; 1: output)
                   PAD SELECT 01                0x00     RW      Bit[7:2]: D[5:0] output enable
                                                0x00             Bit[1]: GPIO1 output enable
                                                                 Bit[0]: GPIO0 output enable

                                                              PAD Output Value
                                                                 Bit[7]: MIPI data lane option
                                                                              Bypass latch in MIPI PHY
                                                                 Bit[6]: MIPI lane2 state in sleep mode
                                                                              0: LP00
                                                                              1: LP11
                                                                 Bit[5]: MIPI lane1 state in sleep mode
                                                                              0: LP00
                                                                              1: LP11
                                                                 Bit[4]: MIPI CLK lane state in sleep
                                                                              mode
                                                                              0: LP00
                                                                              1: LP11
                                                                 Bit[3:2]: Debug mode
                                                                 Bit[1]: Strobe
                                                                 Bit[0]: SIOD

                                                              GPIO Output Value 01
                                                                 Bit[7]: FREX
                                                                 Bit[6]: VSYNC
                                                                 Bit[5]: HREF
                                                                 Bit[4]: PCLK
                                                                 Bit[3:0]: D[9:6]

                                                              GPIO Output Value 02
                                                                 Bit[7:2]: D[5:0]
                                                                 Bit[1]: GPIO1
                                                                 Bit[0]: GPIO0

                                                              Output Selection for GPIO
                                                                 Bit[7:2]: Debug mode
                                                                 Bit[1]: IO strobe select
                                                                 Bit[0]: IO SIOD select

                                                              Output Selection for GPIO
                                                                 Bit[7]: FREX select
                                                                 Bit[6]: VSYNC select
                                                                 Bit[5]: HREF select
                                                                 Bit[4]: PCLK select
                                                                 Bit[3:0]: IO D[9:6] select

        proprietary to OmniVision Technologies           PRODUCT SPECIFICATION  version 2.1

                                                                                         7-5

table 7-1   system and IO pad control registers (sheet 5 of 7)
  address
            register name   default  R/W  description
  0x301E                    value
  0x301F    PAD SELECT 02            RW   Output Selection for GPIO
  0x302A    DEBUG MODE      0x00     -       Bit[7:2]: IO D[5:0] select
  0x302B    CHIP REVISION   -        R       Bit[1]: IO GPIO1 select
            DEBUG MODE      0xB0     -       Bit[0]: IO GPIO0 select
  0x302C                    -
            PAD CONTROL 00           RW   Debug Mode
  0x302D~                   0x02
  0x3030    SYSTEM CONTROL           RW   Bit[7:4]:             Process
  0x3031    SC PWC          -        RW   Bit[3:0]:             0xA: FSI
  0x3032~   SYSTEM CONTROL  0x00     RW                         0xB: BSI
  0x3033    SC PLL CONTRL0  -        RW                         Chip revision
  0x3034                    0x1A
            SC PLL CONTRL1           RW   Debug Mode
  0x3035                    0x11
                                          Pad Control
                                             Bit[7:6]: Output drive capability
                                                          00: 1x
                                                          01: 2x
                                                          10: 3x
                                                          11: 4x
                                             Bit[5:2]: Debug mode
                                                          Changing this value is not
                                                          allowed
                                             Bit[1]: FREX enable
                                             Bit[0]: Debug mode
                                                          Changing this value is not
                                                          allowed

                                          System Control Registers
                                          Changing these values is not recommended

                                          PWC Control
                                             Bit[7:4]: Debug mode
                                             Bit[3]: Bypass regulator
                                             Bit[2:0]: Debug mode

                                          System Control Registers
                                          Changing these values is not recommended

                                          Bit[7]:               Debug mode
                                          Bit[6:4]:             PLL charge pump control
                                          Bit[3:0]:             MIPI bit mode
                                                                0x8: 8-bit mode
                                                                0xA: 10-bit mode
                                                                Others: Debug mode

                                          Bit[7:4]:             System clock divider
                                          Bit[3:0]:             Slow down all clocks
                                                                Scale divider for MIPI
                                                                MIPI PCLK/SERCLK can be
                                                                slowed down

07.29.2011  PRODUCT SPECIFICATION         proprietary to OmniVision Technologies

OV5640  color CMOS QSXGA (5 megapixel) image sensor with OmniBSITM technology

        table 7-1  system and IO pad control registers (sheet 6 of 7)
          address
                   register name                default  R/W  description
          0x3036                                value
                   SC PLL CONTRL2                        RW   Bit[7:0]:    PLL multiplier (4~252)
          0x3037   SC PLL CONTRL3               0x69     RW                Can be any integer from 4~127
          0x3038   SYSTEM CONTROL                        RW                and only even integers from
          0x3039   SC PLL CONTRL 5              0x03     RW                128~252
          0X303A   SC PLLS CTRL0                -        RW
          0x303B   SC PLLS CTRL1                0x00     RW   Bit[7:5]:    Debug mode
          0x303C   SC PLLS CTRL2                0x00     RW   Bit[4]:      PLL root divider
                                                0x19                       0: Bypass
          0x303D   SC PLLS CTRL3                0x11     RW   Bit[3:0]:    1: Divided by 2
                                                                           PLL pre-divider
          0x303E~  SYSTEM CONTROL               0x30     RW                1,2,3,4,6,8
          0x304F
                                                -             System Control Registers
                                                              Changing these values is not recommended

                                                              Bit[7]: PLL bypass
                                                              Bit[6:0]: Debug mode

                                                              Bit[7]: PLLS bypass
                                                              Bit[6:0]: Debug mode

                                                              Bit[7:5]: Debug mode
                                                              Bit[4:0]: PLLS multiplier

                                                              Bit[7]:      Debug mode
                                                              Bit[6:4]:    PLLS charge pump control
                                                              Bit[3:0]:    PLLS system divider

                                                              Bit[7:6]:    Debug mode
                                                              Bit[5:4]:    PLLS pre-divider
                                                                           00: /1
                                                              Bit[3]:      01: /1.5
                                                              Bit[2]:      10: /2
                                                                           11: /3
                                                              Bit[1:0]:    Debug mode
                                                                           PLLS root divider
                                                                           0: /1
                                                                           1: /2
                                                                           PLLS seld5
                                                                           00: /1
                                                                           01: /1
                                                                           10: /2
                                                                           11: /2.5

                                                              System Control Registers
                                                              Changing these values is not recommended

        proprietary to OmniVision Technologies           PRODUCT SPECIFICATION                version 2.1

                                                                                                7-7

table 7-1   system and IO pad control registers (sheet 7 of 7)
  address
            register name      default       R/W        description
  0x3050                       value
            IO PAD VALUE                     R          Read Pad Value
  0x3051                       -                           Bit[7:5]: Debug mode
  0x3052    IO PAD VALUE                     R             Bit[4]: FREX
            IO PAD VALUE       -             R             Bit[3]: PWDN
                                                           Bit[2]: Debug mode
                               -                           Bit[1]: SIOC
                                                           Bit[0]: Debug mode

                                                        Read Pad Value
                                                           Bit[7]: OTP memory out
                                                           Bit[6]: VSYNC
                                                           Bit[5]: HREF
                                                           Bit[4]: PCLK
                                                           Bit[3:0]: D[9:6]

                                                        Pad Input Status
                                                           Bit[7:2]: D[5:0]
                                                           Bit[1]: GPIO1
                                                           Bit[0]: GPIO0

7.2 SCCB control [0x3100 ~ 0x3108]

table 7-2   SCCB control registers (sheet 1 of 2)
  address
                                    default
   0x3100
   0x3101   register name           value          R/W  description

   0x3102   SCCB_ID                 0x78           RW   SCCB Slave ID

            SCCB SYSTEM CTRL0       -              RW   SCCB Control Registers
                                                        Changing these values is not allowed

            SCCB SYSTEM CTRL0       0x00           RW   Bit[7]:      Debug mode
                                                        Bit[6]:      MIPI SC reset
                                                        Bit[5]:      SRB reset
                                                        Bit[4]:      SCCB slave reset
                                                        Bit[3]:      rst_pon_sccb
                                                        Bit[2]:      Debug mode
                                                        Bit[1]:      MIPI PHY reset
                                                        Bit[0]:      PLL reset

07.29.2011  PRODUCT SPECIFICATION                       proprietary to OmniVision Technologies

OV5640  color CMOS QSXGA (5 megapixel) image sensor with OmniBSITM technology

        table 7-2   SCCB control registers (sheet 2 of 2)
          address
                                                         default
           0x3103
           0x3104~  register name                        value    R/W  description
           0x3107
                    SCCB SYSTEM CTRL1                    0x00     RW   PLL Clock Select
           0x3108                                                         Bit[7:2]: Debug mode
                    SCCB SYSTEM CTRL0                    -        RW                   Changing this value is not
                                                                                       allowed
                    SYSTEM ROOT DIVIDER                  0x16     RW      Bit[1]: Select system input clock
                                                                                       0: From pad clock
                                                                                       1: From PLL
                                                                          Bit[0]: Debug mode
                                                                                       Changing this value is not
                                                                                       allowed

                                                                       SCCB Control Registers
                                                                       Changing these values is not allowed

                                                                       Pad Clock Divider for SCCB Clock
                                                                          Bit[7:6]: Debug mode
                                                                          Bit[5:4]: PCLK root divider
                                                                                       00: PCLK = pll_clki
                                                                                       01: PCLK = pll_clki/2
                                                                                       10: PCLK = pll_clki/4
                                                                                       11: PCLK = pll_clki/8
                                                                          Bit[3:2]: sclk2x root divider
                                                                                       00: SCLK2x = pll_clki
                                                                                       01: SCLK2x = pll_clki/2
                                                                                       10: SCLK2x= pll_clki/4
                                                                                       11: SCLK2x= pll_clki/8
                                                                          Bit[1:0]: SCLK root divider
                                                                                       00: SCLK = pll_clki
                                                                                       01: SCLK = pll_clki/2
                                                                                       10: SCLK= pll_clki/4
                                                                                       11: sclk= pll_clki/8

        7.3 SRB control [0x3200 ~ 0x3211]

        table 7-3   SRB control registers (sheet 1 of 2)

          address   register name               default     R/W   description
                                                value
          0x3200    GROUP ADDR0                             RW    SRAM Group Address0
          0x3201    GROUP ADDR1                 0x40        RW    SRAM Group Address1
          0x3202    GROUP ADDR2                 0x4A        RW    SRAM Group Address2
          0x3203    GROUP ADDR3                 0x54        RW    SRAM Group Address3
                                                0x5E

        proprietary to OmniVision Technologies              PRODUCT SPECIFICATION      version 2.1

                                                                                                     7-9

table 7-3   SRB control registers (sheet 2 of 2)
  address
            register name      default  R/W       description
  0x3204~                      value
  0x3211    GROUP WRITE                 RW        Group Write Registers
            CONTROL REGISTERS  -                  Changing these values is not recommended
  0x3212
            SRM GROUP ACCESS -          W         SRM Group Access
  0x3213                                             Bit[7]: Group launch enable
            SRM GROUP STATUS -          R            Bit[6]: Test mode access group
                                                     Bit[5]: Group launch
                                                     Bit[4]: Group hold end
                                                     Bit[3:0]: Group ID
                                                                  00xx: Group ID
                                                                  01xx: Reserved
                                                                  1xxx: Reserved

                                                  SRM Group Status
                                                     Bit[7]: Store
                                                     Bit[6]: Restore
                                                     Bit[5]: Group hold
                                                     Bit[4]: Group launch
                                                     Bit[3]: Group write
                                                     Bit[2:0]: Group select

7.4 AWB gain control [0x3400 ~ 0x3406]

table 7-4   AWB gain control registers

  address   register name      default  R/W       description
                               value
  0x3400    AWB R GAIN                  RW        Bit[3:0]: AWB R gain[11:8]
  0x3401    AWB R GAIN         0x04     RW
  0x3402    AWB G GAIN         0x00     RW        Bit[7:0]: AWB R gain[7:0]
  0x3403    AWB G GAIN         0x04     RW
  0x3404    AWB B GAIN         0x00     RW        Bit[3:0]: AWB G gain[11:8]
  0x3405    AWB B GAIN         0x04     RW
                               0x00               Bit[7:0]: AWB G gain[7:0]

                                                  Bit[3:0]: AWB B gain[11:8]

                                                  Bit[7:0]: AWB B gain[7:0]

0x3406      AWB MANUAL         0x00     RW        Bit[7:1]:    Debug mode
            CONTROL                               Bit[0]:      AWB gain manual enable
                                                               0: Auto
                                                               1: Manual

07.29.2011  PRODUCT SPECIFICATION                            proprietary to OmniVision Technologies

OV5640  color CMOS QSXGA (5 megapixel) image sensor with OmniBSITM technology

        7.5 AEC/AGC control [0x3500 ~ 0x350D]

        table 7-5  AEC/AGC control registers
          address
                   register name                default  R/W  description
                                                value
                                                         RW   Exposure Output
        0x3500     AEC PK EXPOSURE              0x00     RW      Bit[7:4]: Debug mode
                                                         RW      Bit[3:0]: Exposure [19:16]
        0x3501     AEC PK EXPOSURE              0x02
                                                         RW   Exposure Output
        0x3502     AEC PK EXPOSURE              0x00             Bit[7:0]: Exposure [15:8]
                                                         RW
        0x3503     AEC PK MANUAL                0x00     RW   Exposure Output
                                                         RW      Bit[7:0]: Exposure [7:0]
        0x350A     AEC PK REAL GAIN             0x00     RW                   Lower four bits are a fraction of a
                                                0x10                          line; they should be 0 since
        0x350B     AEC PK REAL GAIN             0x00                          OV5640 does not support
        0x350C     AEC PK VTS                   0x00                          fraction line exposure
        0x350D     AEC PK VTS
                                                              AEC Manual Mode Control
                                                                 Bit[7:2]: Debug mode
                                                                 Bit[1]: AGC manual
                                                                              0: Auto enable
                                                                              1: Manual enable
                                                                 Bit[0]: AEC manual
                                                                              0: Auto enable
                                                                              1: Manual enable

                                                              Real Gain
                                                                 Bit[7:2]: Debug mode
                                                                 Bit[1:0]: Real gain[9:8]

                                                              Real Gain
                                                                 Bit[7:0]: Real gain[7:0]

                                                              AEC VTS Output
                                                                 Bit[7:0]: VTS[15:8]

                                                              AEC VTS Output
                                                                 Bit[7:0]: VTS[7:0]

        proprietary to OmniVision Technologies           PRODUCT SPECIFICATION  version 2.1

                                                                                              7-11

7.6 VCM control [0x3600 ~ 0x3606]

table 7-6   VCM control registers

  address   register name          default   R/W     description
                                   value
  0x3600~                                    -       Debug Mode
  0x3601    DEBUG MODE             -         RW
                                                     VCM Control
0x3602      VCM CONTROL 0          0x50      RW         Bit[7:4]: VCM target value[3:0]
                                             RW         Bit[3]: Slew rate control s3
0x3603      VCM CONTROL 1          0x01      RW         Bit[2:0]: Slew rate control s2,s1,s0
                                   0x05      RW
0x3604      VCM CONTROL 2          0x46              VCM Control
                                   0x00                 Bit[7]: PWDN VCM
0x3605      VCM CONTROL 3                               Bit[6]: Debug mode
                                                        Bit[5:0]: VCM target value[9:4]
0x3606      VCM CONTROL 4
                                                     VCM Control
                                                        Bit[7:0]: vcm_rdiv[7:0]

                                                     VCM Control
                                                        Bit[7:5]: Debug mode
                                                        Bit[4]: VCM RIH
                                                        Bit[3:0]: vcm_rdiv[11:8]

                                                     VCM Control
                                                        Bit[7:3]: Debug mode
                                                        Bit[2:0]: ib_vcm

7.7 timing control [0x3800 ~ 0x3821]

table 7-7   timing control registers (sheet 1 of 3)

  address   register name  default                   description
                           value R/W
  0x3800    TIMING HS                                   Bit[7:4]: Debug mode
  0x3801    TIMING HS      0x00          RW             Bit[3:0]: X address start[11:8]
  0x3802    TIMING VS
  0x3803    TIMING VS      0x00          RW             Bit[7:0]: X address start[7:0]
  0x3804    TIMING HW
                           0x00          RW             Bit[7:4]: Debug mode
                                                        Bit[3:0]: Y address start[11:8]
                           0x00          RW
                                                        Bit[7:0]: Y address start[7:0]
                           0x0A          RW
                                                        Bit[7:4]: Debug mode
                                                        Bit[3:0]: X address end[11:8]

07.29.2011  PRODUCT SPECIFICATION                    proprietary to OmniVision Technologies

OV5640  color CMOS QSXGA (5 megapixel) image sensor with OmniBSITM technology

        table 7-7  timing control registers (sheet 2 of 3)

          address  register name                default     description
                                                value R/W
          0x3805   TIMING HW                                   Bit[7:0]: X address end[7:0]
          0x3806   TIMING VH                    0x3F  RW
          0x3807   TIMING VH                                   Bit[7:3]: Debug mode
          0x3808   TIMING DVPHO                 0x07  RW       Bit[2:0]: Y address end[10:8]
          0x3809   TIMING DVPHO
          0x380A   TIMING DVPVO                 0x9F  RW       Bit[7:0]: Y address end[7:0]
          0x380B   TIMING DVPVO
          0x380C   TIMING HTS                   0x0A  RW       Bit[7:4]: Debug mode
          0x380D   TIMING HTS                                  Bit[3:0]: DVP output horizontal width[11:8]
          0x380E   TIMING VTS                   0x20  RW
          0x380F   TIMING VTS                                  Bit[7:0]: DVP output horizontal width[7:0]
          0x3810   TIMING HOFFSET               0x07  RW
          0x3811   TIMING_HOFFSET                              Bit[7:3]: Debug mode
          0x3812   TIMING VOFFSET               0x98  RW       Bit[2:0]: DVP output vertical height[10:8]
          0x3813   TIMING VOFFSET
          0x3814   TIMING X INC                 0x0B  RW       Bit[7:0]: DVP output vertical height[7:0]

          0x3815   TIMING Y INC                 0x1C  RW       Bit[7:5]: Debug mode
                                                               Bit[4:0]: Total horizontal size[12:8]
          0x3816   HSYNC START                  0x07  RW
          0x3817   HSYNC START                                 Bit[7:0]: Total horizontal size[7:0]
          0x3818   HSYNC WIDTH                  0xB0  RW
                                                               Bit[7:0]: Total vertical size[15:8]
          0x3819   HSYNC WIDTH                  0x00  RW
                                                               Bit[7:0]: Total vertical size[7:0]
                                                0x10  RW
                                                               Bit[7:4]: Debug mode
                                                0x00  RW       Bit[3:0]: ISP horizontal offset[11:8]

                                                0x04  RW       Bit[7:0]: Horizontal offset[7:0]

                                                0x11  RW       Bit[7:3]: Debug mode
                                                               Bit[2:0]: Vertical offset[10:8]
                                                0x11  RW
                                                               Bit[7:0]: Vertical offset[7:0]
                                                0x00  RW
                                                               Bit[7:4]: Horizontal odd subsample increment
                                                0x00  RW       Bit[3:0]: Horizontal even subsample increment

                                                0x00  RW       Bit[7:4]: Vertical odd subsample increment
                                                               Bit[3:0]: Vertical even subsample increment
                                                0x00  RW
                                                               Bit[7:4]: Debug mode
                                                               Bit[3:0]: HSYNC start point[11:8]

                                                               Bit[7:0]: HSYNC start point[7:0]

                                                               Bit[7:4]: Debug mode
                                                               Bit[3:0]: HSYNC width[11:8]

                                                               Bit[7:4]: Debug mode
                                                               Bit[3:0]: HSYNC width[7:8]

        proprietary to OmniVision Technologies        PRODUCT SPECIFICATION    version 2.1

                                                                                                 7-13

table 7-7   timing control registers (sheet 3 of 3)
  address
            register name     default                description
  0x3820                      value R/W
            TIMING TC REG20                          Timing Control
  0x3821                      0x40  RW                  Bit[7:3]: Debug mode
            TIMING TC REG21                             Bit[2]: ISP vflip
                              0x00  RW                  Bit[1]: Sensor vflip

                                                     Timing Control
                                                        Bit[7:6]: Debug mode
                                                        Bit[5]: JPEG enable
                                                        Bit[4:3]: Debug mode
                                                        Bit[2]: ISP mirror
                                                        Bit[1]: Sensor mirror
                                                        Bit[0]: Horizontal binning enable

7.8 AEC/AGC power down domain control [0x3A00 ~ 0x3A25]

table 7-8   AEC/AGC power down domain control registers (sheet 1 of 4)
  address
            register name     default                description
  0x3A00                      value R/W
            AEC CTRL00                               AEC System Control (0: disable; 1: enable)
  0x3A01                      0x78  RW                  Bit[7]: Debug mode
  0x3A02    AEC MIN EXPOSURE                            Bit[6]: Less one line enable
  0x3A03    AEC MAX EXPO      0x01  RW                  Bit[5]: Band function enable
  0x3A04    (60HZ)                                      Bit[4]: Less 1 band enable
            AEC MAX EXPO      0x3D  RW                  Bit[3]: Start selection
            (60HZ)                                      Bit[2]: Night mode
            DEBUG MODE        0x80  RW                  Bit[1]: New balance function
                                                        Bit[0]: Freeze
                              -     -
                                                     Minimum Exposure Output Limit
                                                        Bit[7:0]: Minimum exposure

                                                     60Hz Maximum Exposure Output Limit
                                                        Bit[7:0]: Maximum exposure[15:8]

                                                     60Hz Maximum Exposure Output Limit
                                                        Bit[7:0]: Maximum exposure[7:0]

                                                     Debug Mode

07.29.2011  PRODUCT SPECIFICATION                    proprietary to OmniVision Technologies

OV5640  color CMOS QSXGA (5 megapixel) image sensor with OmniBSITM technology

        table 7-8  AEC/AGC power down domain control registers (sheet 2 of 4)
          address
                   register name                default    description
          0x3A05                                value R/W
                   AEC CTRL05
          0x3A06                                0x30  RW   AEC System Control 2
          0x3A07   AEC CTRL06                                 Bit[7]: Debug mode
          0x3A08   AEC CTRL07                                 Bit[6]: frame insert
          0x3A09   AEC B50 STEP                                            0: In night mode, insert frame
          0x3A0A   AEC B50 STEP                                                   disable
          0x3A0B   AEC B60 STEP                                            1: In night mode, insert frame
          0x3A0C   AEC B60 STEP                                                   enable
          0x3A0D   AEC CTRL0C                                 Bit[5]: Step auto enable
          0x3A0E   AEC CTRL0D                                              0: Step manual mode
                   AEC CTRL0E                                              1: Step auto mode
                                                              Bit[4:0]: Step auto ratio
                                                                           In step auto mode, step ratio setting to
                                                                           adjust speed

                                                0x10  RW   AEC System Control 3
                                                              Bit[7:5]: Debug mode
                                                              Bit[4:0]: Step manual setting 1
                                                                           Step manual
                                                                           Increase mode fast step

                                                0x18  RW   AEC Manual Step Register
                                                              Bit[7:4]: Step manual setting 2
                                                                           Step manual, slow step
                                                              Bit[3:0]: Step manual setting 3
                                                                           Step manual, decrease mode fast step

                                                0x01  RW   50Hz Band Width
                                                              Bit[7:2]: Debug mode
                                                              Bit[1:0]: B50 step[9:8]

                                                0x27  RW   50Hz Band Width
                                                              Bit[7:0]: B50 step[7:0]

                                                0x00  RW   60Hz Band Width
                                                              Bit[7:2]: Debug mode
                                                              Bit[1:0]: B60 step[13:8]

                                                0xF6  RW   60Hz Band Width
                                                              Bit[7:0]: B60 step[7:0]

                                                0xE4  RW   Bit[7:4]:    E1 max
                                                           Bit[3:0]:    Decimal line high limit zone
                                                                        E1 min
                                                                        Decimal line low limit zone

                                                0x08  RW   60Hz Max Bands in One Frame
                                                              Bit[7:6]: Debug mode
                                                              Bit[5:0]: B60 max

                                                0x06  RW   50Hz Max Bands in One Frame
                                                              Bit[7:6]: Debug mode
                                                              Bit[5:0]: B50 max

        proprietary to OmniVision Technologies        PRODUCT SPECIFICATION                           version 2.1

                                                                                            7-15

table 7-8   AEC/AGC power down domain control registers (sheet 3 of 4)
  address
            register name     default    description
  0x3A0F                      value R/W
  0x3A10    AEC CTRL0F
  0x3A11    AEC CTRL10        0x78  RW   Stable Range High Limit (Enter)
  0x3A12    AEC CTRL11                      Bit[7:0]: WPT
  0x3A13    DEBUG MODE
            AEC CTRL13        0x68  RW   Stable Range Low Limit (Enter)
  0x3A14                                    Bit[7:0]: BPT
  0x3A15    AEC MAX EXPO
  0x3A16    (50HZ)            0xD0  RW   Step Manual Mode, Fast Zone High Limit
            AEC MAX EXPO                    Bit[7:0]: VPT high
  0x3A17    (50HZ)
            DEBUG MODE        -     -    Debug Mode
  0x3A18
            AEC CTRL17        0x40  RW   Bit[7]:      Debug mode
  0x3A19                                 Bit[6]:      Pre-gain enable
  0x3A1A    AEC GAIN CEILING             Bit[5:0]:    Pre-gain value
  0x3A1B                                              0x40 = 1x
  0x3A1C    AEC GAIN CEILING
  0x3A1D    AEC DIFF MIN      0x0E  RW   50Hz Maximum Exposure Output Limit
            AEC CTRL1B                      Bit[7:4]: Debug mode
            LED ADD ROW                     Bit[3:0]: Max exposure[15:8]
            LED ADD ROW
                              0x40  RW   50Hz Maximum Exposure Output Limit
                                            Bit[7:0]: Max exposure[7:0]

                              -     -    Debug Mode

                              0x01  RW   Gain Base When in Night Mode
                                            Bit[7:2]: Debug mode
                                            Bit[1:0]: Gain night threshold
                                                         00: 00
                                                         01: 10
                                                         10: 30
                                                         11: 70

                              0x03  RW   Gain Output Top Limit
                                            Bit[7:2]: Debug mode
                                            Bit[1:0]: AEC gain ceiling[9:8]
                                                         Real gain format

                              0xE0  RW   Gain Output Top Limit
                                            Bit[7:0]: AEC gain ceiling[7:0]
                                                         Real gain format

                              0x04  RW   Reserved Default Value for This Register
                                            Bit[7:0]: Difference minimal

                              0x78  RW   Stable Range High Limit (Go Out)
                                            Bit[7:0]: WPT2

                              0x06  RW   Exposure Values Added When Strobe is On
                                            Bit[7:0]: AEC LED add row[15:8]

                              0x18  RW   Exposure Values Added When Strobe is On
                                            Bit[7:0]: AEC LED add row[7:0]

07.29.2011  PRODUCT SPECIFICATION                   proprietary to OmniVision Technologies

OV5640  color CMOS QSXGA (5 megapixel) image sensor with OmniBSITM technology

        table 7-8  AEC/AGC power down domain control registers (sheet 4 of 4)
          address
                   register name                default    description
          0x3A1E                                value R/W
          0x3A1F   AEC CTRL1E
                   AEC CTRL1F                   0x68  RW   Stable Range Low Limit (Go Out)
          0x3A20   AEC CTRL20                                 Bit[7:0]: BPT2

          0x3A21   AEC CTRL21                   0x40  RW   Step Manual Mode, Fast Zone Low Limit
          0x3A22~                                             Bit[7:0]: VPT low
          0x3A24
          0x3A25                                0x20  RW   Bit[7:3]:    Debug mode
                                                           Bit[2]:      Strobe option
                                                           Bit[1:0]:    Debug mode

                                                0x78  RW   Bit[7]:      Debug mode
                                                           Bit[6:4]:    Insert frame number
                                                           Bit[3:0]:    Debug mode

                   DEBUG MODE                   -     -    Debug Mode

                   AEC CTRL25                   0x00  RW   Bit[7:5]:    Debug mode
                                                           Bit[4:2]:    Freeze counter
                                                           Bit[1:0]:    Debug mode

        7.9 strobe control [0x3B00 ~ 0x3B0C]

        table 7-9  strobe registers (sheet 1 of 2)
          address
                   register name                default    description
                                                value R/W

        0x3B00 STROBE CTRL                      0x00  RW   Bit[7]:      Strobe request on/off
                                                                        0: Off
                                                           Bit[6]:      1: On
                                                           Bit[3:2]:    Strobe pulse reverse
                                                           Bit[1:0]:    width_in_xenon
                                                                        Strobe mode
                                                                        00: Xenon
                                                                        01: LED1
                                                                        10: LED2
                                                                        11: LED3

        0x3B01 FREX EXPOSURE 02                 0x00  RW   Bit[7:0]: FREX exposure time[23:16]

        0x3B02     FREX SHUTTER                 0x08  RW   Bit[7:6]: Debug mode
                   DELAY 01                                Bit[5:0]: Shutter delay time[12:8]

        0x3B03     FREX SHUTTER                 0x00  RW   Bit[7:0]: Shutter delay time[7:0]
                   DELAY 00                                            Unit: 64x SCLK cycle

        0x3B04 FREX EXPOSURE 01                 0x04  RW   Bit[7:0]: FREX exposure time[15:8]

        proprietary to OmniVision Technologies           PRODUCT SPECIFICATION                    version 2.1

                                                                                                7-17

table 7-9   strobe registers (sheet 2 of 2)
  address
            register name    default         description
                             value R/W

0x3B05 FREX EXPOSURE 00      0x00  RW        Bit[7:0]: FREX exposure time[7:0]
                                                         Unit: Tline

0x3B06 FREX CTRL 07          0x04  RW        Bit[7:4]: FREX frame delay
                                             Bit[3:0]: Strobe width[3:0]

0x3B07 FREX MODE             0x08  RW        FREX Mode Selection
                                                Bit[1:0]: FREX mode
                                                             00: FREX strobe mode0
                                                             01: FREX strobe mode1
                                                             1x: Rolling strobe

0x3B08      FREX REQUEST     0x00  RW        FREX Request
0x3B09      FREX HREF DELAY
                             0x02  RW        FREX HREF Delay

                                             Bit[7:3]:    Debug mode
                                             Bit[2:0]:    FREX precharge length
                                                          000: 1/16 Tline
0x3B0A FREX RST LENGTH       0x04  RW                     001: 1/8 Tline
                                                          010: 1/4 Tline
                                                          011: 1/2 Tline
                                                          100: 1 Tline
                                                          101: 2 Tline
                                                          110: 4 Tline
                                                          111: 8 Tline

0x3B0B      STROBE WIDTH     0x00  RW        Bit[7:0]: Strobe width[19:12]
0x3B0C      STROBE WIDTH
                             0x3D  RW        Bit[7:0]: Strobe width[11:4]

07.29.2011        PRODUCT SPECIFICATION                 proprietary to OmniVision Technologies

OV5640  color CMOS QSXGA (5 megapixel) image sensor with OmniBSITM technology

        7.10 50/60Hz detector control [0x3C00 ~ 0x3C1E]

        table 7-10 5060Hz detector registers (sheet 1 of 2)

        address register name                   default    description
                                                value R/W

        0x3C00 5060HZ CTRL00                    0x00  RW   Bit[7:6]:  Debug mode
                                                           Bit[5]:    Time counter threshold divisor enable
                                                           Bit[4]:    Low limit enable
                                                           Bit[3]:    Debug mode
                                                           Bit[2]:    Band50 default value
                                                           Bit[1:0]:  Time counter threshold
                                                                      00: 1s
                                                                      01: 2s
                                                                      10: 4s
                                                                      11: 8s

        0x3C01 5060HZ CTRL01                    0x00  RW   Bit[7]:      Band manual enable
                                                           Bit[6]:      Band begin reset enable
                                                           Bit[5]:      Sum auto mode enable
                                                           Bit[4]:      Band counter enable
                                                           Bit[3:0]:    Band counter
                                                                        Counter threshold for band change

        0x3C02 5060HZ CTRL02                    0x00  RW   Bit[7:6]:    Debug mode
                                                           Bit[5:0]:    Low light threshold
                                                                        No detection under low light
                                                           Bit[7:6]:    Low light limit mode

        0x3C03  5060HZ CTRL03                   0x00  RW   Bit[7:0]: Counter threshold for low light
        0x3C04
        0x3C05  5060HZ CTRL04                   0x20  RW   Bit[7:0]: Threshold for low sum
        0x3C06
                5060HZ CTRL05                   0x70  RW   Bit[7:0]: Threshold for high sum
        0x3C07
                LIGHT METER1                    0x00  RW   Bit[7:0]: Lightmeter1 threshold[15:8]
        0x3C08  THRESHOLD
                                                0x00  RW   Bit[7:0]: Lightmeter1 threshold[7:0]
        0x3C09  LIGHT METER1
        0x3C0A  THRESHOLD                       0x01  RW   Bit[7:0]: Lightmeter2 threshold[15:8]
        0x3C0B
                LIGHT METER2                    0x2C  RW   Bit[7:0]: Lightmeter2 threshold[7:0]
                THRESHOLD
                                                0x4E  RW   Bit[7:0]: Sample number[15:8]
                LIGHT METER2
                THRESHOLD                       0x1F  RW   Bit[7:0]: Sample number[7:0]

                SAMPLE NUMBER

                SAMPLE NUMBER

        0x3C0C SIGMADELTA CTRL0C -                    R    Bit[7:4]:    Band counter
                                                           Bit[1]:      Sign bit of sum50/60
                                                           Bit[0]:      Band50/60
                                                                        0: 60Hz light
                                                                        1: 50Hz light

        proprietary to OmniVision Technologies           PRODUCT SPECIFICATION                        version 2.1

                                                                                             7-19

table 7-10 5060Hz detector registers (sheet 2 of 2)

address     register name      default  R/W      description
                               value
0x3C0D      SUM 50                      R           Bit[7:5]: Debug mode
                               -                    Bit[4:0]: Sum50[28:24]
0x3C0E      SUM 50                      R           Bit[7:0]: Sum50[23:16]
0x3C0F      SUM 50             -        R           Bit[7:0]: Sum50[15:8]
0x3C10      SUM 50             -        R           Bit[7:0]: Sum50[7:0]
                               -                    Bit[7:5]: Debug mode
0x3C11      SUM 60                      R           Bit[4:0]: Sum60[28:24]
                               -                    Bit[7:0]: Sum60[23:16]
0x3C12      SUM 60                      R           Bit[7:0]: Sum60[15:8]
0x3C13      SUM 60             -        R           Bit[7:0]: Sum60[7:0]
0x3C14      SUM 60             -        R           Bit[7:0]: Sum50/60[15:8]
0x3C15      SUM 50 60          -        R           Bit[7:0]: Sum50/60[7:0]
0x3C16      SUM 50 60          -        R           Bit[7:0]: Block counter[15:8]
0x3C17      BLOCK COUNTER      -        R           Bit[7:0]: Block counter[7:0]
0x3C18      BLOCK COUNTER      -        R           Bit[7:0]: B6[15:8]
0x3C19      B6                 -        R           Bit[7:0]: B6[7:0]
0x3C1A      B6                 -        R           Bit[7:4]: Debug mode
                               -                    Bit[3:0]: Light meter output[19:16]
0x3C1B      LIGHTMETER OUTPUT           R           Bit[7:0]: Light meter output[15:8]
                               -                    Bit[7:0]: Light meter output[7:0]
0x3C1C      LIGHTMETER OUTPUT           R        Sum Threshold
0x3C1D      LIGHTMETER OUTPUT  -        R
0x3C1E      SUM THRESHOLD      -        R
                               -

7.11 OTP control [0x3D00 ~ 0x3D21]

table 7-11 OTP control functions (sheet 1 of 3)

address     register name      default       R/W     description
                               value
0x3D00      OTP DATA00                       RW      OTP Dump/Load Data00
0x3D01      OTP DATA01         0x00          RW      OTP Dump/Load Data01
0x3D02      OTP DATA02         0x00          RW      OTP Dump/Load Data02
                               0x00

07.29.2011  PRODUCT SPECIFICATION                    proprietary to OmniVision Technologies

OV5640  color CMOS QSXGA (5 megapixel) image sensor with OmniBSITM technology

        table 7-11 OTP control functions (sheet 2 of 3)

        address  register name                  default  R/W  description
                                                value
        0x3D03   OTP DATA03                              RW   OTP Dump/Load Data03
        0x3D04   OTP DATA04                     0x00     RW   OTP Dump/Load Data04
        0x3D05   OTP DATA05                     0x00     RW   OTP Dump/Load Data05
        0x3D06   OTP DATA06                     0x00     RW   OTP Dump/Load Data06
        0x3D07   OTP DATA07                     0x00     RW   OTP Dump/Load Data07
        0x3D08   OTP DATA08                     0x00     RW   OTP Dump/Load Data08
        0x3D09   OTP DATA09                     0x00     RW   OTP Dump/Load Data09
        0x3D0A   OTP DATA0A                     0x00     RW   OTP Dump/Load Data0a
        0x3D0B   OTP DATA0B                     0x00     RW   OTP Dump/Load Data0b
        0x3D0C   OTP DATA0C                     0x00     RW   OTP Dump/Load Data0c
        0x3D0D   OTP DATA0D                     0x00     RW   OTP Dump/Load Data0d
        0x3D0E   OTP DATA0E                     0x00     RW   OTP Dump/Load Data0e
        0x3D0F   OTP DATA0F                     0x00     RW   OTP Dump/Load Data0f
        0x3D10   OTP DATA10                     0x00     RW   OTP Dump/Load Data10
        0x3D11   OTP DATA11                     0x00     RW   OTP Dump/Load Data11
        0x3D12   OTP DATA12                     0x00     RW   OTP Dump/Load Data12
        0x3D13   OTP DATA13                     0x00     RW   OTP Dump/Load Data13
        0x3D14   OTP DATA14                     0x00     RW   OTP Dump/Load Data14
        0x3D15   OTP DATA15                     0x00     RW   OTP Dump/Load Data15
        0x3D16   OTP DATA16                     0x00     RW   OTP Dump/Load Data16
        0x3D17   OTP DATA17                     0x00     RW   OTP Dump/Load Data17
        0x3D18   OTP DATA18                     0x00     RW   OTP Dump/Load Data18
        0x3D19   OTP DATA19                     0x00     RW   OTP Dump/Load Data19
        0x3D1A   OTP DATA1A                     0x00     RW   OTP Dump/Load Data1A
        0x3D1B   OTP DATA1B                     0x00     RW   OTP Dump/Load Data1B
        0x3D1C   OTP DATA1C                     0x00     RW   OTP Dump/Load Data1C
        0x3D1D   OTP DATA1D                     0x00     RW   OTP Dump/Load Data1D
        0x3D1E   OTP DATA1E                     0x00     RW   OTP Dump/Load Data1E
        0x3D1F   OTP DATA1F                     0x00     RW   OTP Dump/Load Data1F
                                                0x00

        proprietary to OmniVision Technologies           PRODUCT SPECIFICATION      version 2.1

                                                                                                       7-21

table 7-11 OTP control functions (sheet 3 of 3)

address register name         default                 description
                              value R/W

0x3D20      OTP PROGRAM CTRL  0x00                RW  Bit[7]:      OTP program busy
                                                      Bit[6:2]:    Debug mode
                                                      Bit[1]:      OTP program speed
                                                                   0: Fast
                                                      Bit[0]:      1: Slow
                                                                   OTP program enable

0x3D21      OTP READ CTRL     0x00                RW  Bit[7]:      OTP read busy
                                                      Bit[1]:      OTP read speed
                                                                   0: Fast
                                                      Bit[0]:      1: Slow
                                                                   OTP read enable

7.12 MC control [0x3F00 ~ 0x3F0D]

table 7-12 MC registers (sheet 1 of 3)

address register name         default                 description
                              value R/W

0x3F00      MC CTRL00         0x00            RW      Bit[7:5]:    Debug mode
                                                      Bit[4]:      DW8051 manual reset enable
                                                      Bit[3]:      DW8051 manual reset
                                                      Bit[2]:      IRAM manual reset enable
                                                      Bit[1]:      IRAM manual reset
                                                      Bit[0]:      Soft reset MCU
                                                                   0: Debug mode
                                                                   1: Reset MCU

                                                      Bit[7:0]:    Mask0 for interrupt
                                                                   0: Disable interrupt bit
0x3F01      MC INTERRUPT MASK0 0x00           RW                   1: Enable interrupt bit

                                                      Bit[7:0]:    Mask1 for interrupt
                                                                   0: Disable interrupt bit
0x3F02      MC INTERRUPT MASK1 0x00           RW                   1: Enable interrupt bit

0x3F03 MC READ INTERRUPT 0x70 RW                      Bit[7:0]: Set high byte for SCCB address that
                 ADDRESS                                          will trigger interrupt when read

0x3F04 MC READ INTERRUPT 0x00 RW                      Bit[7:0]: Set low byte for SCCB address that
                 ADDRESS                                          will trigger interrupt when read

0x3F05 MC WRITE INTERRUPT 0x70 RW                     Bit[7:0]: Set high byte for SCCB address that
                 ADDRESS                                          will trigger interrupt when written

0x3F06 MC WRITE INTERRUPT 0x04 RW                     Bit[7:0]: Set low byte for SCCB address that
                 ADDRESS                                          will trigger interrupt when written

07.29.2011             PRODUCT SPECIFICATION          proprietary to OmniVision Technologies

OV5640  color CMOS QSXGA (5 megapixel) image sensor with OmniBSITM technology

        table 7-12 MC registers (sheet 2 of 3)

        address register name                   default    description
                                                value R/W

        0x3F08  MC INTERRUPT                    0x00  RW   Bit[7:6]:    Interrupt1[7] source selection
                                                           Bit[5:4]:    0x: AEC done
                SOURCE SELECTION1                          Bit[3:2]:    10: Debug mode
                                                           Bit[1:0]:    11: DVP HREF falling edge
                                                                        Interrupt1[6] source selection
                                                                        00: ISP average done
                                                                        01: FREX rising edge
                                                                        10: Debug mode
                                                                        11: DVP VSYNC falling edge
                                                                        Interrupt1[5] source selection
                                                                        00: AEC trigger
                                                                        01: FREX falling edge
                                                                        10: MIPI frame end
                                                                        11: DVP VSYNC rising edge
                                                                        Interrupt1[4] source selection
                                                                        0x: JEPG over size
                                                                        10: MIPI line end
                                                                        11: DVP HREF rising edge

        0x3F09  MC INTERRUPT                    0x00  RW   Bit[7:6]:    Interrupt1[3] source selection
                                                           Bit[5:4]:    0x: Debug mode
                SOURCE SELECTION2                          Bit[3:2]:    11: SRM operation start
                                                           Bit[1:0]:    Interrupt1[2] source selection
                                                                        0x: Debug mode
                                                                        11: SRM operation done
                                                                        Interrupt1[1] source selection
                                                                        0x: Debug mode
                                                                        11: DVP frame counter change
                                                                        Interrupt1[0] source selection
                                                                        0x: BLC SOF
                                                                        11: Debug mode

        0x3F0A MC INTERRUPT                     0x00  RW   Bit[7:6]:    Interrupt0[7] source selection
                SOURCE SELECTION3                          Bit[5:4]:    00: JFIFO over flow
                                                           Bit[3:2]:    01: ISP end frame
                                                           Bit[1:0]:    10: SFIFO end of frame
                                                                        11: JFIFO end frame
                                                                        Interrupt0[6] source selection
                                                                        0x: JFIFO end of image
                                                                        10: F1 FIFO write
                                                                        11: VFIFO ready
                                                                        Interrupt0[5] source selection
                                                                        00: ISP end of frame
                                                                        01: SFIFO end of frame
                                                                        10: JFIFO end of frame
                                                                        11: VFIFO end of frame
                                                                        Interrupt0[4] source selection
                                                                        00: ISP start of frame
                                                                        01: SFIFO start of frame
                                                                        10: JFIFO start of frame
                                                                        11: VFIFO start of frame

        proprietary to OmniVision Technologies        PRODUCT SPECIFICATION    version 2.1

                                                                                                7-23

table 7-12 MC registers (sheet 3 of 3)

address register name          default             description
                               value R/W

0x3F0B MC INTERRUPT            0x00            RW  Bit[7:6]:    Interrupt0[3] source selection
            SOURCE SELECTION4                      Bit[5:4]:    0x: AFC done
                                                   Bit[3:2]:    10: HREF falling edge
                                                   Bit[1:0]:    11: BIST done
                                                                Interrupt0[2] source selection
                                                                00: AWB done
                                                                01: ISP start of frame
                                                                10: SFIFO start of frame
                                                                11: JFIFO start of frame
                                                                Interrupt0[1] source selection
                                                                00: VFIFO full
                                                                01: ISP FC SOF
                                                                10: f2_fifo_wr
                                                                11: Write a specific address
                                                                Interrupt0[0] source selection
                                                                00: VFIFO empty
                                                                01: ISP line
                                                                10: ISP end of frame
                                                                11: Read a specific address

0x3F0C      MC INTERRUPT0      -               R   Bit[7:0]: Interrupt0 status indication
0x3F0D      STATUS
                               -               R   Bit[7:0]: Interrupt1 status indication
            MC INTERRUPT1
            STATUS

7.13 BLC control [0x4000 ~ 0x4033]

table 7-13 BLC registers (sheet 1 of 3)

address register name          default             description
                               value R/W
                                                   BLC Control 00 (0: disable; 1: enable)
0x4000      BLC CTRL00         0x89            RW     Bit[7:3]: Debug mode
                                                      Bit[2]: Apply2blackline
0x4001      BLC CTRL01         0x00            RW     Bit[1]: Black line average frame
                                                      Bit[0]: BLC enable

                                                      Bit[7:6]: Debug mode
                                                      Bit[5:0]: BLC start line

07.29.2011              PRODUCT SPECIFICATION      proprietary to OmniVision Technologies

OV5640  color CMOS QSXGA (5 megapixel) image sensor with OmniBSITM technology

        table 7-13 BLC registers (sheet 2 of 3)

        address register name                   default    description
                                                value R/W

        0x4002   BLC CTRL02                     0x45  RW   Bit[7]:      Format change enable
                                                           Bit[6]:      BLC update when format changes
                                                                        BLC auto enable
                                                           Bit[5:0]:    0: Manual
                                                                        1: Auto
                                                                        Reset frame number
                                                                        Frame number BLC do after reset

        0x4003   BLC CTRL03                     0x08  RW   Bit[7]:      BLC redo enable
                                                                        Write 1 to this bit will trigger a BLC
                                                           Bit[6]:      redo N frames begin, where N is
                                                           Bit[5:0]:    0x4003[5:0]
                                                                        BLC freeze
                                                                        Manual frame number

        0x4004   BLC CTRL04                     0x08  RW   Bit[7:0]: BLC line number
                                                                       Specify the line number BLC process

        0x4005   BLC CTRL05                     0x18  RW   Bit[7:2]:    Debug mode
                                                           Bit[1]:      BLC always update
                                                                        0: Normal freeze
                                                           Bit[0]:      1: BLC always update
                                                                        Debug mode

        0x4006   DEBUG MODE                     -     -    Debug Mode

        0x4007   BLC CTRL07                     0x00  RW   Bit[7:5]:    Debug mode
                                                           Bit[4:3]:    Window selection
                                                                        00: Full image
                                                           Bit[2:0]:    01: A windows not contain the first

                                                                               16 pixels and the end 16 pixels
                                                                        10: A windows not contain the first

                                                                               1/16 image and the end 1/16
                                                                               image
                                                                        11: A windows not contain the first
                                                                               1/8 image and the end 1/8
                                                                               image
                                                                        Debug mode

        0x4008   DEBUG MODE                     -     -    Debug Mode
        0x4009   BLACK LEVEL
        0x400C~  DEBUG MODE                     0x10  RW   Bit[7:0]: BLC black level target at 10-bit range
        0x402B
                 BLACK LEVEL00                  -     -    Debug Mode
        0x402C
                                                0x00  RW   Bit[7:0]: Blacklevel00[15:8]
                                                                       With 3 decimal
        0x402D BLACK LEVEL00                    0x00  RW
                                                           Bit[7:0]: Blacklevel00[7:0]
                                                                       With 3 decimal

        proprietary to OmniVision Technologies        PRODUCT SPECIFICATION                   version 2.1

                                                                                        7-25

table 7-13 BLC registers (sheet 3 of 3)

address register name      default            description
                           value R/W
                                                 Bit[7:0]: Blacklevel01[15:8]
0x402E BLACK LEVEL01       0x00          RW                   With 3 decimal

0x402F      BLACK LEVEL01  0x00          RW      Bit[7:0]: Blacklevel01[7:0]
                                                              With 3 decimal
0x4030      BLACK LEVEL10  0x00          RW
                                                 Bit[7:0]: Blacklevel10[15:8]
0x4031      BLACK LEVEL10  0x00          RW                   With 3 decimal

0x4032      BLACK LEVEL11  0x00          RW      Bit[7:0]: Blacklevel10[7:0]
                                                              With 3 decimal
0x4033      BLACK LEVEL11  0x00          RW
                                                 Bit[7:0]: Blacklevel11[15:8]
                                                              With 3 decimal

                                                 Bit[7:0]: Blacklevel11[7:0]
                                                              With 3 decimal

7.14 frame control [0x4201 ~ 0x4202]

table 7-14 frame control registers

address register name      default            description
                           value R/W
                                              Control Passed Frame Number
0x4201      FRAME CTRL01   0x00          R/W  When both ON and OFF number set to 0x00,
                                              frame control is in bypass mode
0x4202      FRAME CTRL02   0x00          R/W
                                                 Bit[7:4]: Debug mode
                                                 Bit[3:0]: Frame ON number

                                              Control Masked Frame Number
                                              When both ON and OFF number set to 0x00,
                                              frame control is in bypass mode

                                                 Bit[7:4]: Debug mode
                                                 BIT[3:0]: Frame OFF number

07.29.2011  PRODUCT SPECIFICATION             proprietary to OmniVision Technologies

OV5640  color CMOS QSXGA (5 megapixel) image sensor with OmniBSITM technology

        7.15 format control [0x4300 ~ 0x430D]

        table 7-15 format control registers (sheet 1 of 5)

        address register name                   default  R/W  description
                                                value
                                                         RW   Format Control 00
                                                0xF8             Bit[7:4]: Output format of formatter module

                                                                           0x0: RAW          Output sequence
                                                                                  Bit[3:0]:  0x0: BGBG... / GRGR...
                                                                                             0x1: GBGB... / RGRG...
                                                                                             0x2: GRGR... / BGBG...
                                                                                             0x3: RGRG... / GBGB...
                                                                                             0x4~0xF: Not allowed

                                                                           0x1: Y8
                                                                                  Bit[3:0]: Does not matter

        0x4300  FORMAT CONTROL                                             0x2: YUV444/RGB888 (not available for
                00                                                                full resolution)
                                                                                  Bit[3:0]: Output sequence
                                                                                              0x0: YUVYUV..., or
                                                                                                      GBRGBR...
                                                                                              0x1: YVUYVU..., or
                                                                                                      GRBGRB...
                                                                                              0x2: UYVUYV..., or
                                                                                                      BGRBGR...
                                                                                              0x3: VYUVYU..., or
                                                                                                      RGBRGB...
                                                                                              0x4: UVYUVY..., or
                                                                                                      BRGBRG...
                                                                                              0x5: VUYVUY..., or
                                                                                                      RBGRBG...
                                                                                              0x6~0xE: Not allowed
                                                                                              0xF: UYVUYV..., or
                                                                                                      BGRBGR...

                                                                           0x3: YUV422
                                                                                  Bit[3:0]: Output sequence
                                                                                              0x0: YUYV...
                                                                                              0x1: YVYU...
                                                                                              0x2: UYVY...
                                                                                              0x3: VYUY...
                                                                                              0x4~0xE: Not allowed
                                                                                              0xF: UYVY...

                                                                           0x4: YUV420
                                                                                  Bit[3:0]: Output sequence
                                                                                              0x0: YYYY... / YUYV...
                                                                                              0x1: YYYY... / YVYU...
                                                                                              0x2: YYYY... / UYVY...
                                                                                              0x3: YYYY... / VYUY...
                                                                                              0x4: YUYV... / YYYY...
                                                                                              0x5: YVYU... / YYYY...

        proprietary to OmniVision Technologies                PRODUCT SPECIFICATION                          version 2.1

                                                                                                      7-27

table 7-15 format control registers (sheet 2 of 5)

address register name  default  R/W  description
                       value
                                                                        0x6: UYVY... / YYYY...
                                                                        0x7: VYUY... / YYYY...
                                                                        0x8~0xE: Not allowed
                                                                        0xF: YYYY... / UYVY...
                                                     0x5: YUV420 (for MIPI only)
                                                            Bit[3:0]: Output sequence
                                                                        0x0~0xD: Not allowed
                                                                        0xE: VYYVYY... /

                                                                                UYYUYY...
                                                                        0xF: UYYUYY... /

                                                                                VYYVYY...
                                                     0x6: RGB565

                                                            Bit[3:0]: Output sequence
                                                                        0x0: {b[4:0],g[5:3]},
                                                                                {g[2:0],r[4:0]}
                                                                        0x1: {r[4:0],g[5:3]},
                                                                                {g[2:0],b[4:0]}
                                                                        0x2: {g[4:0],r[5:3]},
                                                                                {r[2:0],b[4:0]}
                                                                        0x3: {b[4:0],r[5:3]},
                                                                                {r[2:0],g[4:0]}
                                                                        0x4: {g[4:0],b[5:3]},
                                                                                {b[2:0],r[4:0]}
                                                                        0x5: {r[4:0],b[5:3]},
                                                                                {b[2:0],g[4:0]}
                                                                        0x6~0xE: Not allowed
                                                                        0xF: {g[2:0],b[4:0]},
                                                                                {r[4:0],g[5:3]}

                                                     0x7: RGB555 format 1
                                                            Bit[3:0]: Output sequence
                                                                        0x0: {b[4:0],g[4:2]},
                                                                                {g[1:0],1'b0,r[4:0]}
                                                                        0x1: {r[4:0],g[4:2]},
                                                                                {g[1:0],1'b0,b[4:0]}
                                                                         0x2: {g[4:0],r[4:2]},
                                                                                {r[1:0],1'b0,b[4:0]}
                                                                        0x3: {b[4:0],r[4:2]},
                                                                                {r[1:0],1'b0,g[4:0]}
                                                                        0x4: {r[4:0],b[4:2]},
                                                                                {b[1:0],1'b0,g[4:0]}
                                                                        0x5: {g[4:0],b[4:2]},
                                                                                {b[1:0],1'b0,r[4:0]}
                                                                        0x6~0xE: Not allowed
                                                                        0xF: {g[1:0],1'b0,b[4:0]},
                                                                                {r[4:0],g[4:2]}

                                                     0x8: RGB555 format 2
                                                            Bit[3:0]: Output sequence
                                                                        0x0: {1'b0,b[4:0],g[4:3]},
                                                                                {g[2:0],r[4:0]}

07.29.2011  PRODUCT SPECIFICATION                   proprietary to OmniVision Technologies

OV5640  color CMOS QSXGA (5 megapixel) image sensor with OmniBSITM technology

        table 7-15 format control registers (sheet 3 of 5)

        address register name                   default  R/W  description
                                                value
                                                                                                 0x1: {1'b0,r[4:0],g[4:2]},
                                                                                                         {g[2:0],b[4:0]}

                                                                                                 0x2: {1'b0,g[4:0],r[4:2]},
                                                                                                         {r[2:0],b[4:0]}

                                                                                                 0x3: {1'b0,b[4:0],r[4:2]},
                                                                                                         {r[2:0],g[4:0]}

                                                                                                 0x4: {1'b0,r[4:0],b[4:2]},
                                                                                                         {b[2:0],g[4:0]}

                                                                                                 0x5: {1'b0,g[4:0],b[4:2]},
                                                                                                         {b[2:0],r[4:0]}

                                                                                                 0x6: {b[4:0],1'b0,g[4:3]},
                                                                                                         {g[2:0],r[4:0]}

                                                                                                 0x7: {r[4:0],1'b0,g[4:2]},
                                                                                                         {g[2:0],b[4:0]}

                                                                                                 0x8: {g[4:0],1'b0,r[4:2]},
                                                                                                         {r[2:0],b[4:0]}

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
                                                                                                 0xA: {r[3:0],1'b0,b[3:1]},
                                                                                                         {b[0],2'h0,g[3:0],1'b0}
                                                                                                 0xB: {g[3:0],1'b0,b[3:1]},
                                                                                                         {b[0],2'h0,r[3:0],1'b0}
                                                                                                 0xC~0xE: Not allowed

        proprietary to OmniVision Technologies                PRODUCT SPECIFICATION  version 2.1

                                                                                                          7-29

table 7-15 format control registers (sheet 4 of 5)

address register name  default  R/W  description
                       value
                                                                        0xF: {g[0],2'h2,b[3:0],1'b1},
                                                                                {r[3:0],1'b1,g[3:1]}
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
