dffgvhbbjk/2026-NUEDC/God1.0/quartus/ip_core/fifo_uart/fifo_uart_inst.v

fifo_uart	fifo_uart_inst (
	.aclr ( aclr_sig ),
	.data ( data_sig ),
	.rdclk ( rdclk_sig ),
	.rdreq ( rdreq_sig ),
	.wrclk ( wrclk_sig ),
	.wrreq ( wrreq_sig ),
	.q ( q_sig ),
	.rdusedw ( rdusedw_sig ),
	.wrusedw ( wrusedw_sig )
	);
