dffgvhbbjk/2026-NUEDC/pc_tools/app/web_app.py

#!/usr/bin/env python3
"""
web_app.py — 基桩动测仪 Web 界面
================================
Flask + SocketIO 后端, Plotly.js 前端, 两个 Tab:
  串口实时监听 | 采集保存

FPGA 帧格式兼容:
  - 纯 ADC 模式:  AA 55 + len_sel + 24bit×N + chksum
  - ADC + 结果段:  上述 + 0x5A + ver + status + ... + rsum
  自动识别, 有结果段则显示 FPGA 比对, 没有则只显示 PC 判别。

用法:
  python web_app.py                    # http://localhost:5000
  python web_app.py --port 8080
"""
import sys
from pathlib import Path
sys.path.insert(0, str(Path(__file__).parent.parent))  # app/ -> pc_tools/

import argparse, csv, json, os, time
from datetime import datetime
import numpy as np

COEFF_MM_PER_SAMPLE = 11.46  # v=2200m/s: 2200*10.42e-6/2*1000
WIN_START = 135              # 平衡最优窗口起点 (批量扫描优化, 好棒85%+坏棒81%)
WIN_END = 390                # 平衡最优窗口终点

# Keep the raw waveform unchanged.  This debounce is applied only to the
# 5-point trend bit used by the desktop Verilog-equivalent measurement logic.
QIUDAO_GLITCH_MAX_RUN = 4

from flask import Flask, request, jsonify
from flask_socketio import SocketIO, emit

from app.pile_check import (
    load_weights, classify,
    CLS_NAMES, DATA_DIR, WEIGHTS_PATH, SAMPLE_PERIOD_US, NYLON_V_MS,
)
from capture.uart_frame_parser import save_frame, recalc_impact_index

# ============================================================================
# Flask + SocketIO
# ============================================================================
app = Flask(__name__)
app.config['SECRET_KEY'] = 'pile_check_2024'
socketio = SocketIO(app, cors_allowed_origins="*", async_mode='threading')

serial_state = {
    'running': False, 'capture': False, 'thread': None, 'stop_flag': False,
    'outdir': None, 'note': '', 'count': None, 'defect_mm': None, 'hit_count': 0,
    'win_start': WIN_START, 'win_end': WIN_END,  # 可调判定窗口
}

Wq = None

def get_Wq():
    global Wq
    if Wq is None:
        Wq = load_weights()
    return Wq


def _suppress_short_qiudao_runs(qiudao, max_run=QIUDAO_GLITCH_MAX_RUN):
    """Remove isolated short trend runs without filtering the waveform."""
    q = np.asarray(qiudao, dtype=np.int8).copy()
    i = 0
    n = len(q)
    while i < n:
        j = i + 1
        while j < n and q[j] == q[i]:
            j += 1
        if i > 0 and j < n and (j - i) <= max_run and q[i - 1] == q[j]:
            q[i:j] = q[i - 1]
        i = j
    return q


def _is_waveform_csv(path):
    """Recognize measurement CSVs while excluding per-directory summaries."""
    return path.is_file() and path.suffix.lower() == '.csv' and path.name.lower() != 'summary.csv'


def _waveform_files(directory):
    """Find hit CSVs, including nested capture folders when needed."""
    p = Path(directory)
    if not p.is_dir():
        return []

    direct_hits = sorted(
        f for f in p.iterdir()
        if _is_waveform_csv(f) and f.name.lower().startswith('hit_')
    )
    if direct_hits:
        return direct_hits

    nested_hits = sorted(
        f for f in p.rglob('*.csv')
        if _is_waveform_csv(f) and f.name.lower().startswith('hit_')
    )
    if nested_hits:
        return nested_hits

    return sorted(f for f in p.iterdir() if _is_waveform_csv(f))


# ============================================================================
# 帧解析 — 兼容纯 ADC 和 ADC+结果段
# ============================================================================

LEN_TABLE = {0: 64, 1: 128, 2: 256, 3: 512}

def s24(b2, b1, b0):
    v = (b2 << 16) | (b1 << 8) | b0
    return v - (1 << 24) if v & 0x800000 else v


def parse_frame(buf):
    """解析一帧。返回 (frame, consumed) 或 (None, skip)。
    frame 格式:
      {n, samples:[], fpga:{state,confidence,impact_index,defect_index,bottom_index,distance_mm} or None}
    纯 ADC 帧(无结果段): fpga=None
    ADC+结果段: fpga 包含 FPGA 判别信息
    """
    idx = buf.find(b"\xAA\x55")
    if idx < 0:
        return None, max(0, len(buf) - 1)
    if idx > 0:
        return None, idx

    if len(buf) < 3:
        return None, 0

    len_sel = buf[2]
    if len_sel not in LEN_TABLE:
        return None, 1

    n = LEN_TABLE[len_sel]
    data_len = 3 + 3 * n + 1  # header + samples + chksum
    if len(buf) < data_len:
        return None, 0

    # ── 校验和 ──
    data = buf[3:3 + 3 * n]
    chksum = buf[3 + 3 * n]
    calc = (len_sel + sum(data)) & 0xFF
    if calc != chksum:
        return None, 1

    # ── 解析样点 ──
    samples = [s24(data[i], data[i+1], data[i+2]) for i in range(0, 3*n, 3)]

    # ── 尝试解析结果段 (可选) ──
    fpga = None
    tail_start = data_len
    TAIL_LEN = 13  # 0x5A + ver + status + idx_h + imp + def + bot + dist_h + dist_l + thr3 + rsum
    if len(buf) >= tail_start + TAIL_LEN and buf[tail_start] == 0x5A:
        tail = buf[tail_start:tail_start + TAIL_LEN]
        if tail[1] == 0x02:  # ver
            rsum = sum(tail[1:12]) & 0xFF
            if rsum == tail[12]:
                status = tail[2]
                idx_h = tail[3]
                fpga = {
                    'state': status & 0x3,
                    'confidence': (status >> 2) & 0x3,
                    'impact_index': ((idx_h & 1) << 8) | tail[4],
                    'defect_index': (((idx_h >> 1) & 1) << 8) | tail[5],
                    'bottom_index': (((idx_h >> 2) & 1) << 8) | tail[6],
                    'distance_mm': ((tail[7] & 0xF) << 8) | tail[8],
                }
                data_len += TAIL_LEN  # 消耗结果段

    frame = {'n': n, 'samples': samples, 'fpga': fpga}
    return frame, data_len


# ============================================================================
# REST API
# ============================================================================

@app.route('/')
def index():
    return HTML_PAGE


@app.route('/api/ports')
def api_ports():
    """枚举可用串口 — pyserial + Windows 注册表回退, 覆盖高编号 COM 口."""
    ports = []
    seen = set()

    def add(device, description=''):
        if device and device not in seen:
            seen.add(device)
            ports.append({'device': device, 'description': description})

    # ── 方法1: pyserial (标准方式) ──
    try:
        import serial.tools.list_ports
        for p in serial.tools.list_ports.comports():
            add(p.device, p.description or '')
    except Exception:
        pass

    # ── 方法2: Windows 注册表 (HARDWARE\DEVICEMAP\SERIALCOMM) ──
    try:
        import winreg
        for root in (winreg.HKEY_LOCAL_MACHINE,):
            try:
                key = winreg.OpenKey(root, r'HARDWARE\DEVICEMAP\SERIALCOMM')
                i = 0
                while True:
                    try:
                        name, value, _ = winreg.EnumValue(key, i)
                        add(value, name)
                        i += 1
                    except OSError:
                        break
                winreg.CloseKey(key)
            except OSError:
                pass
    except Exception:
        pass

    # ── 方法3: 直接尝试打开 COM1–COM32 (最终回退) ──
    if not ports:
        try:
            import serial
            for n in range(1, 33):
                p = f'COM{n}'
                if p in seen:
                    continue
                try:
                    s = serial.Serial(f'\\\\.\\{p}', timeout=0.01)
                    s.close()
                    add(p, '')
                except Exception:
                    pass
        except Exception:
            pass

    return jsonify({'ports': sorted(ports, key=lambda x: x['device'])})


@app.route('/api/browse_path', methods=['POST'])
def api_browse_path():
    """目录浏览 — 支持前端选择保存路径.
    请求: {path: "D:\\..."}  path为空时返回驱动器列表
    返回: {parent, current, drives, subdirs: [{name, path}]}
    """
    data = request.get_json(silent=True) or {}
    p = data.get('path', '').strip()

    result = {'parent': None, 'current': '', 'drives': [], 'subdirs': []}

    if not p:
        # 返回 Windows 驱动器列表
        import string
        drives = []
        for letter in string.ascii_uppercase:
            root = f'{letter}:\\'
            if os.path.exists(root):
                drives.append({'name': f'本地磁盘 ({letter}:)', 'path': root})
        result['drives'] = drives
        return jsonify(result)

    # 规范化路径
    p = os.path.normpath(p)
    if not os.path.exists(p):
        return jsonify({'error': f'路径不存在: {p}'}), 404
    if not os.path.isdir(p):
        p = os.path.dirname(p)

    result['current'] = p
    result['parent'] = os.path.dirname(p) if os.path.dirname(p) != p else None

    try:
        for entry in sorted(os.scandir(p), key=lambda e: (not e.is_dir(), e.name.lower())):
            if entry.is_dir() and not entry.name.startswith('.'):
                result['subdirs'].append({
                    'name': entry.name,
                    'path': os.path.join(p, entry.name),
                })
    except PermissionError:
        pass

    return jsonify(result)


@app.route('/api/default_save_dir')
def api_default_save_dir():
    """返回默认保存路径"""
    return jsonify({'path': str(DATA_DIR)})


# ============================================================================
# 文件导入: Verilog 算法分析
# ============================================================================

def analyze_samples(samples, defect_mm=None, win_start=None, win_end=None):
    """对原始样点数组运行 Verilog 算法分析 (通用, 可用于文件导入和串口实时).
    返回前端展示所需的所有数据字典, 不含系数相关计算结果 (由前端根据系数动态算).

    win_start, win_end: 可选的判定窗口参数, 未提供时使用全局默认 WIN_START/WIN_END
    """
    _ws = win_start if win_start is not None else WIN_START
    _we = win_end if win_end is not None else WIN_END
    n = len(samples)
    if n < 10:
        return {'error': f'数据点太少: {n}'}

    arr = np.array(samples, dtype=np.float64)

    # ── 1. 归一化: data/128 + 200 ──
    norm = arr / 128.0 + 200.0

    # ── 2. 5点连续递减检测 ──
    qiudao = np.zeros(n, dtype=int)
    for i in range(4, n):
        r1, r2, r3, r4, r5 = norm[i], norm[i-1], norm[i-2], norm[i-3], norm[i-4]
        qiudao[i] = 1 if (r1 > r2 and r2 > r3 and r3 > r4 and r4 > r5) else 0

    # Reject only short isolated trend pulses caused by small ADC spikes.
    # The original samples remain in `arr` for plotting and peak extraction.
    qiudao = _suppress_short_qiudao_runs(qiudao)

    # ── 3. 方向翻转位置 ──
    edge_positions = []
    for i in range(1, n):
        if qiudao[i] != qiudao[i-1]:
            edge_positions.append(i)

    edge_num = {}
    cnt = 0
    for ep in edge_positions:
        cnt += 1
        edge_num[ep] = cnt

    # ── 4. 找第4/5/6/7次翻转 ──
    e4 = e5 = e6 = e7 = None
    for ep in edge_positions:
        if edge_num[ep] == 4: e4 = ep
        if edge_num[ep] == 5: e5 = ep
        if edge_num[ep] == 6: e6 = ep
        if edge_num[ep] == 7: e7 = ep

    # ── 5. 在第4~6翻转区域内找关键波峰/波谷 ──
    marked_points = []
    falling_width = 0
    falling_start = None
    falling_end = None
    region_start = region_end = None

    if e4 is not None and e6 is not None:
        region_start, region_end = e4, e6

        # 找 e4 前后最近的 qiudao 下降段 (用于波峰/波谷定位)
        qiudao_1_start = None
        qiudao_1_end = None
        for i in range(max(0, e4 - 10), min(e6 + 40, n)):
            if qiudao[i] == 1:
                if qiudao_1_start is None:
                    qiudao_1_start = i
            elif qiudao_1_start is not None:
                qiudao_1_end = i - 1
                break
        else:
            qiudao_1_end = min(e6 + 40, n) - 1 if qiudao_1_start is not None else None

        if qiudao_1_start is not None:
            # 找下降段开始处紧邻的局部波峰 (往回找, 最多10点)
            peak_idx = None
            for i in range(qiudao_1_start, max(0, qiudao_1_start - 10), -1):
                if i > 0 and i < n - 1 and arr[i] > arr[i-1] and arr[i] > arr[i+1]:
                    peak_idx = i
                    break
            if peak_idx:
                marked_points.append({'type': 'peak', 'index': peak_idx, 'value': float(arr[peak_idx])})

            # 找下降段结束处紧邻的局部波谷 (往前找, 最多10点)
            if qiudao_1_end:
                valley_idx = None
                for i in range(qiudao_1_end, min(n - 1, qiudao_1_end + 10)):
                    if i > 0 and i < n - 1 and arr[i] < arr[i-1] and arr[i] < arr[i+1]:
                        valley_idx = i
                        break
                if valley_idx:
                    marked_points.append({'type': 'valley', 'index': valley_idx, 'value': float(arr[valley_idx])})

        # 回退: 离 e4 最近的峰/谷
        if not marked_points:
            local_extrema = []
            for i in range(max(0, e4 - 20), min(n - 1, e6 + 20)):
                if i > 0 and i < n - 1 and arr[i] > arr[i-1] and arr[i] > arr[i+1]:
                    local_extrema.append({'type': 'peak', 'index': i, 'value': float(arr[i])})
                elif i > 0 and i < n - 1 and arr[i] < arr[i-1] and arr[i] < arr[i+1]:
                    local_extrema.append({'type': 'valley', 'index': i, 'value': float(arr[i])})
            peaks = [p for p in local_extrema if p['type'] == 'peak']
            valleys = [v for v in local_extrema if v['type'] == 'valley']
            if peaks:
                marked_points.append(min(peaks, key=lambda p: abs(p['index'] - e4)))
            if valleys:
                marked_points.append(min(valleys, key=lambda v: abs(v['index'] - e4)))

    # ── 5b. Verilog 对齐: falling_width = e4→e7 窗口内全部 qiudao=1 样点 ──
    # Verilog: ok_length_cnt 在 global_edge_cnt ∈ [4,5,6] 时累加 qiudao=1,
    #   即从第4次翻转检测后开始, 到第7次翻转(退出区域)前结束 → 样点 [e4, e7)
    # PC 等效: sum(qiudao[e4:e7]), 与 FPGA 逐周期计数一致
    # 若不足7次翻转(信号弱), 回退用 e6 或数据末尾
    if e4 is not None:
        falling_start = e4
        if e7 is not None:
            falling_end = e7
            falling_width = int(qiudao[e4:e7].sum())
        elif e6 is not None:
            falling_end = e6
            falling_width = int(qiudao[e4:e6 + 1].sum())
        else:
            falling_end = min(e4 + 50, n - 1)
            falling_width = int(qiudao[e4:falling_end + 1].sum())

    # ── 6. 找敲击峰 ──
    abs_arr = np.abs(arr)
    impact_idx = int(np.argmax(abs_arr[:min(100, n)]))

    # ── 6b. 冲击峰后的 qiudao 边沿位置 (用于 B2 测距法) ──
    # B2: reflection_pos = e2_after - impact_idx
    # 距离 = reflection_pos × 14.67 (批量扫描最优系数, v~2200m/s fs~96kHz)
    edges_after_impact = [ep for ep in edge_positions if ep > impact_idx]
    e1_after = edges_after_impact[0] if len(edges_after_impact) > 0 else None
    e2_after = edges_after_impact[1] if len(edges_after_impact) > 1 else None
    e3_after = edges_after_impact[2] if len(edges_after_impact) > 2 else None
    reflection_pos = (e2_after - impact_idx) if e2_after is not None else 0

    # ── 7. 所有翻转位置 (用于前端画竖线) ──
    edge_list = [{'index': ep, 'num': edge_num[ep]} for ep in edge_positions]

    # ── 8. 分析窗口内翻转次数 (对应 Verilog qiudao_panjue_edge_cnt) ──
    win_edges = sum(1 for ep in edge_positions if _ws <= ep <= min(_we, n))
    analysis_win = {'start': _ws, 'end': min(_we, n)}

    return {
        'n': n,
        'defect_mm': defect_mm,
        'samples': [float(x) for x in arr],
        'impact_idx': impact_idx,
        'edges': edge_list,
        'e4': e4, 'e5': e5, 'e6': e6, 'e7': e7,
        'region_start': region_start, 'region_end': region_end,
        'marked_points': marked_points,
        'falling_width': falling_width,
        'falling_start': falling_start,  # Verilog: e4 (计数窗口起点)
        'falling_end': falling_end,      # Verilog: e7 (计数窗口终点, 退出区域前)
        'reflection_pos': reflection_pos,  # B2 测距: e2_after - impact_idx (样点数)
        'e1_after': e1_after,             # 冲击后第1边沿
        'e2_after': e2_after,             # 冲击后第2边沿
        'e3_after': e3_after,             # 冲击后第3边沿
        'analysis_win': analysis_win,
        'total_edges': len(edge_positions),
        'win_edges': win_edges,  # 分析窗口[WIN_START, WIN_END]内的翻转次数
    }


def analyze_waveform_file(filepath, win_start=None, win_end=None):
    """读取 CSV 文件 → analyze_samples()"""
    samples = []
    defect_mm = None
    note = ''
    try:
        with open(filepath, encoding='utf-8-sig') as f:
            for row in csv.reader(f):
                if not row: continue
                if row[0].startswith('# note'):
                    note = row[1] if len(row) > 1 else ''
                elif row[0].startswith('# defect_true_mm'):
                    v = row[1].strip()
                    defect_mm = int(v) if v else None
                elif row[0].isdigit():
                    try:
                        samples.append(int(row[1]))
                    except (ValueError, TypeError):
                        # Ignore malformed summary/metadata rows in imported CSVs.
                        continue
    except Exception as e:
        return {'error': str(e)}

    result = analyze_samples(samples, defect_mm, win_start, win_end)
    if 'error' in result:
        return result
    result['note'] = note
    return result


@app.route('/api/data_dirs')
def api_data_dirs():
    """返回指定路径下的子目录列表 (默认 God3.0/data).
    ?path=D:\\... 可指定自定义路径.
    """
    base = request.args.get('path', '')
    base = Path(base) if base else DATA_DIR
    dirs = []
    try:
        if base.exists() and base.is_dir():
            for d in sorted(base.iterdir()):
                if d.is_dir() and not d.name.startswith('.'):
                    n_files = len(_waveform_files(d))
                    dirs.append({'name': d.name, 'path': str(d), 'n_files': n_files})
    except Exception as e:
        return jsonify({'dirs': [], 'error': str(e), 'current_path': str(base)})
    return jsonify({'dirs': dirs, 'current_path': str(base)})


@app.route('/api/data_files')
def api_data_files():
    """返回指定目录下的 CSV 文件列表"""
    dir_path = request.args.get('dir', '')
    files = []
    try:
        p = Path(dir_path)
        if p.exists() and p.is_dir():
            for f in _waveform_files(p):
                files.append({'name': f.name, 'path': str(f)})
    except Exception as e:
        return jsonify({'files': [], 'error': str(e)})
    return jsonify({'files': files})


@app.route('/api/batch_analyze', methods=['POST'])
def api_batch_analyze():
    """批量分析: 对选中的多个目录下所有 CSV 运行 Verilog 算法并统计分类准确率.

    请求: {dirs: [path, ...], threshold: 11}
    真值从目录名自动提取: "好棒"→GOOD, "坏棒"/"坏帮"→DEFECT
    """
    data = request.get_json(silent=True) or {}
    dirs = data.get('dirs', [])
    threshold = data.get('threshold', 11)

    if not dirs:
        return jsonify({'error': '请选择至少一个目录'}), 400

    all_per_file = []       # 每个文件的详细结果
    dir_results = []        # 每个目录的汇总
    win_edges_good = []     # 好棒 win_edges 分布
    win_edges_defect = []   # 坏棒 win_edges 分布
    distance_data = []      # 缺陷距离分析数据 (坏棒+有真值)
    total_tp = total_tn = total_fp = total_fn = 0
    total_files = 0
    errors = []

    for dpath in dirs:
        p = Path(dpath)
        if not p.is_dir():
            continue
        dname = p.name
        # ── 从目录名提取真值标签 ──
        if '好棒' in dname:
            truth = 'GOOD'
        elif '坏棒' in dname or '坏帮' in dname:
            truth = 'DEFECT'
        else:
            truth = 'UNKNOWN'

        csv_files = _waveform_files(p)
        d_tp = d_tn = d_fp = d_fn = 0
        d_errors = []  # 分类错误的文件

        for f in csv_files:
            total_files += 1
            r = analyze_waveform_file(str(f))
            if 'error' in r:
                d_errors.append({'file': f.name, 'error': r['error']})
                continue

            win_e = r.get('win_edges', 0)
            pred = 'DEFECT' if win_e >= threshold else 'GOOD'
            correct = (pred == truth)

            # ── 距离测量数据 (仅坏棒+有真值) ──
            fw = r.get('falling_width', 0)
            true_mm = r.get('defect_mm')

            if truth == 'DEFECT':
                win_edges_defect.append(win_e)
                if correct:
                    d_tp += 1
                    total_tp += 1
                else:
                    d_fn += 1
                    total_fn += 1
                # 收集距离数据 (需要已知真值, B2反射位置)
                refl = r.get('reflection_pos', 0)
                if true_mm is not None and (fw > 0 or refl > 0):
                    distance_data.append({
                        'file': f.name, 'dir': dname,
                        'defect_true_mm': true_mm,
                        'falling_width': fw,
                        'reflection_pos': refl,
                    })
            else:
                win_edges_good.append(win_e)
                if correct:
                    d_tn += 1
                    total_tn += 1
                else:
                    d_fp += 1
                    total_fp += 1

            # 只保留前 6000 条详细记录避免响应过大
            if len(all_per_file) < 6000:
                refl = r.get('reflection_pos', 0)
                all_per_file.append({
                    'file': f.name, 'dir': dname, 'truth': truth,
                    'pred': pred, 'win_edges': win_e, 'correct': correct,
                    'defect_true_mm': true_mm,
                    'falling_width': fw,
                    'reflection_pos': refl,
                })

        n = d_tp + d_tn + d_fp + d_fn
        acc = round((d_tp + d_tn) / n, 4) if n > 0 else 0
        dir_results.append({
            'name': dname, 'path': str(p), 'truth': truth,
            'n_files': n,
            'n_good_pred': d_tn + d_fn,    # 预测为 GOOD 的数量
            'n_defect_pred': d_tp + d_fp,   # 预测为 DEFECT 的数量
            'TP': d_tp, 'TN': d_tn, 'FP': d_fp, 'FN': d_fn,
            'accuracy': acc,
            'errors': d_errors,
        })

    # ── 汇总 ──
    total = total_tp + total_tn + total_fp + total_fn
    def safe_div(a, b): return round(a / b, 4) if b > 0 else 0
    summary = {
        'TP': total_tp, 'TN': total_tn, 'FP': total_fp, 'FN': total_fn,
        'accuracy': safe_div(total_tp + total_tn, total),
        'precision': safe_div(total_tp, total_tp + total_fp),
        'recall': safe_div(total_tp, total_tp + total_fn),
        'f1': safe_div(2 * total_tp, 2 * total_tp + total_fp + total_fn),
    }
    summary['total'] = total

    return jsonify({
        'threshold': threshold,
        'total_files': total_files,
        'total_good': len(win_edges_good),
        'total_defect': len(win_edges_defect),
        'summary': summary,
        'directories': dir_results,
        'per_file': all_per_file,
        'win_edges_good': win_edges_good,
        'win_edges_defect': win_edges_defect,
        'distance_data': distance_data,  # 缺陷距离分析
        'errors': errors,
    })


# ============================================================================
# SocketIO 事件
# ============================================================================

@socketio.on('connect')
def on_connect():
    emit('status', {'msg': '已连接'})


@socketio.on('start_serial')
def on_start_serial(data):
    if serial_state['running']:
        emit('error', {'msg': '串口已在运行中'})
        return
    serial_state.update(capture=False, stop_flag=False, hit_count=0)
    serial_state['thread'] = socketio.start_background_task(
        serial_worker, data.get('port', 'COM3'), data.get('baud', 115200))
    emit('status', {'msg': f'监听已启动: {data.get("port", "COM3")}'})


@socketio.on('start_capture')
def on_start_capture(data):
    if serial_state['running']:
        # 旧采集/监听线程仍挂着 (例如上一轮长采集未干净退出, 或页面重载后线程残留)。
        # 直接拒绝会让前端按钮卡在"采集中"却无采集在跑, 用户无法再启动 → 先安全停掉再重启。
        emit('status', {'msg': '检测到旧采集仍在运行, 正在停止...'})
        serial_state['stop_flag'] = True
        deadline = time.monotonic() + 3.0
        while serial_state['running'] and time.monotonic() < deadline:
            time.sleep(0.05)
        if serial_state['running']:
            emit('error', {'msg': '旧采集停止超时, 请稍后再试 (或重启服务)'})
            return
        # 等旧线程 finally 里的状态事件发完, 避免与新的 capture_status 乱序
        time.sleep(0.2)

    note = data.get('note', '')
    count = data.get('count', None)
    defect_mm = data.get('defect_mm', None)
    outdir_base = data.get('outdir_base', None)

    def _sanitize(text, maxlen=40):
        bad = '\\/:*?"<>| '
        return "".join(("_" if c in bad else c) for c in text.strip())[:maxlen] or "unnamed"

    # 使用用户选择的保存路径, 否则 fallback 到默认 DATA_DIR
    base = Path(outdir_base) if outdir_base else DATA_DIR
    base.mkdir(parents=True, exist_ok=True)
    # 找最大已有编号 +1 (避免目录删除/不连续编号导致的冲突)
    max_seq = 0
    for d in base.iterdir():
        if d.is_dir():
            try:
                n = int(d.name.split('_', 1)[0])
                if n > max_seq:
                    max_seq = n
            except ValueError:
                pass
    seq = max_seq + 1
    sess = f"{seq:02d}_{datetime.now().strftime('%H%M%S')}_{_sanitize(note)}"
    outdir = base / sess
    outdir.mkdir(parents=True)

    serial_state.update(capture=True, stop_flag=False, hit_count=0,
                        outdir=str(outdir), outdir_base=str(base),
                        note=note, count=count, defect_mm=defect_mm)
    serial_state['thread'] = socketio.start_background_task(
        serial_worker, data.get('port', 'COM3'), data.get('baud', 115200))
    emit('status', {'msg': f'采集已启动 → {outdir}'})
    emit('capture_status', {
        'hit': 0, 'count': count, 'remaining': count,
        'outdir': str(outdir), 'note': note, 'defect_mm': defect_mm,
        'running': True,
    })


@socketio.on('stop_serial')
def on_stop_serial():
    serial_state['stop_flag'] = True


@socketio.on('analyze_file')
def on_analyze_file(data):
    """加载并分析 CSV 文件 (Verilog 算法 + 自动标峰)"""
    filepath = data.get('path', '')
    win_start = data.get('win_start', None)
    win_end = data.get('win_end', None)
    if not filepath or not os.path.isfile(filepath):
        emit('analysis_result', {'error': f'文件不存在: {filepath}'})
        return
    result = analyze_waveform_file(filepath, win_start, win_end)
    if result is None:
        emit('analysis_result', {'error': '分析失败'})
    else:
        emit('analysis_result', result)


@socketio.on('set_analysis_window')
def on_set_analysis_window(data):
    """前端调节判定窗口 [win_start, win_end]"""
    ws = data.get('win_start')
    we = data.get('win_end')
    if ws is not None:
        serial_state['win_start'] = int(ws)
    if we is not None:
        serial_state['win_end'] = int(we)


# ============================================================================
# 串口后台线程
# ============================================================================

def serial_worker(port, baud):
    try:
        import serial
    except ImportError:
        socketio.emit('error', {'msg': '需要 pyserial: pip install pyserial'})
        serial_state['running'] = False
        return

    def _open(p, b):
        try:
            return serial.Serial(p, b, timeout=0.05)
        except Exception:
            if p.upper().startswith("COM"):
                try:
                    return serial.Serial(f"\\\\.\\{p}", b, timeout=0.05)
                except Exception:
                    pass
            raise

    try:
        ser = _open(port, baud)
    except Exception as e:
        socketio.emit('error', {'msg': f'无法打开串口 {port}: {e}'})
        serial_state['running'] = False
        return

    serial_state['running'] = True
    W = get_Wq()
    capture = serial_state['capture']
    truth = {'rod_len': None, 'defect_mm': serial_state['defect_mm']}

    buf = bytearray()
    hit = 0
    dropped = 0
    last_rx = time.monotonic()
    IDLE_TIMEOUT = 0.5

    STATE_MAP = {0: "INVALID", 1: "NORMAL", 2: "DEFECT"}
    CONF_MAP = {0: "NONE", 1: "LOW", 2: "HIGH"}

    try:
        while not serial_state['stop_flag']:
            chunk = ser.read(4096)
            now = time.monotonic()
            if chunk:
                buf += chunk
                last_rx = now
            elif buf and (now - last_rx) > IDLE_TIMEOUT:
                dropped += len(buf)
                buf.clear()
                continue

            while buf:
                frame, consumed = parse_frame(bytes(buf))
                if frame is not None:
                    hit += 1
                    serial_state['hit_count'] = hit

                    # ── PC 判别 ──
                    wf = np.array(frame["samples"], dtype=np.int64)
                    rv = classify(W, wf)
                    pc_info = {
                        'prediction': rv['prediction'],
                        'class_name': rv['class_name'],
                        'class_id': rv['class_id'],
                        'distance_mm': rv['distance_mm'],
                        'confidence': rv['confidence'],
                        'valid': rv['valid'],
                    }
                    if rv['valid']:
                        pc_info['peak'] = rv['peak']
                        pc_info['imp'] = rv['imp']
                        pc_info['scores'] = [int(s) for s in rv.get('scores', [])]
                        pc_info['margin'] = rv.get('margin', 0)
                        if rv.get('T0'):
                            pc_info['T0'] = rv['T0']

                    # ── FPGA 信息 (可能为 None) ──
                    fpga_info = None
                    match = None
                    if frame['fpga']:
                        f = frame['fpga']
                        fpga_state = STATE_MAP.get(f['state'], '?')
                        fpga_conf = CONF_MAP.get(f['confidence'], '?')
                        fpga_info = {
                            'state': fpga_state,
                            'confidence': fpga_conf,
                            'impact_index': f['impact_index'],
                            # PC 重算冲击峰 (FPGA 导出值在部分固件下恒为 0, 原始样点才可靠)
                            'impact_recalc': recalc_impact_index(frame['samples']),
                            'defect_index': f['defect_index'],
                            'bottom_index': f['bottom_index'],
                            'distance_mm': f['distance_mm'],
                        }
                        # 一致性
                        match = '✓'
                        if not ((rv['prediction'] == 'GOOD' and fpga_state == 'NORMAL') or
                                (rv['prediction'] == 'DEFECT' and fpga_state == 'DEFECT') or
                                (rv['prediction'] == 'INVALID' and fpga_state == 'INVALID')):
                            match = '✗'

                    # ── 保存 CSV (仅采集模式) ──
                    if capture and serial_state['outdir']:
                        # 构造兼容 save_frame 的 frame dict
                        save_dict = {
                            'n': frame['n'], 'samples': frame['samples'],
                            'result_ready': 1 if frame['fpga'] else 0,
                            'state': frame['fpga']['state'] if frame['fpga'] else 0,
                            'confidence': frame['fpga']['confidence'] if frame['fpga'] else 0,
                            'impact_index': frame['fpga']['impact_index'] if frame['fpga'] else 0,
                            'defect_index': frame['fpga']['defect_index'] if frame['fpga'] else 0,
                            'bottom_index': frame['fpga']['bottom_index'] if frame['fpga'] else 0,
                            'distance_mm': frame['fpga']['distance_mm'] if frame['fpga'] else 0,
                            'threshold': 0,
                        }
                        save_frame(save_dict, hit, serial_state['outdir'],
                                   serial_state['note'], truth)

                    # ── Verilog 算法分析 (PC端) ──
                    vlg = analyze_samples(frame['samples'],
                                          win_start=serial_state.get('win_start'),
                                          win_end=serial_state.get('win_end'))

                    # ── 推送到浏览器 ──
                    socketio.emit('frame', {
                        'hit': hit, 'n_pts': frame['n'],
                        'waveform': frame['samples'],
                        'fpga': fpga_info,
                        'pc': pc_info,
                        'match': match,
                        'capture': capture,
                        'timestamp': datetime.now().strftime('%H:%M:%S'),
                        'vlg': vlg,  # Verilog 算法分析结果
                    })

                    # ── 采集模式: 推送状态更新 (还差N次等) ──
                    if capture:
                        cnt = serial_state['count']
                        socketio.emit('capture_status', {
                            'hit': hit,
                            'count': cnt,
                            'remaining': (cnt - hit) if cnt else None,
                            'outdir': serial_state['outdir'],
                            'note': serial_state['note'],
                            'defect_mm': serial_state['defect_mm'],
                            'running': True,
                            'last_state': fpga_info['state'] if fpga_info else '?',
                            'last_dist': fpga_info['distance_mm'] if fpga_info else None,
                            'last_conf': fpga_info['confidence'] if fpga_info else '?',
                        })

                    del buf[:consumed]

                    if capture and serial_state['count'] and hit >= serial_state['count']:
                        serial_state['stop_flag'] = True
                        socketio.emit('status', {'msg': f'采集完成: {hit} 帧'})
                        break

                elif consumed > 0:
                    dropped += consumed
                    del buf[:consumed]
                else:
                    break

    except Exception as e:
        socketio.emit('error', {'msg': f'串口线程异常: {e}'})
    finally:
        ser.close()
        serial_state['running'] = False
        # 清理采集状态: 避免上一轮留下的 capture/stop_flag 残留,
        # 否则下次 on_start_capture 会误判"旧采集仍在运行"或漏停
        if capture:
            serial_state['capture'] = False
            serial_state['stop_flag'] = False
        outdir_msg = f'  数据目录: {serial_state["outdir"]}' if capture and serial_state['outdir'] else ''
        socketio.emit('status', {
            'msg': f'已断开  |  {hit} 帧, 丢弃 {dropped} 字节{outdir_msg}',
            'serial_running': False,
        })
        if capture:
            socketio.emit('capture_status', {
                'hit': hit, 'count': serial_state['count'],
                'remaining': 0, 'outdir': serial_state['outdir'],
                'note': serial_state['note'], 'defect_mm': serial_state['defect_mm'],
                'running': False,
            })


# ============================================================================
# HTML 页面
# ============================================================================

HTML_PAGE = r'''<!DOCTYPE html>
<html lang="zh-CN">
<head>
<meta charset="UTF-8">
<meta name="viewport" content="width=device-width, initial-scale=1.0">
<title>基桩动测仪</title>
<script src="https://cdn.plot.ly/plotly-3.0.0.min.js"></script>
<script src="https://cdn.socket.io/4.7.5/socket.io.min.js"></script>
<style>
*{box-sizing:border-box;margin:0;padding:0}
body{font-family:'Microsoft YaHei','SimHei',sans-serif;background:#1a1a2e;color:#eee;min-height:100vh}
header{background:#16213e;padding:10px 24px;display:flex;align-items:center;justify-content:space-between}
header h1{font-size:18px;color:#e94560}
.tabs{display:flex;background:#0f3460;padding:0 24px}
.tab{padding:10px 20px;cursor:pointer;border-bottom:3px solid transparent;transition:.2s}
.tab:hover{background:#16213e}
.tab.active{border-bottom-color:#e94560;color:#e94560}
.content{padding:16px;max-width:1200px;margin:0 auto}
.panel{display:none}
.panel.active{display:block}
.card{background:#16213e;border-radius:8px;padding:14px;margin-bottom:12px}
.row{display:flex;gap:10px;flex-wrap:wrap;align-items:center}
input,select,button{padding:7px 12px;border-radius:5px;border:1px solid #444;background:#0f3460;color:#eee;font-size:13px}
button{cursor:pointer;background:#e94560;border:none;font-weight:bold}
button:hover{opacity:.85}
button.secondary{background:#0f3460;border:1px solid #555}
button:disabled{opacity:.4}
label{font-size:12px;color:#aaa}
.plot-container{width:100%;height:400px}
.flex-2{display:grid;grid-template-columns:1fr 1fr;gap:12px}
.result-badge{display:inline-block;padding:2px 8px;border-radius:3px;font-weight:bold;font-size:12px}
.badge-good{background:#1b5e20;color:#81c784}
.badge-defect{background:#b71c1c;color:#ef9a9a}
.badge-invalid{background:#555;color:#ccc}
.match-ok{color:#4caf50}
.match-fail{color:#f44336}
.measure-bar{display:flex;align-items:center;gap:10px;margin:8px 0}
#toast{position:fixed;bottom:16px;right:16px;padding:10px 16px;border-radius:6px;display:none;z-index:999;font-size:13px}
.toast-info{background:#0f3460;border:1px solid #448aff}
.toast-error{background:#3e1010;border:1px solid #e94560}
.fpga-na{color:#666;font-style:italic}
.dir-check-row{display:flex;align-items:center;padding:3px 8px;border-bottom:1px solid #222;font-size:12px}
.dir-check-row:hover{background:#0f3460}
.dir-check-row input[type=checkbox]{margin-right:8px;accent-color:#e94560}
.tag-good{background:#1b5e20;color:#81c784;padding:1px 6px;border-radius:3px;font-size:10px;font-weight:bold}
.tag-defect{background:#b71c1c;color:#ef9a9a;padding:1px 6px;border-radius:3px;font-size:10px;font-weight:bold}
.mx-cell{text-align:center;padding:8px 14px;font-size:20px;font-weight:bold}
.mx-diag{color:#4caf50}
.mx-off{color:#f44336}
.mx-label{font-size:11px;color:#888;display:block;text-align:center;margin-top:2px}
.stat-num{font-size:22px;font-weight:bold;margin:2px 0}
.stat-good{color:#4caf50}
.stat-warn{color:#ffab40}
.stat-info{color:#448aff}
/* 采集保存 — 波形+侧边栏 */
.capture-layout{display:flex;gap:12px}
.capture-plot{flex:1;min-width:0}
.capture-sidebar{width:280px;flex-shrink:0;background:#0f1a2e;border-radius:8px;padding:14px;font-size:12px;display:flex;flex-direction:column;gap:12px}
.cap-section-title{color:#888;font-size:11px;text-transform:uppercase;letter-spacing:1px;border-bottom:1px solid #222;padding-bottom:4px;margin-bottom:2px}
.cap-info-row{display:flex;justify-content:space-between;align-items:center;padding:2px 0}
.cap-info-label{color:#888;font-size:11px}
.cap-info-value{color:#eee;font-weight:bold;font-size:12px;text-align:right;max-width:160px;overflow:hidden;text-overflow:ellipsis}
.cap-countdown{font-size:24px;font-weight:bold;text-align:center;padding:8px;border-radius:6px;margin:4px 0}
.cap-countdown.active{color:#ffab40;background:#1a1200}
.cap-countdown.done{color:#4caf50;background:#0a1a0a}
.cap-progress-bar{height:6px;background:#222;border-radius:3px;overflow:hidden}
.cap-progress-fill{height:100%;background:#ffab40;transition:width .3s}
.cap-last-hit{font-size:11px;color:#aaa;line-height:1.6}
.cap-last-hit .state-DEFECT{color:#f44336}
.cap-last-hit .state-NORMAL{color:#4caf50}
.cap-last-hit .state-INVALID{color:#888}
/* 目录浏览弹窗 */
.browse-overlay{position:fixed;top:0;left:0;right:0;bottom:0;background:rgba(0,0,0,.7);z-index:1000;display:flex;align-items:center;justify-content:center}
.browse-dialog{background:#1a2a3e;border-radius:10px;width:560px;max-height:70vh;display:flex;flex-direction:column;box-shadow:0 8px 32px rgba(0,0,0,.6)}
.browse-header{padding:14px 18px;border-bottom:1px solid #333;display:flex;justify-content:space-between;align-items:center}
.browse-header h3{margin:0;font-size:16px}
.browse-path-bar{display:flex;align-items:center;gap:6px;padding:10px 18px;background:#0f1a2e;font-size:12px;border-bottom:1px solid #222}
.browse-path-bar span{color:#448aff;cursor:pointer}
.browse-path-bar span:hover{text-decoration:underline}
.browse-list{flex:1;overflow-y:auto;padding:8px}
.browse-item{display:flex;align-items:center;gap:8px;padding:8px 12px;cursor:pointer;border-radius:5px;font-size:13px;transition:background .15s}
.browse-item:hover{background:#0f3460}
.browse-item.drive{border-bottom:1px solid #222}
.browse-item .icon{font-size:18px}
.browse-footer{padding:12px 18px;border-top:1px solid #333;display:flex;justify-content:space-between}
/* 自动编号预览 */
.folder-preview{font-size:11px;color:#ffab40;font-family:Consolas,monospace;white-space:nowrap;overflow:hidden;text-overflow:ellipsis}
</style>
</head>
<body>
<header>
  <h1>基桩动测仪</h1>
  <span id="connStatus" style="font-size:12px;color:#888">连接中...</span>
</header>

<div class="tabs">
  <div class="tab active" onclick="switchTab('serial')">📡 串口监听</div>
  <div class="tab" onclick="switchTab('capture')">💾 采集保存</div>
  <div class="tab" onclick="switchTab('import')">📂 文件导入</div>
  <div class="tab" onclick="switchTab('error')">📊 误差分析</div>
</div>

<div class="content">

<!-- ====== Tab: 串口监听 ====== -->
<div id="panel-serial" class="panel active">
  <div class="card">
    <div class="row">
      <select id="serPort" style="width:180px"></select>
      <label>波特率: <input id="serBaud" type="number" value="115200" style="width:90px"></label>
      <button id="btnSerConn" onclick="toggleSerial()">▶ 连接</button>
      <span id="serStatus" style="color:#aaa;font-size:12px">未连接</span>
      <span id="serHitCount" style="font-weight:bold;font-size:13px"></span>
    </div>
    <div class="measure-bar">
      <label>波速: <input id="serVelocity" type="number" value="2200" style="width:70px"> m/s</label>
      <label>测距方法: <select id="serMethod" onchange="onMethodChange('ser')"><option value="b2">B2反射位</option><option value="falling">下降段宽度</option></select></label>
      <label>系数: <input id="serCoeff" type="number" value="14.67" step="0.01" style="width:70px" oninput="recalcSerDist()"> <span id="serCoeffUnit">mm/样点(B2)</span></label>
      <label>判定阈值: <input id="serThresh" type="number" value="8" min="1" style="width:60px" oninput="recalcSerDist()"> 次翻转</label>
      <label>分析窗口: <input id="serWinStart" type="number" value="135" min="0" max="500" style="width:64px" oninput="onSerWindowChange()"> ~ <input id="serWinEnd" type="number" value="390" min="0" max="512" style="width:64px" oninput="onSerWindowChange()"><button class="secondary" onclick="resetWindow('ser')" title="恢复窗口默认" style="font-size:11px;padding:2px 5px;margin-left:4px">↺</button></label>
      <button class="secondary" onclick="startMeasure('ser')">📏 测距</button>
      <button class="secondary" onclick="resetMeasure('ser')">🔄 复位</button>
      <span id="serMeasureInfo" style="color:#ffab40;font-size:12px"></span>
    </div>
  </div>
  <div class="card"><div id="serPlot" class="plot-container"></div></div>
  <div id="serInfo"></div>
</div>

<!-- ====== Tab: 采集保存 ====== -->
<div id="panel-capture" class="panel">
  <div class="card">
    <!-- 第1行: 串口 + 按钮 -->
    <div class="row">
      <select id="capPort" style="width:180px"></select>
      <label>波特率: <input id="capBaud" type="number" value="115200" style="width:90px"></label>
      <button id="btnCapConn" onclick="toggleCapture()">▶ 开始采集</button>
      <button class="secondary" id="btnCapStop" onclick="stopCapture()" style="display:none">⏹ 停止</button>
      <span id="capStatus" style="color:#aaa;font-size:12px">未开始</span>
    </div>
    <!-- 第2行: 保存路径 + 自动编号预览 -->
    <div class="row" style="margin-top:8px">
      <label style="white-space:nowrap">保存路径:</label>
      <input id="capSavePath" style="flex:1;min-width:300px;font-size:11px;font-family:Consolas,monospace" oninput="updateCapFolderPreview()">
      <button class="secondary" onclick="browseSavePath()" style="white-space:nowrap">📁 浏览...</button>
      <span class="folder-preview" id="capFolderPreview" style="margin-left:8px"></span>
    </div>
    <!-- 第3行: 采集信息 (匹配原始工具提示语) -->
    <div class="row" style="margin-top:6px">
      <label style="white-space:nowrap">这次采什么?</label>
      <input id="capNote" placeholder="如: 缺陷棒 缺陷30mm 中敲" style="width:180px" oninput="updateCapFolderPreview()">
      <label style="white-space:nowrap">计划敲几次?</label>
      <input id="capCount" type="number" placeholder="回车=不限" style="width:80px" min="1">
      <label style="white-space:nowrap">缺陷真实位置 mm?</label>
      <input id="capDefectMm" type="number" placeholder="正常棒直接回车" style="width:100px">
    </div>
    <div class="measure-bar">
      <label>波速: <input id="capVelocity" type="number" value="2200" style="width:70px"> m/s</label>
      <button class="secondary" onclick="startMeasure('cap')">📏 测距</button>
      <button class="secondary" onclick="resetMeasure('cap')">🔄 复位</button>
      <span id="capMeasureInfo" style="color:#ffab40;font-size:12px"></span>
    </div>
  </div>

  <!-- 波形图 + 右侧状态面板 -->
  <div class="capture-layout">
    <div class="capture-plot card" style="padding:0"><div id="capPlot" class="plot-container"></div></div>
    <div class="capture-sidebar" id="capSidebar">
      <div class="cap-section-title">📋 采集信息</div>
      <div class="cap-info-row"><span class="cap-info-label">说明</span><span class="cap-info-value" id="capSiNote">-</span></div>
      <div class="cap-info-row"><span class="cap-info-label">目标次数</span><span class="cap-info-value" id="capSiCount">不限</span></div>
      <div class="cap-info-row"><span class="cap-info-label">缺陷位置</span><span class="cap-info-value" id="capSiDefect">未设置</span></div>
      <div class="cap-info-row"><span class="cap-info-label">保存目录</span><span class="cap-info-value" id="capSiDir" style="font-size:10px">-</span></div>

      <div class="cap-section-title">📊 采集进度</div>
      <div>已采集: <b id="capSiHit" style="font-size:20px;color:#448aff">0</b> 帧</div>
      <div id="capCountdown" class="cap-countdown" style="display:none"></div>
      <div class="cap-progress-bar"><div class="cap-progress-fill" id="capProgressFill" style="width:0%"></div></div>

      <div class="cap-section-title">🔍 最近一帧</div>
      <div class="cap-last-hit" id="capLastHit">等待中...</div>
    </div>
  </div>
  <div id="capInfo"></div>
</div>

<!-- 目录浏览弹窗 -->
<div id="browseOverlay" class="browse-overlay" style="display:none" onclick="if(event.target===this)closeBrowseModal()">
  <div class="browse-dialog">
    <div class="browse-header">
      <h3>📁 选择保存目录</h3>
      <button class="secondary" onclick="closeBrowseModal()" style="font-size:18px;padding:2px 8px">✕</button>
    </div>
    <div class="browse-path-bar" id="browsePathBar"></div>
    <div class="browse-list" id="browseList"></div>
    <div class="browse-footer">
      <button class="secondary" onclick="navigateBrowse(null)">🖥 驱动器列表</button>
      <button onclick="selectBrowseDir()">✅ 选择此目录</button>
    </div>
  </div>
</div>

<!-- ====== Tab: 文件导入 ====== -->
<div id="panel-import" class="panel">
  <div class="card">
    <!-- 第1行: 数据目录路径 + 浏览 -->
    <div class="row">
      <label style="white-space:nowrap">数据目录:</label>
      <input id="impDataPath" style="flex:1;min-width:280px;font-size:11px;font-family:Consolas,monospace" onchange="onImpPathChange()">
      <button class="secondary" onclick="browseImportPath()" style="white-space:nowrap">📁 浏览...</button>
      <span style="color:#888;font-size:11px" id="impPathInfo"></span>
    </div>
    <!-- 第2行: 子目录 + 文件选择 + 分析按钮 -->
    <div class="row" style="margin-top:8px">
      <select id="impDir" style="width:300px" onchange="loadFileList()">
        <option value="">-- 选择子目录 (可选) --</option>
      </select>
      <select id="impFile" style="width:260px">
        <option value="">-- 选择 CSV 文件 --</option>
      </select>
      <button id="btnAnalyze" onclick="analyzeFile()">🔍 加载分析</button>
      <button class="secondary" onclick="prevFile()" title="上一个CSV文件" style="font-size:12px;padding:4px 8px">◀ 上一个</button>
      <button class="secondary" onclick="nextFile()" title="下一个CSV文件" style="font-size:12px;padding:4px 8px">下一个 ▶</button>
      <button class="secondary" onclick="copyPath('impFile')" title="复制当前选中CSV的完整路径" style="font-size:12px;padding:4px 8px">📋</button>
    </div>
    <div class="row" style="margin-top:8px">
      <label>测距方法: <select id="impMethod" onchange="onMethodChange('imp')"><option value="b2">B2反射位</option><option value="falling">下降段宽度</option></select></label>
      <label>系数: <input id="impCoeff" type="number" value="14.67" step="0.01" style="width:70px" oninput="recalcImportDist()"> <span id="impCoeffUnit">mm/样点(B2)</span></label>
      <label>判定阈值: <input id="impThresh" type="number" value="8" min="1" style="width:60px" oninput="recalcImportDist()"> 次翻转</label>
      <label>分析窗口: <input id="impWinStart" type="number" value="135" min="0" max="500" style="width:64px" oninput="onImpWindowChange()"> ~ <input id="impWinEnd" type="number" value="390" min="0" max="512" style="width:64px" oninput="onImpWindowChange()"><button class="secondary" onclick="resetWindow('imp')" title="恢复窗口默认" style="font-size:11px;padding:2px 5px;margin-left:4px">↺</button></label>
      <span style="color:#aaa;font-size:11px">(默认 120~512)</span>
    </div>
    <div class="measure-bar">
      <button class="secondary" onclick="startMeasure('imp')">📏 测距</button>
      <button class="secondary" onclick="resetMeasure('imp')">🔄 复位</button>
      <span id="impMeasureInfo" style="color:#ffab40;font-size:12px"></span>
    </div>
  </div>
  <div class="card"><div id="impPlot" class="plot-container"></div></div>
  <div id="impResult"></div>
</div>

<!-- 文件导入 — 目录浏览弹窗 -->
<div id="impBrowseOverlay" class="browse-overlay" style="display:none" onclick="if(event.target===this)closeImpBrowse()">
  <div class="browse-dialog">
    <div class="browse-header">
      <h3>📁 选择数据目录</h3>
      <button class="secondary" onclick="closeImpBrowse()" style="font-size:18px;padding:2px 8px">✕</button>
    </div>
    <div class="browse-path-bar" id="impBrowsePathBar"></div>
    <div class="browse-list" id="impBrowseList"></div>
    <div class="browse-footer">
      <button class="secondary" onclick="navigateImpBrowse(null)">🖥 驱动器列表</button>
      <button onclick="selectImpBrowseDir()">✅ 选择此目录</button>
    </div>
  </div>
</div>
</div>

<!-- ====== Tab: 误差分析 ====== -->
<div id="panel-error" class="panel">
  <div class="card">
    <!-- 第1行: 数据根目录 + 浏览 -->
    <div class="row" style="align-items:center">
      <label style="white-space:nowrap">数据根目录:</label>
      <input id="errDataPath" style="flex:1;min-width:300px;font-size:11px;font-family:Consolas,monospace" onchange="onErrPathChange()">
      <button class="secondary" onclick="copyPath('errDataPath')" title="复制当前数据根目录路径" style="font-size:12px;padding:4px 8px">📋</button>
      <button class="secondary" onclick="browseErrorPath()" style="white-space:nowrap">📁 浏览...</button>
      <span style="color:#888;font-size:11px" id="errPathInfo"></span>
    </div>
    <!-- 第2行: 阈值 + 距离系数 + 全选/取消 + 批量分析 -->
    <div class="row" style="margin-top:8px;align-items:center">
      <label>判定阈值: <input id="errThresh" type="number" value="8" min="1" style="width:60px"> 次翻转</label>
      <label>测距方法: <select id="errMethod" onchange="onMethodChange('err')"><option value="b2">B2反射位</option><option value="falling">下降段宽度</option></select></label>
      <label>距离系数: <input id="errCoeff" type="number" value="14.67" step="0.01" style="width:65px"> <span id="errCoeffUnit">mm/样点(B2)</span></label>
      <button class="secondary" onclick="errSelectAll()">☑ 全选</button>
      <button class="secondary" onclick="errDeselectAll()">☐ 取消</button>
      <button id="btnErrRun" onclick="runBatchAnalyze()" style="font-size:14px;padding:10px 24px">🚀 批量分析</button>
      <span id="errProgress" style="color:#ffab40;font-size:12px;margin-left:8px"></span>
    </div>
    <div id="errDirList" style="max-height:340px;overflow-y:auto;margin-top:8px;border:1px solid #333;border-radius:4px;padding:6px">
      <span style="color:#888">加载中...</span>
    </div>
  </div>

  <div id="errSummary" class="card" style="display:none"></div>

  <div class="flex-2">
    <div class="card"><div id="errScatter" class="plot-container"></div></div>
    <div class="card"><div id="errHist" class="plot-container"></div></div>
  </div>

  <div id="errDetails" class="card" style="display:none"></div>

  <!-- 缺陷距离误差分析 (仅坏棒) -->
  <div id="distSection" style="display:none">
    <h3 style="margin:16px 0 8px;color:#ffab40;border-bottom:1px solid #333;padding-bottom:4px">
      📏 缺陷距离测量误差
    </h3>
    <div id="distSummary" class="card"></div>
    <div class="flex-2">
      <div class="card"><div id="distScatter" class="plot-container"></div></div>
      <div class="card"><div id="distHist" class="plot-container"></div></div>
    </div>
  </div>
</div>

<!-- 误差分析 — 目录浏览弹窗 -->
<div id="errBrowseOverlay" class="browse-overlay" style="display:none" onclick="if(event.target===this)closeErrBrowse()">
  <div class="browse-dialog">
    <div class="browse-header">
      <h3>📁 选择数据根目录</h3>
      <button class="secondary" onclick="closeErrBrowse()" style="font-size:18px;padding:2px 8px">✕</button>
    </div>
    <div class="browse-path-bar" id="errBrowsePathBar"></div>
    <div class="browse-list" id="errBrowseList"></div>
    <div class="browse-footer">
      <button class="secondary" onclick="navigateErrBrowse(null)">🖥 驱动器列表</button>
      <button onclick="selectErrBrowseDir()">✅ 选择此目录</button>
    </div>
  </div>
</div>

<div id="toast"></div>

<script>
const socket = io();
const SAMPLE_US = 10.42, DEFAULT_V = 2200;
let measureState = {};
let lastImpData = null;  // 缓存最近一次文件分析结果, 用于系数联动
let lastImpPath = '';    // 当前分析的文件完整路径, 用于复制
let lastSerData = null;  // 缓存最近一次串口分析结果, 用于系数联动

// ── 测距方法管理 ──
const DIST_METHODS = {
  b2:      {coeff: 14.67, label: 'B2反射位',  desc: '冲击峰后第2边沿 - 冲击峰'},
  falling: {coeff: 15,    label: '下降段宽度', desc: 'e4~e7区域 qiudao=1 周期数'},
};

function getActiveMethod(ctx) {
  const sel = document.getElementById(ctx + 'Method');
  return (sel && sel.value) ? sel.value : 'b2';
}

function getDistValue(data, method) {
  // 返回指定方法的测距特征值 (样点数)
  if (method === 'falling') return data.falling_width || 0;
  return data.reflection_pos || 0;  // b2 (默认)
}

function getDistLabel(method) {
  return (DIST_METHODS[method] || DIST_METHODS['b2']).label;
}

function onMethodChange(ctx) {
  const method = getActiveMethod(ctx);
  const info = DIST_METHODS[method] || DIST_METHODS['b2'];

  // 更新系数默认值
  const coeffEl = document.getElementById(ctx + 'Coeff');
  if (coeffEl) coeffEl.value = info.coeff;

  // 更新系数标签
  const unitEl = document.getElementById(ctx + 'CoeffUnit');
  if (unitEl) unitEl.textContent = 'mm/样点(' + info.label + ')';

  // 触发重新计算
  if (ctx === 'imp') recalcImportDist();
  else if (ctx === 'ser') recalcSerDist();
  else if (ctx === 'err' && window._lastErrData) renderDistAnalysis(window._lastErrData);
}

// ── SocketIO ──
socket.on('connect', () => {
  document.getElementById('connStatus').textContent = '● 已连接';
  document.getElementById('connStatus').style.color = '#4caf50';
});
socket.on('disconnect', () => {
  document.getElementById('connStatus').textContent = '● 断开';
  document.getElementById('connStatus').style.color = '#f44336';
});
socket.on('status', d => toast(d.msg, 'info'));
socket.on('error', d => toast(d.msg, 'error'));

socket.on('frame', data => {
  const ctx = data.capture ? 'cap' : 'ser';
  updatePlot(ctx, data);
  updateInfo(ctx, data);

  // ── 串口监听 Tab: Verilog 实时分析 ──
  if (!data.capture && data.vlg && !data.vlg.error) {
    lastSerData = {
      vlg: data.vlg, fpga: data.fpga,
      hit: data.hit, n_pts: data.n_pts, match: data.match,
    };
    // 同步窗口输入框显示实际使用的窗口
    if (data.vlg.analysis_win) {
      document.getElementById('serWinStart').value = data.vlg.analysis_win.start;
      document.getElementById('serWinEnd').value = data.vlg.analysis_win.end;
    }
    updateVlgInfo('ser', data.vlg, data.fpga, data.match);
  }

  if (data.capture) {
    document.getElementById('capStatus').textContent = `采集中: ${data.hit} 帧 | ${data.timestamp}`;
  } else {
    document.getElementById('serHitCount').textContent = `#${data.hit}`;
    document.getElementById('serStatus').textContent = `监听中 | ${data.timestamp}`;
  }
});

// ── Tab 切换 ──
function switchTab(name) {
  document.querySelectorAll('.tab').forEach(t => t.classList.remove('active'));
  document.querySelectorAll('.panel').forEach(p => p.classList.remove('active'));
  const idx = name==='serial'?1:name==='capture'?2:name==='import'?3:4;
  document.querySelector(`.tab:nth-child(${idx})`).classList.add('active');
  document.getElementById(`panel-${name}`).classList.add('active');
  refreshPorts();
  if (name === 'import') loadDirs();
  if (name === 'error') loadErrDirs();
}

// ── 串口列表 ──
async function refreshPorts() {
  try {
    const r = await fetch('/api/ports');
    const d = await r.json();
    const opts = d.ports.map(p => `<option value="${p.device}">${p.device} - ${p.description}</option>`).join('');
    ['serPort','capPort'].forEach(id => {
      const el = document.getElementById(id);
      if (el) el.innerHTML = opts || '<option>无可用串口</option>';
    });
    if (d.error) console.warn('端口扫描警告:', d.error);
  } catch(e) {
    console.error('获取串口列表失败:', e);
    ['serPort','capPort'].forEach(id => {
      const el = document.getElementById(id);
      if (el) el.innerHTML = '<option value="">获取失败, 请刷新页面重试</option>';
    });
  }
}

// 页面加载时执行一次, 之后切 Tab 也刷新
refreshPorts();

// ── 串口连接 ──
function toggleSerial() {
  const btn = document.getElementById('btnSerConn');
  if (btn.textContent.includes('连接')) {
    const port = document.getElementById('serPort').value;
    const baud = parseInt(document.getElementById('serBaud').value) || 115200;
    if (!port) { toast('请选择串口', 'error'); return; }
    socket.emit('start_serial', {port, baud});
    btn.textContent = '⏹ 断开'; btn.style.background = '#555';
    document.getElementById('serStatus').textContent = '连接中...';
  } else {
    socket.emit('stop_serial');
    btn.textContent = '▶ 连接'; btn.style.background = '#e94560';
    document.getElementById('serStatus').textContent = '未连接';
    document.getElementById('serHitCount').textContent = '';
  }
}

function toggleCapture() {
  const btn = document.getElementById('btnCapConn');
  if (btn.textContent.includes('开始')) {
    const port = document.getElementById('capPort').value;
    const baud = parseInt(document.getElementById('capBaud').value) || 115200;
    const note = document.getElementById('capNote').value || '';
    const c = document.getElementById('capCount').value;
    const count = c ? parseInt(c) : null;
    const d = document.getElementById('capDefectMm').value;
    const defect_mm = d ? parseInt(d) : null;
    const outdir_base = document.getElementById('capSavePath').value || '';
    if (!port) { toast('请选择串口', 'error'); return; }
    if (!socket.connected) { toast('与服务器连接已断开, 请刷新页面重试', 'error'); return; }

    // 初始化侧边栏
    document.getElementById('capSiNote').textContent = note || '(未填写)';
    document.getElementById('capSiCount').textContent = count || '不限';
    document.getElementById('capSiDefect').textContent = defect_mm ? defect_mm+' mm' : '未设置';
    document.getElementById('capSiHit').textContent = '0';
    document.getElementById('capCountdown').style.display = count ? 'block' : 'none';
    if (count) {
      document.getElementById('capCountdown').className = 'cap-countdown active';
      document.getElementById('capCountdown').textContent = '还差 '+count+' 次';
    }
    document.getElementById('capProgressFill').style.width = '0%';
    document.getElementById('capLastHit').textContent = '等待敲击...';

    socket.emit('start_capture', {port, baud, note, count, defect_mm, outdir_base});
    btn.style.display = 'none';
    document.getElementById('btnCapStop').style.display = '';
    document.getElementById('capStatus').textContent = '采集中...';
    document.getElementById('capStatus').style.color = '#ffab40';
  }
}
function stopCapture() {
  socket.emit('stop_serial');
  document.getElementById('btnCapConn').style.display = '';
  document.getElementById('btnCapStop').style.display = 'none';
  document.getElementById('btnCapConn').textContent = '▶ 开始采集';
  document.getElementById('btnCapConn').style.background = '#e94560';
  document.getElementById('capStatus').textContent = '已停止';
  document.getElementById('capStatus').style.color = '#aaa';
}
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
