dffgvhbbjk/2026-NUEDC/(commit log)

2026-08-02 Add design report (设计报告_优化版.docx)
2026-08-02 add God1.0: FPGA基桩检测示波器工程 + OV5640缝隙检测分析脚本
    [config_adds.txt, fpga_official_config.txt, official_config.txt]
